vgisc/cryptech.hardware/schematics/rev02.pdf

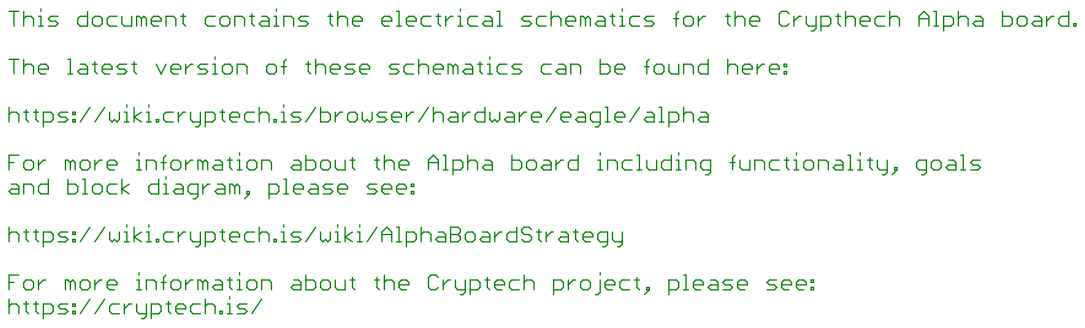
[picture p1: page 1]

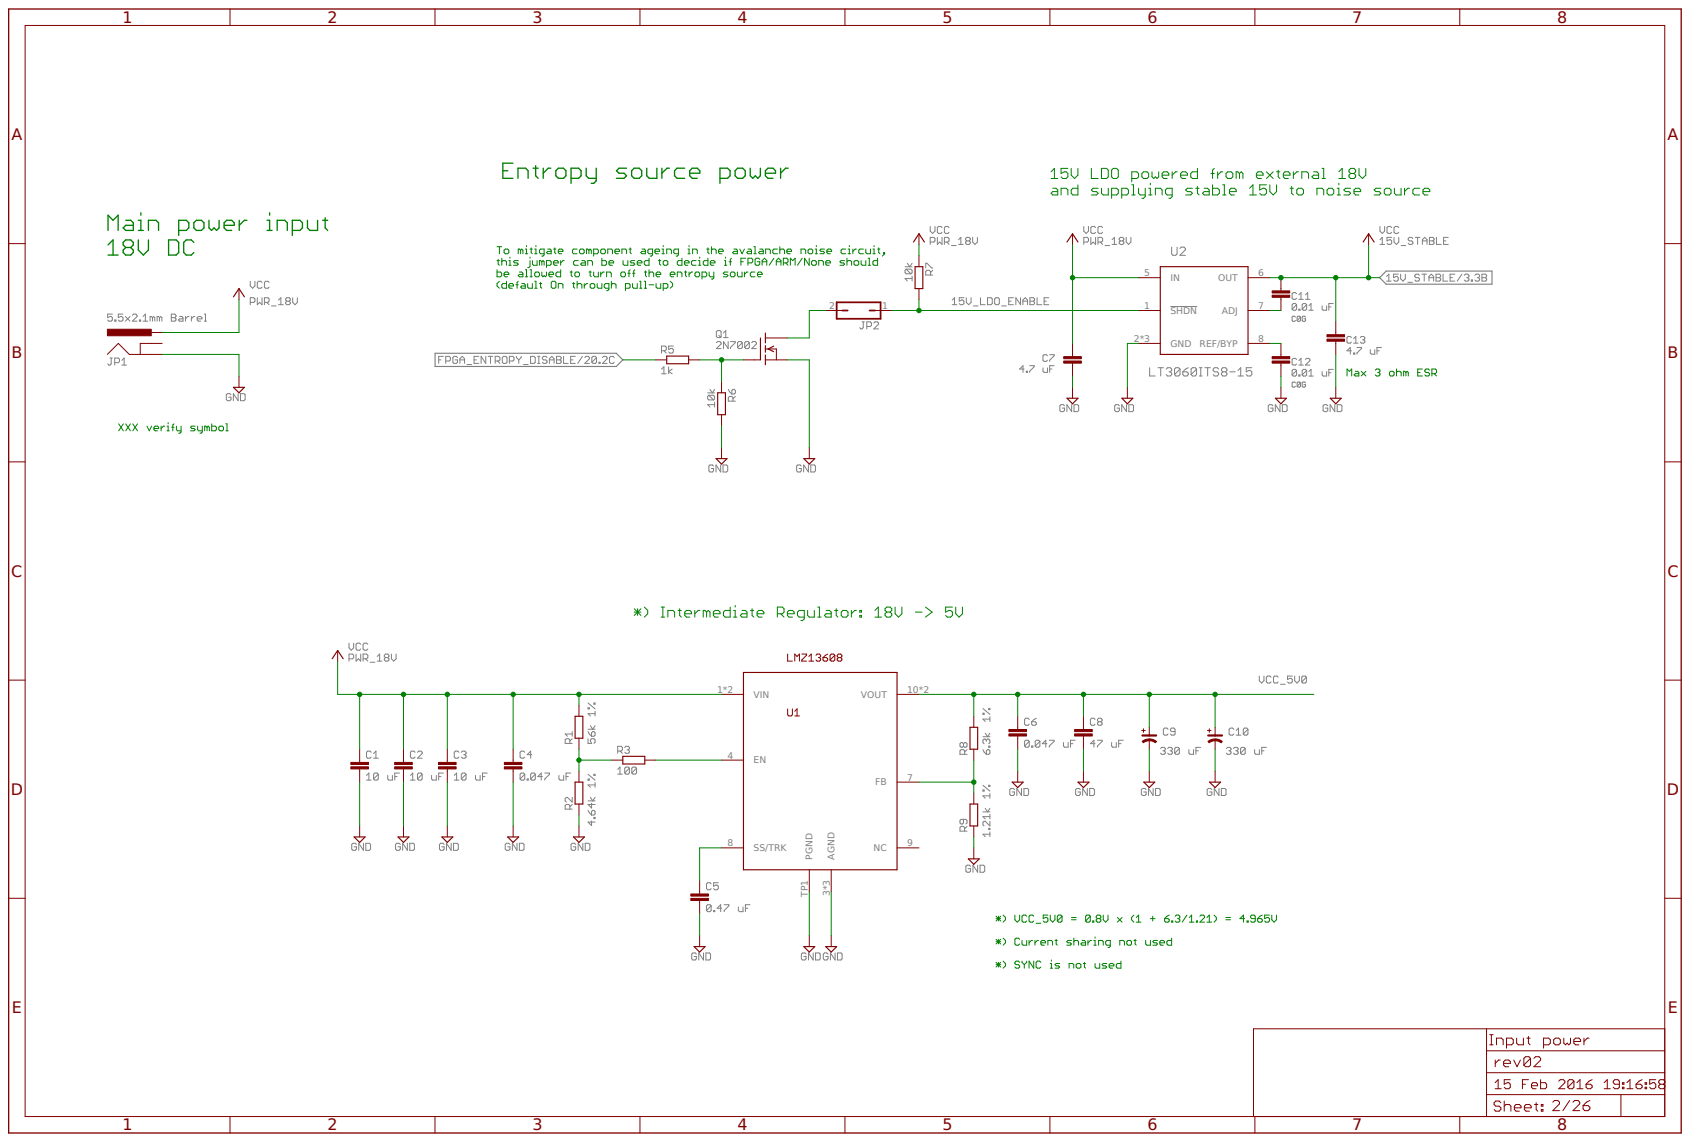
[picture p2: page 2]

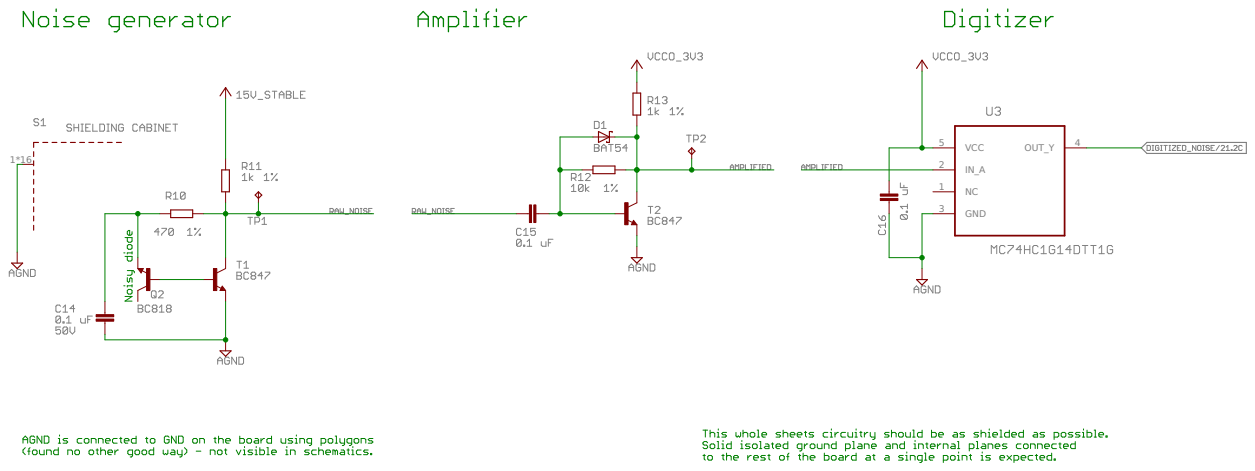
[picture p3: page 3]

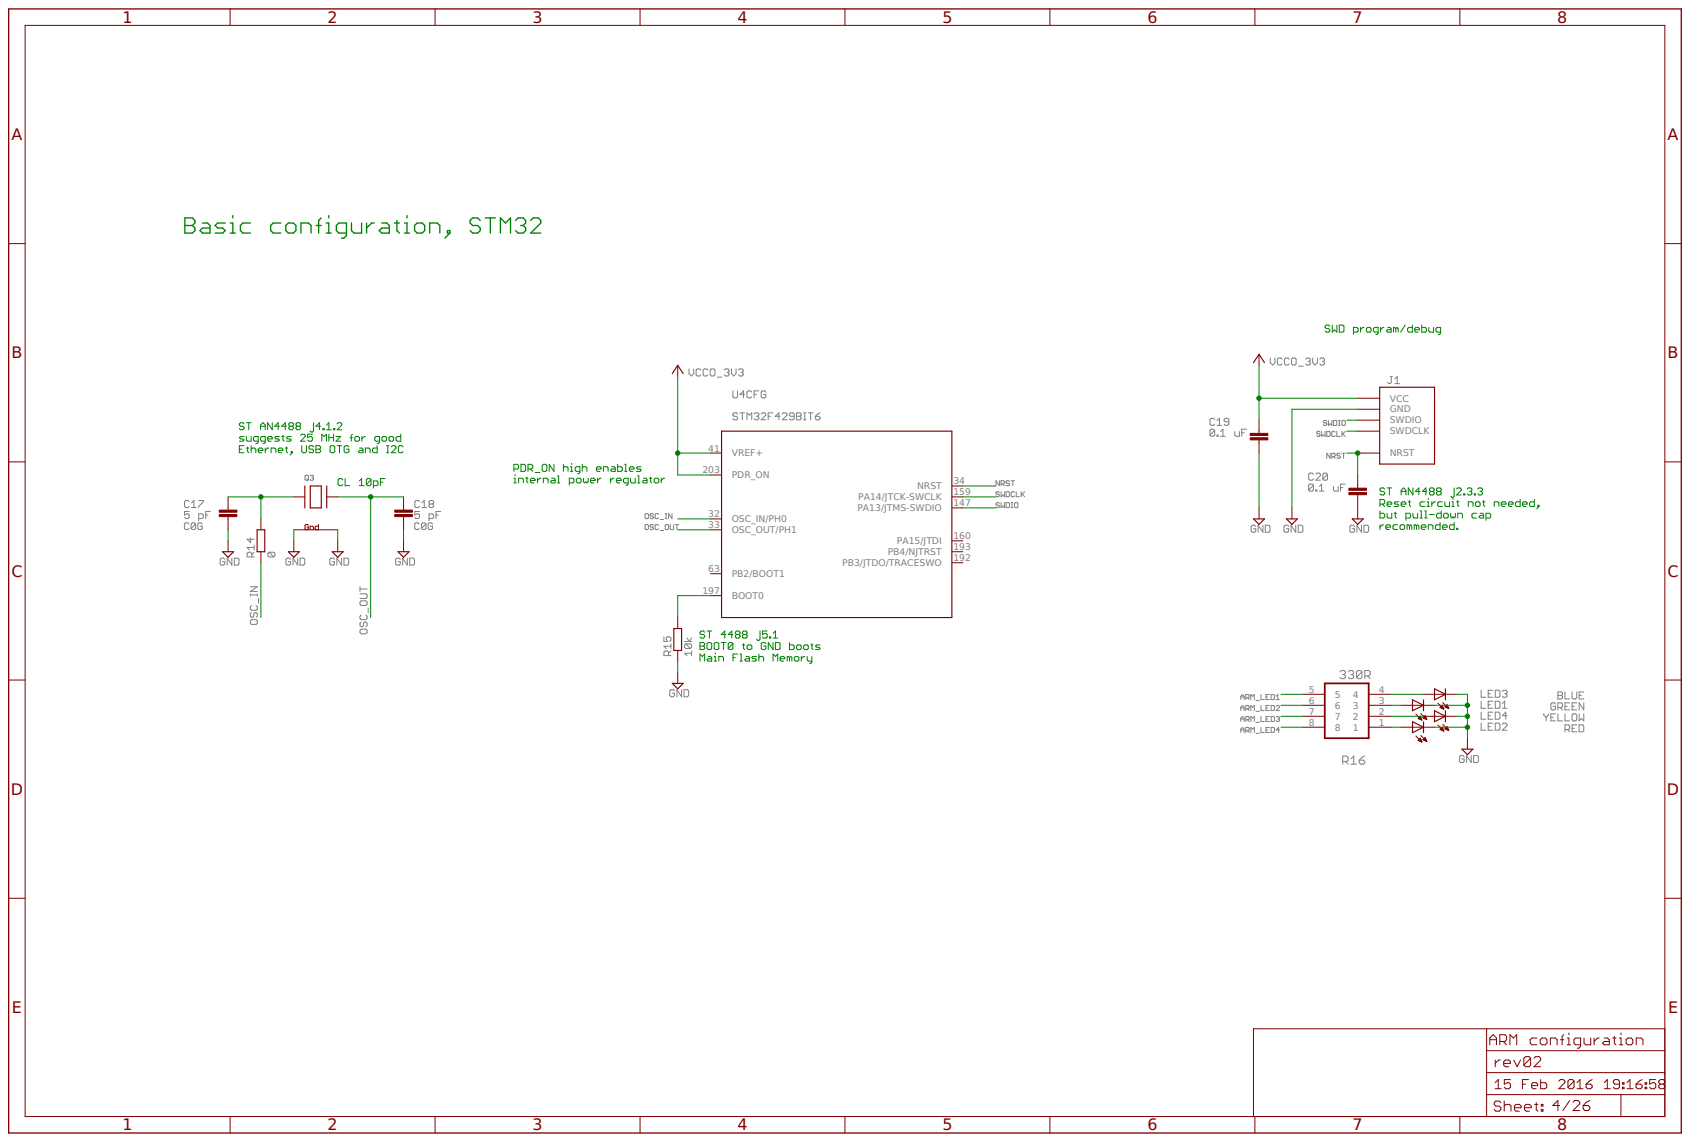
[picture p4: page 4]

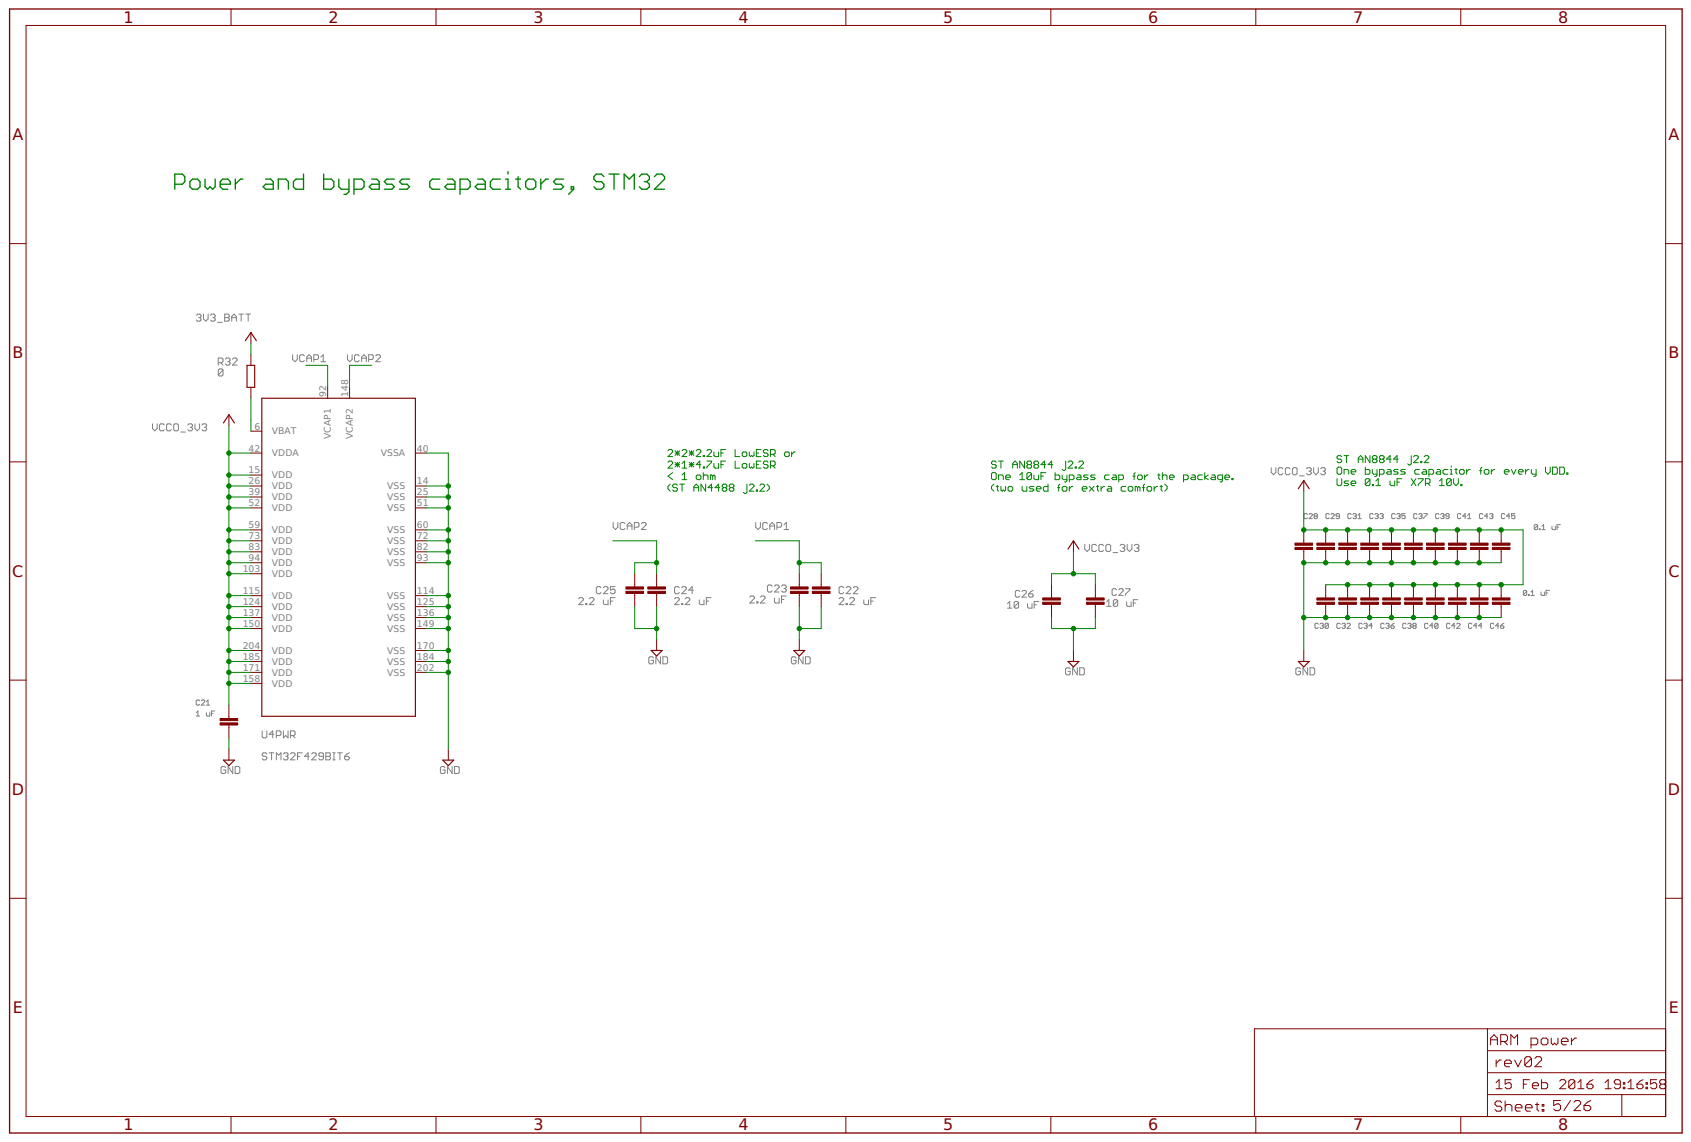
[picture p5: page 5]

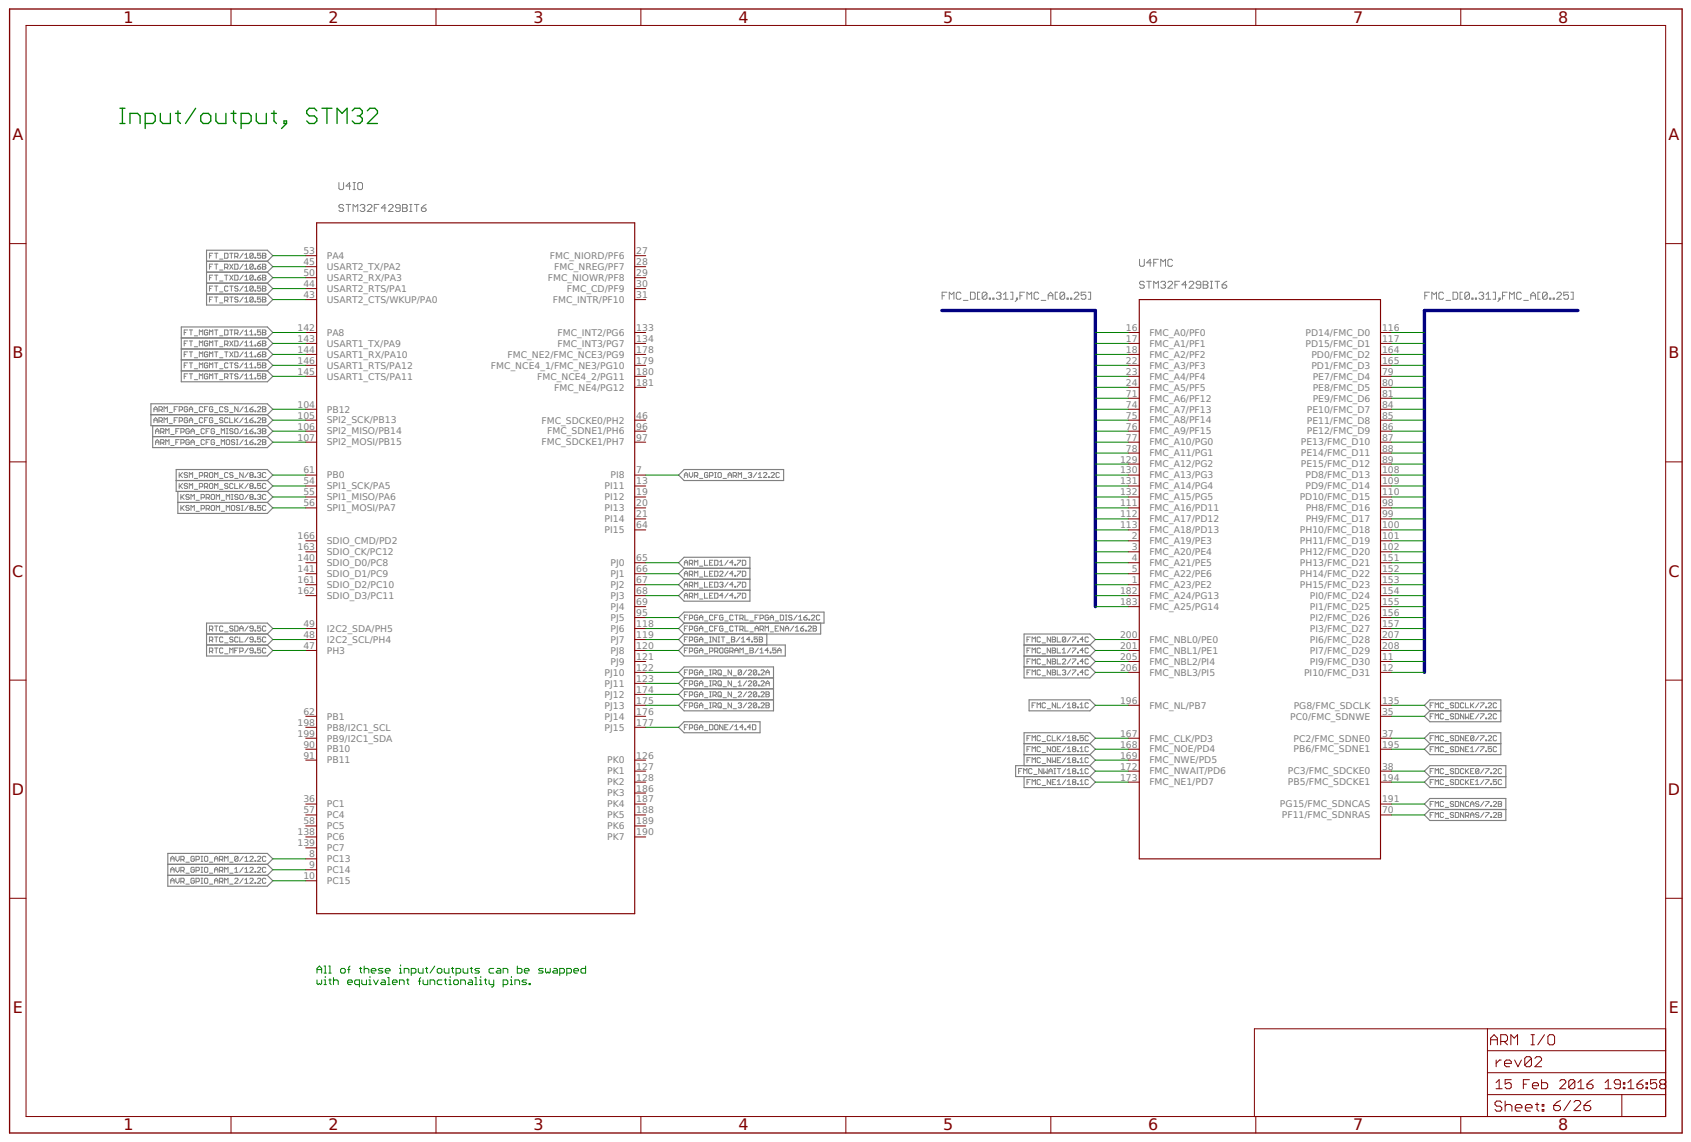
[picture p6: page 6]

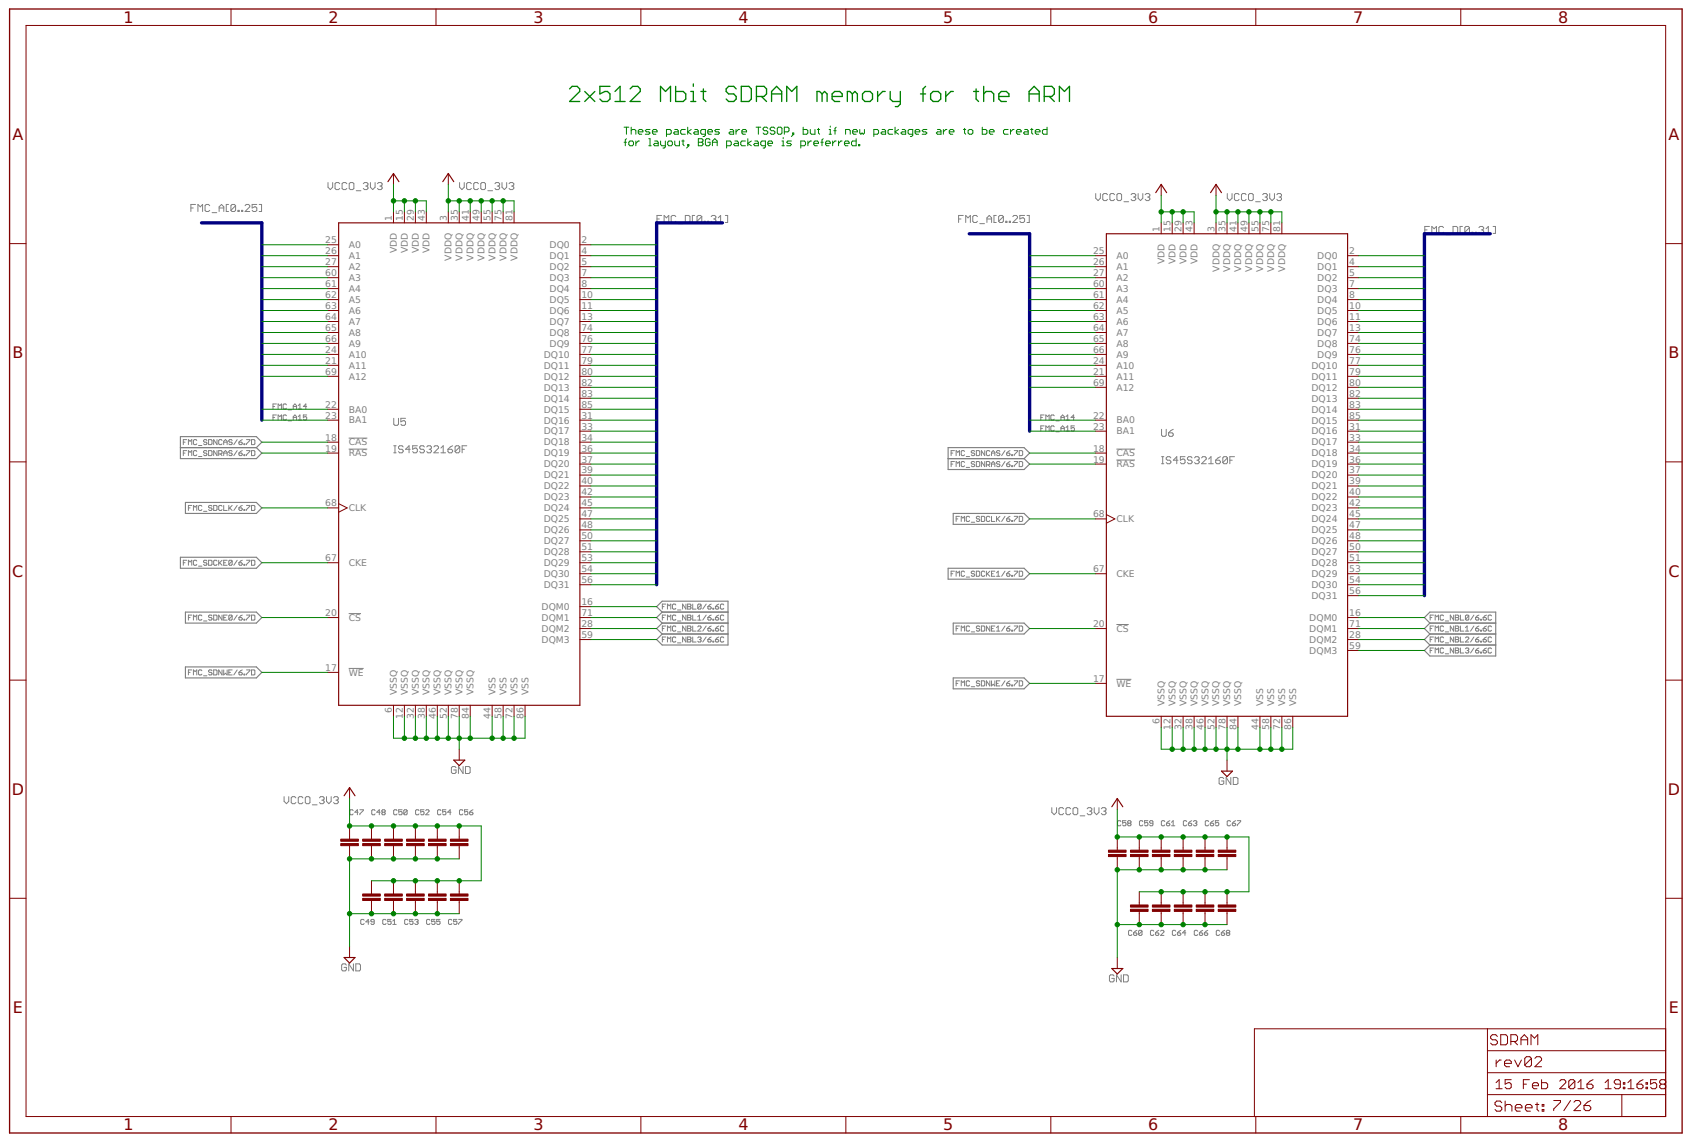
[picture p7: page 7]

VDD 1 DQ0 2 VDDQ 3 DQ1 4 DQ2 5 VSSQ 6 DQ3 7 DQ4 8 DQ5 10 DQ6 11 VSSQ 12 DQ7 13 VDD 15 DQM0 16 WE 17 CAS 18 RAS 19 CS 20 A11 21 BA0 22 BA1 23 A10 24 A0 25 A1 26 A2 27 DQM2 28 VDD 29 DQ16 31 VSSQ 32 DQ17 33 DQ18 34 VDDQ 35 DQ19 36 DQ20 37 VSSQ 38 DQ21 39 DQ22 40 VDDQ 41 DQ23 42 VDD 43 VSS 44 DQ24 45 VSSQ 46 DQ25 47 DQ26 48 VDDQ 49 DQ27 50 DQ28 51 VSSQ 52 DQ29 53 DQ30 54 VDDQ 55 DQ31 56 VSS 58 DQM3 59 A3 60 A4 61 A5 62 A6 63 A7 64 A8 65 A9 66 CKE 67 CLK 68 A12 69 DQM1 71 VSS 72 DQ8 74 VDDQ 75 DQ9 76 DQ10 77 VSSQ 78 DQ11 79 DQ12 80 VDDQ 81 DQ13 82 DQ14 83 VSSQ 84 DQ15 85 VSS 86 VDD 1 DQ0 2 VDDQ 3 DQ1 4 DQ2 5 VSSQ 6 DQ3 7 DQ4 8 DQ5 10 DQ6 11 VSSQ 12 DQ7 13 VDD 15 DQM0 16 WE 17 CAS 18 RAS 19 CS 20 A11 21 BA0 22 BA1 23 A10 24 A0 25 A1 26 A2 27 DQM2 28 VDD 29 DQ16 31 VSSQ 32 DQ17 33 DQ18 34 VDDQ 35 DQ19 36 DQ20 37 VSSQ 38 DQ21 39 DQ22 40 VDDQ 41 DQ23 42 VDD 43 VSS 44 DQ24 45 VSSQ 46 DQ25 47 DQ26 48 VDDQ 49 DQ27 50 DQ28 51 VSSQ 52 DQ29 53 DQ30 54 VDDQ 55 DQ31 56 VSS 58 DQM3 59 A3 60 A4 61 A5 62 A6 63 A7 64 A8 65 A9 66 CKE 67 CLK 68 A12 69 DQM1 71 VSS 72 DQ8 74 VDDQ 75 DQ9 76 DQ10 77 VSSQ 78 DQ11 79 DQ12 80 VDDQ 81 DQ13 82 DQ14 83 VSSQ 84 DQ15 85 VSS 86 ABCDE 1 2 3 4 5 6 7 8 ABCDE 1 2 3 4 5 6 7 8

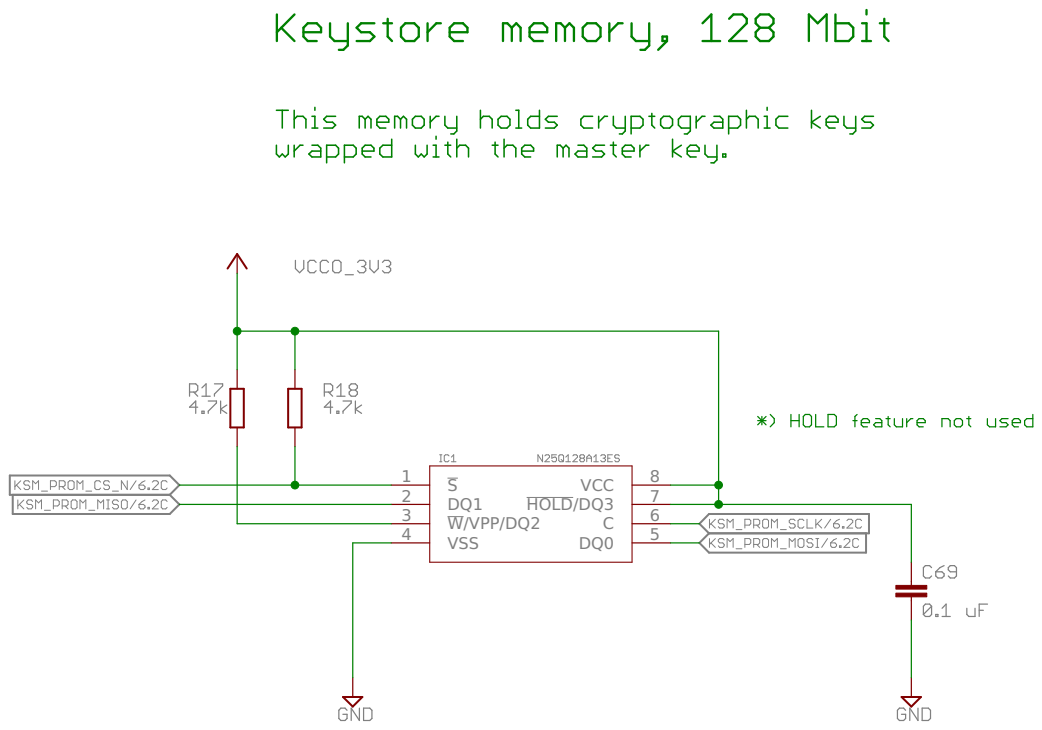
[picture p8: page 8]

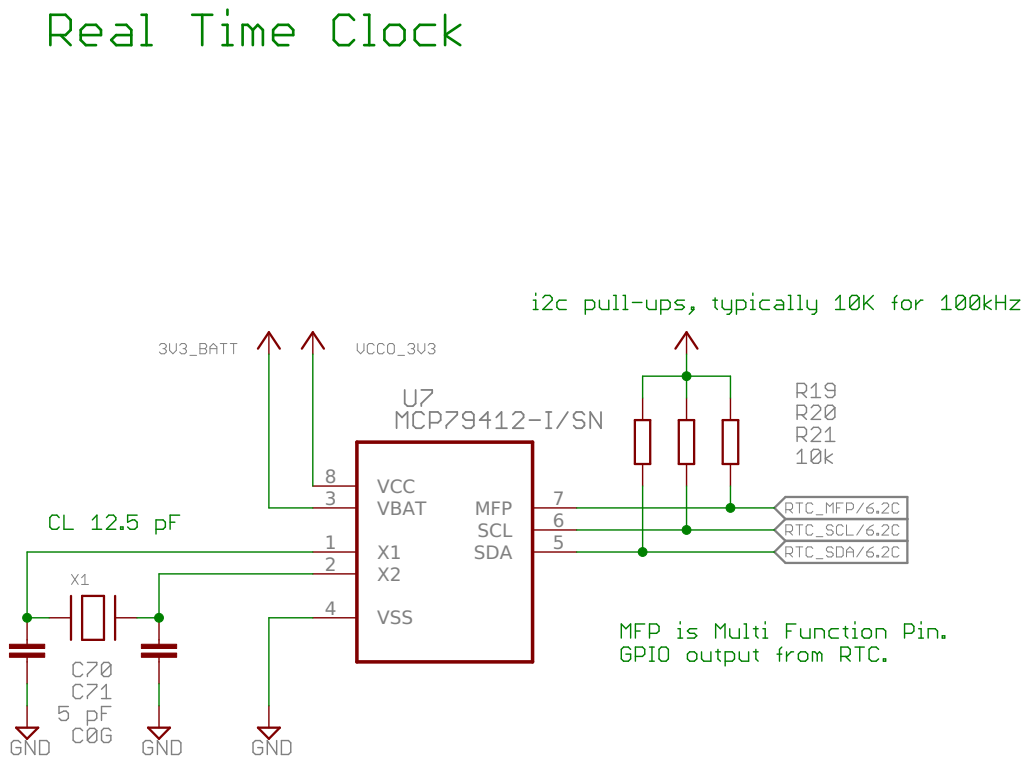
[picture p9: page 9]

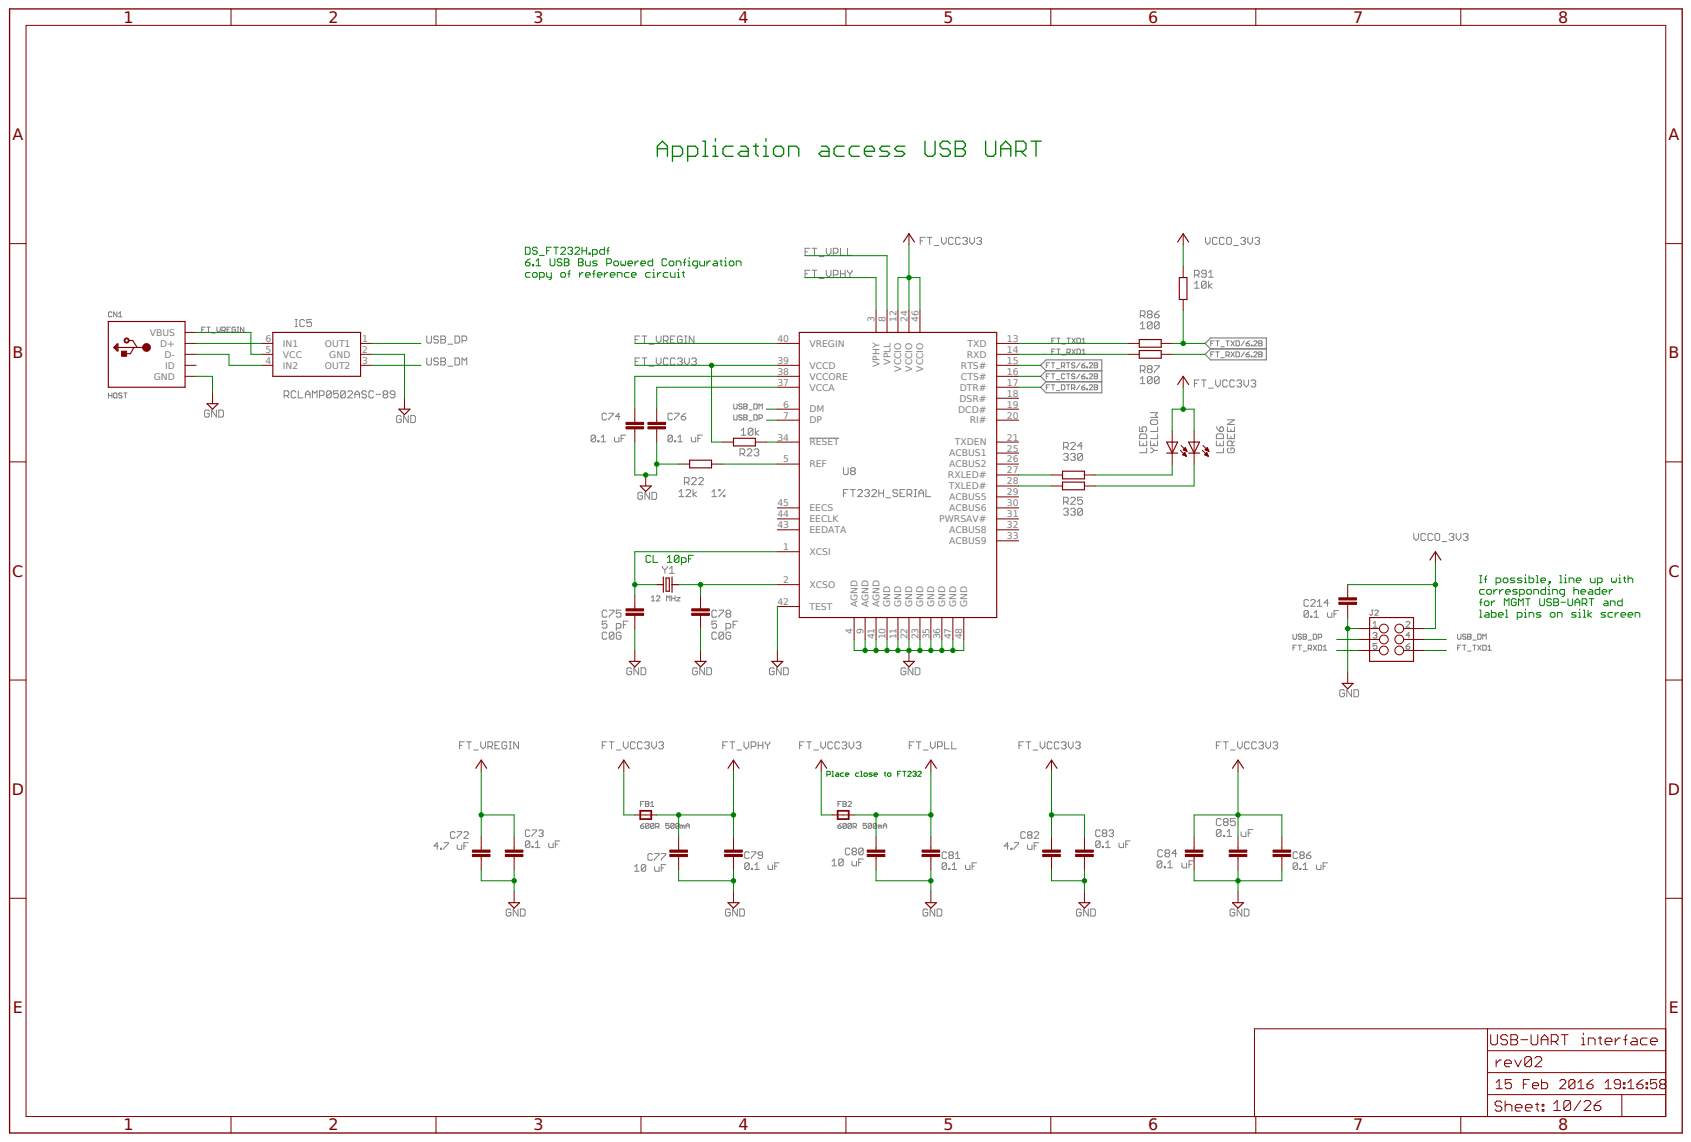
[picture p10: page 10]

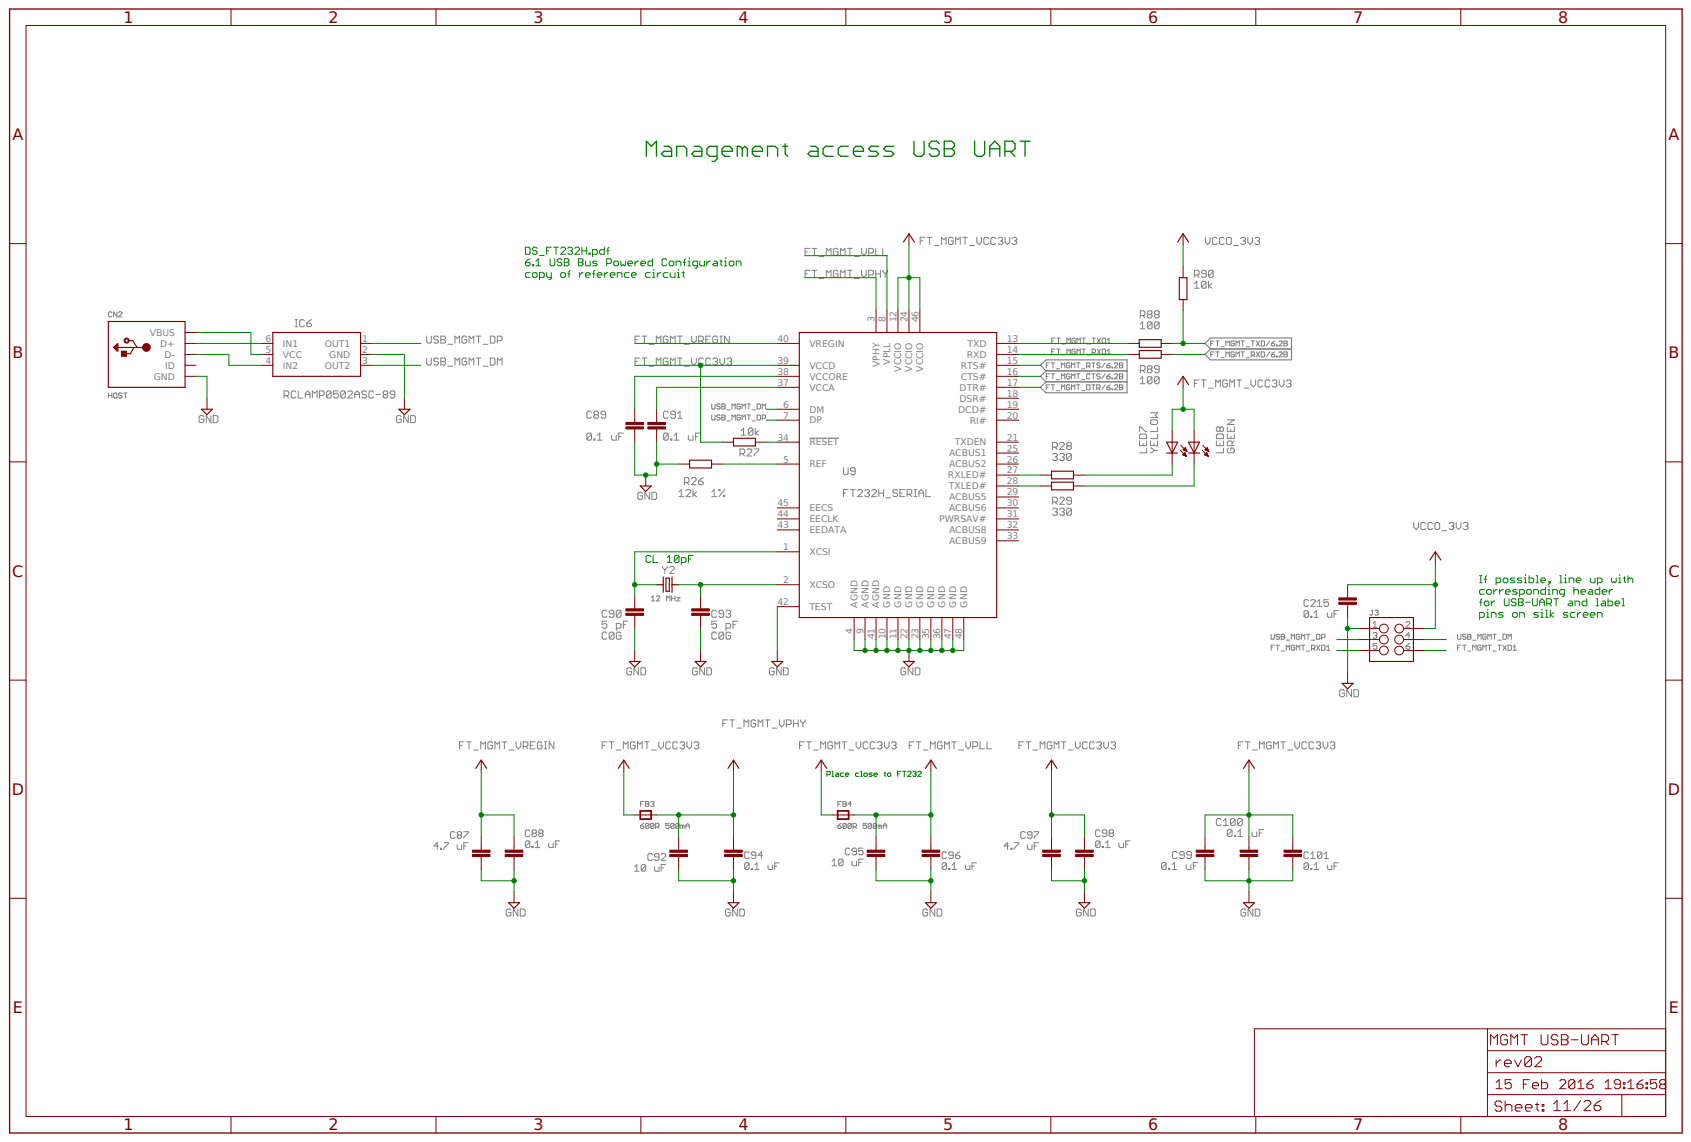
[picture p11: page 11]

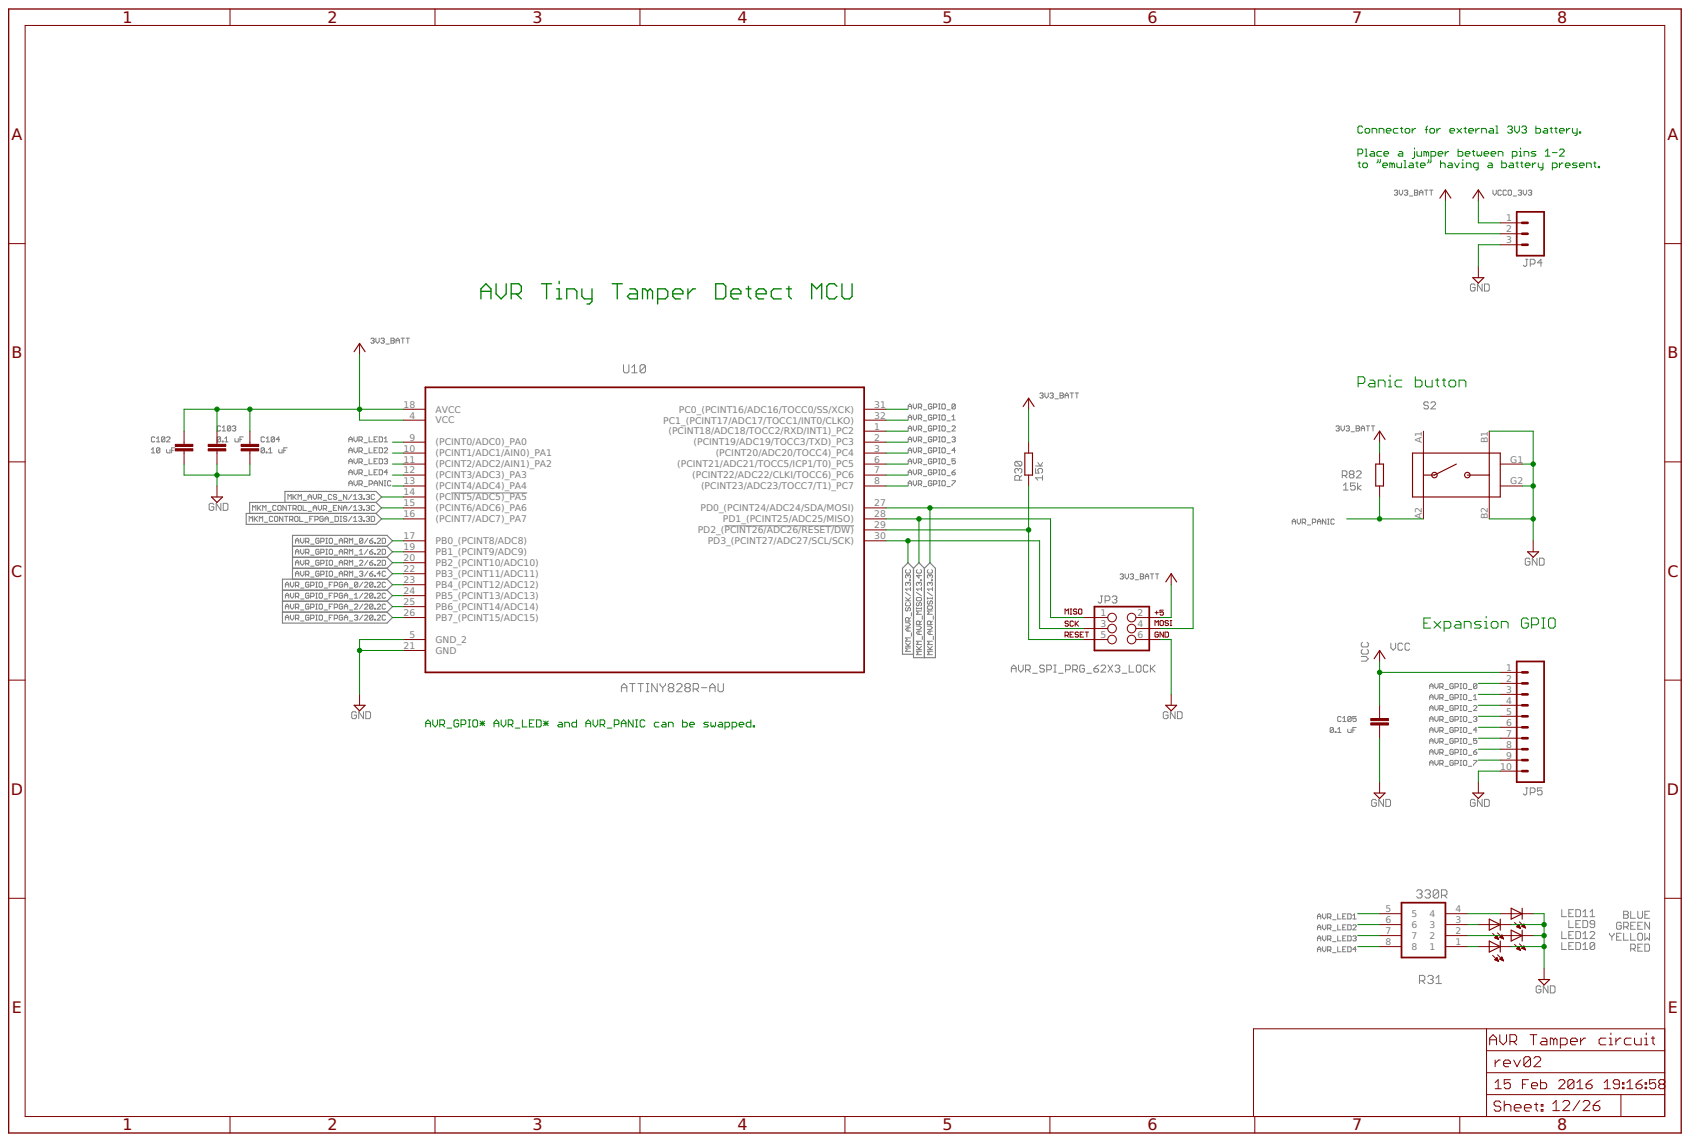
[picture p12: page 12]

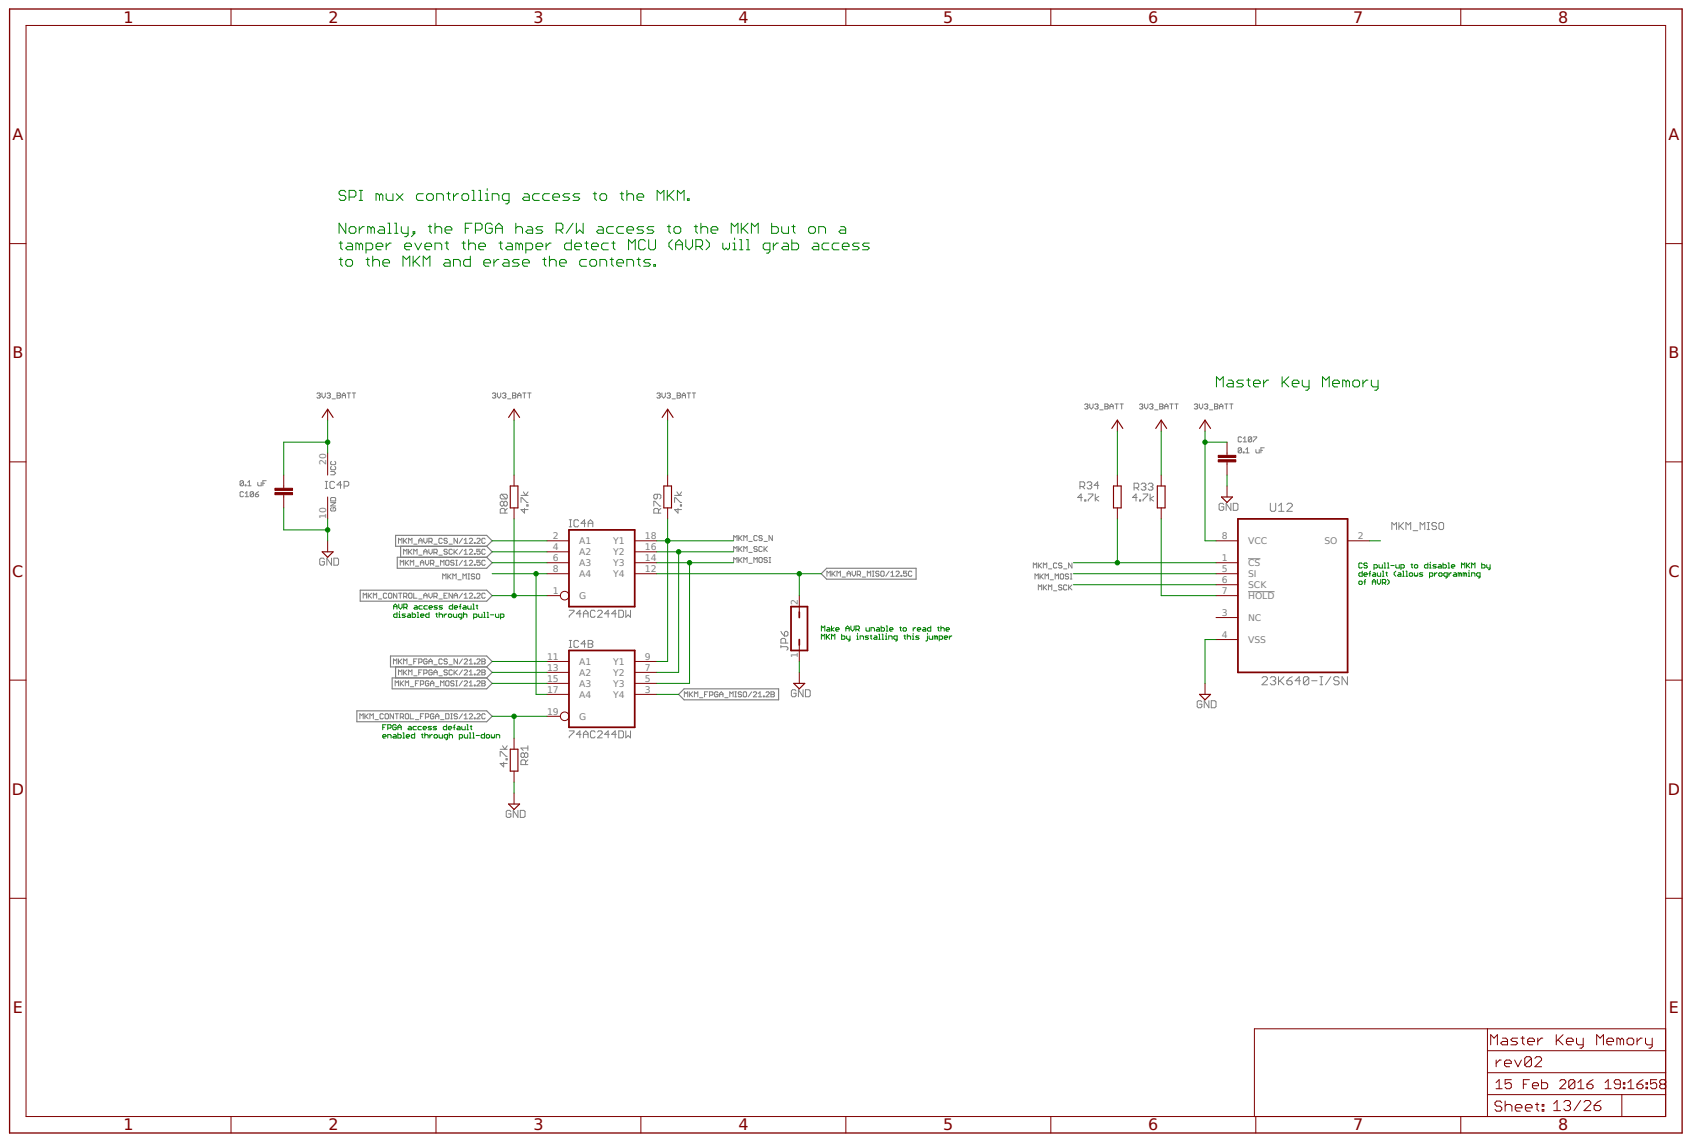
[picture p13: page 13]

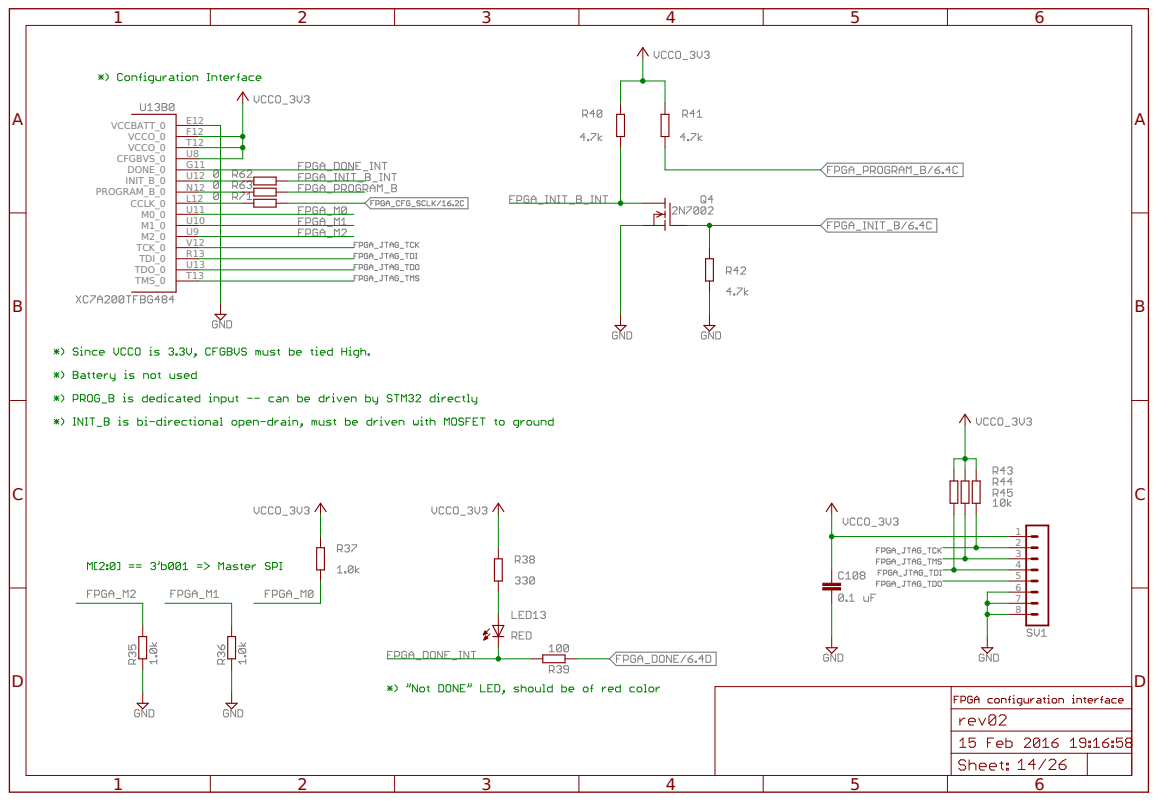
[picture p14: page 14]

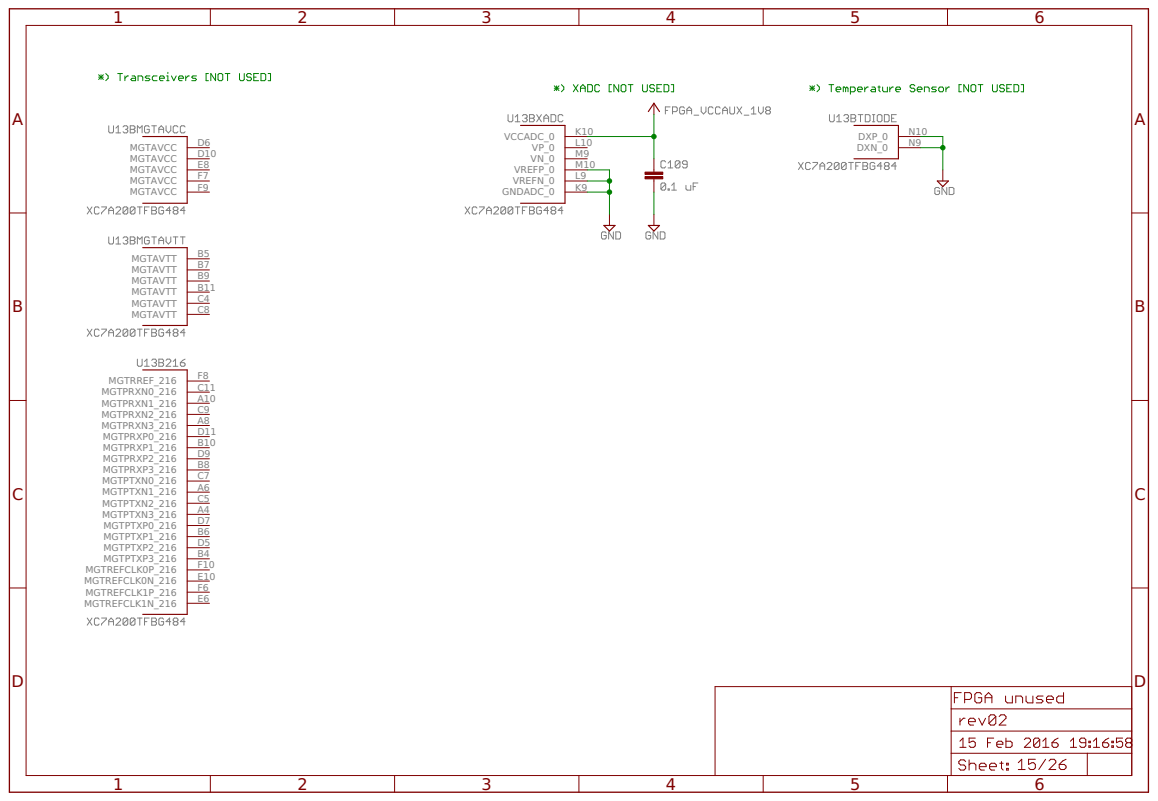
[picture p15: page 15]

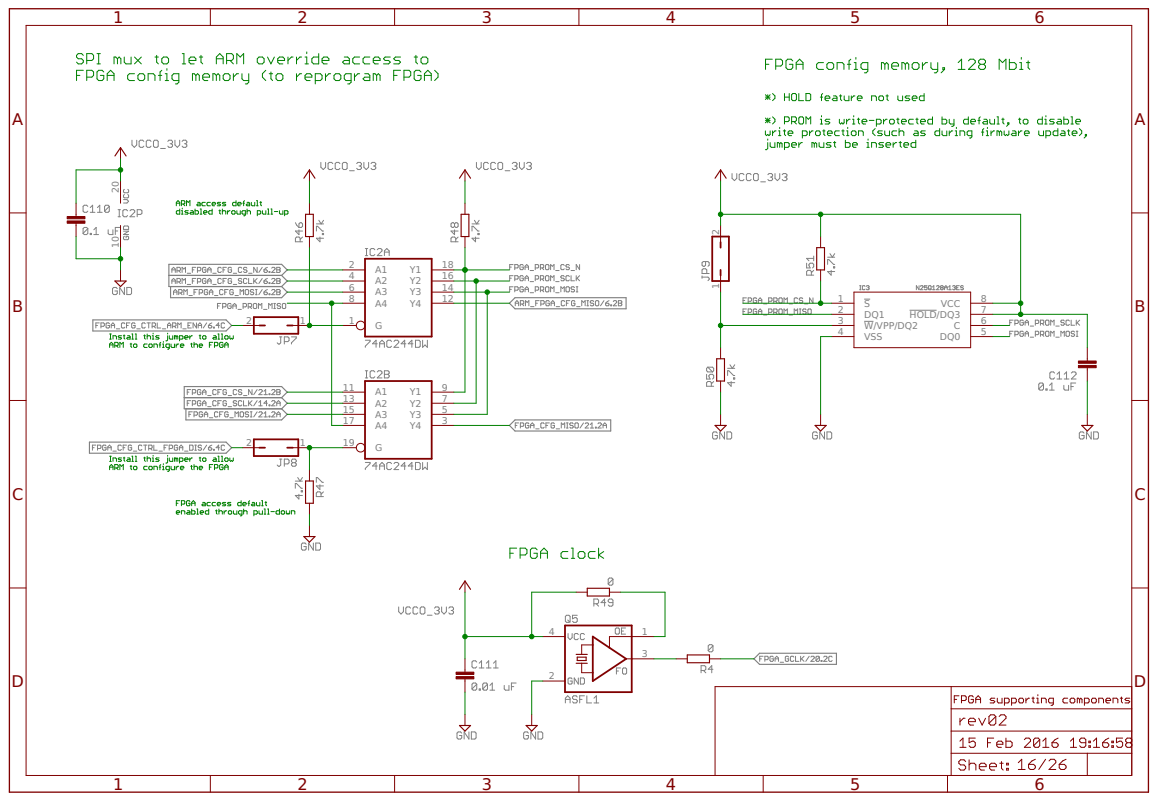
[picture p16: page 16]

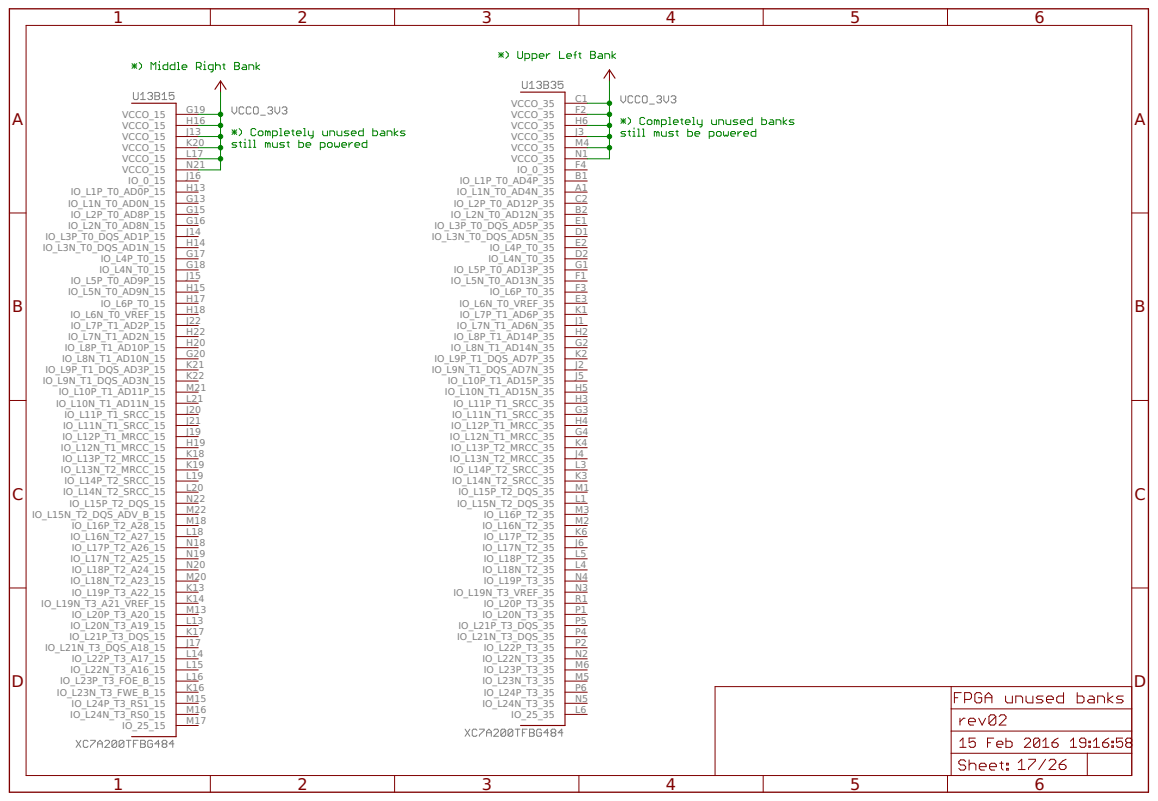
[picture p17: page 17]

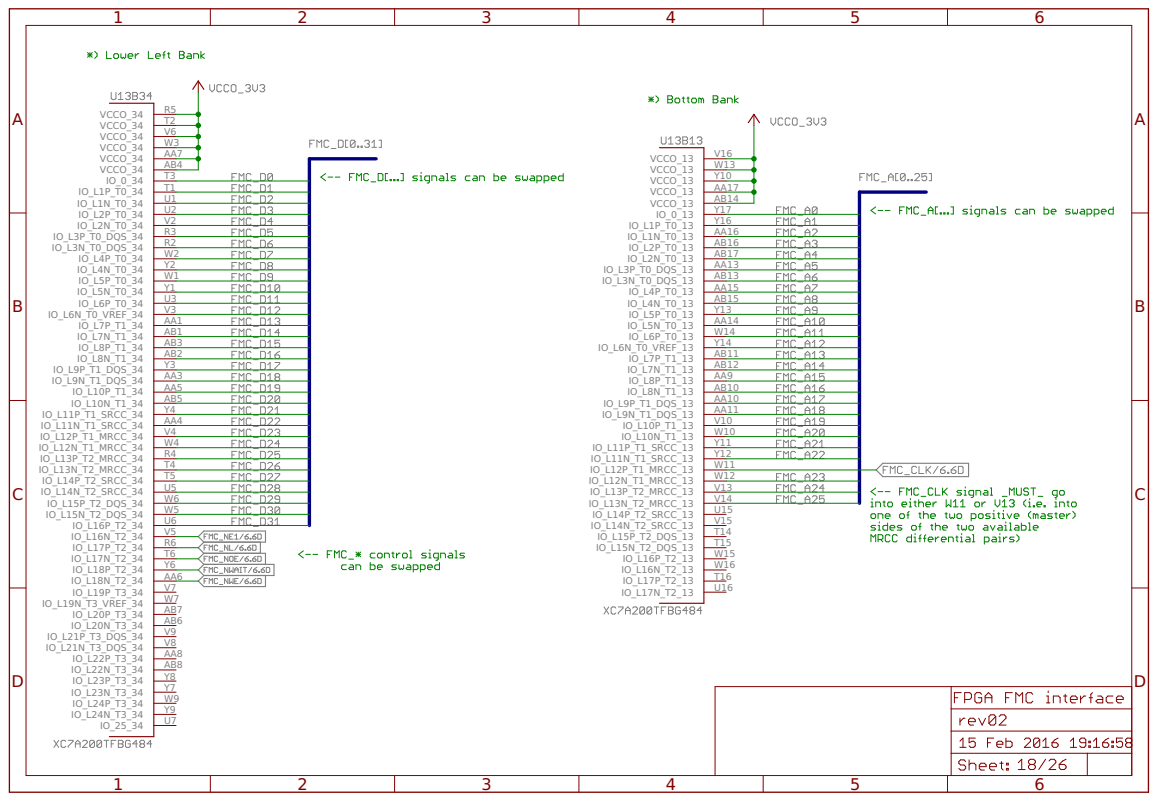
[picture p18: page 18]

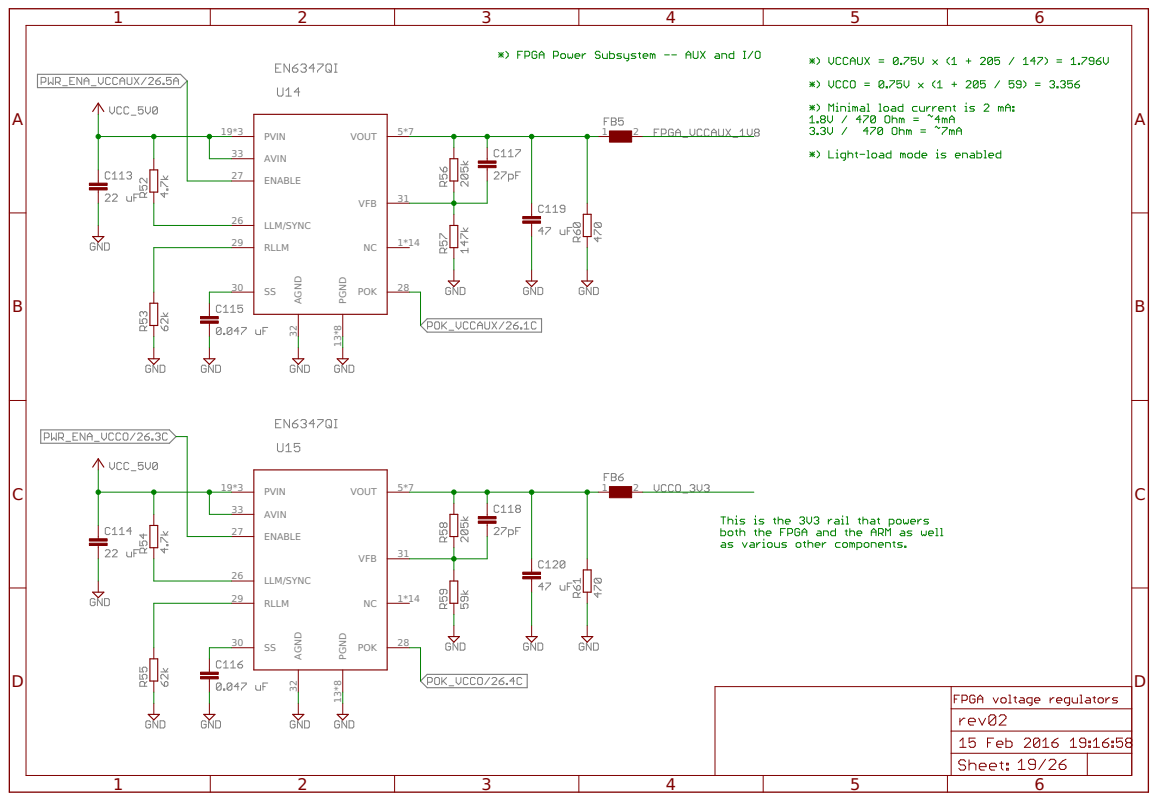
[picture p19: page 19]

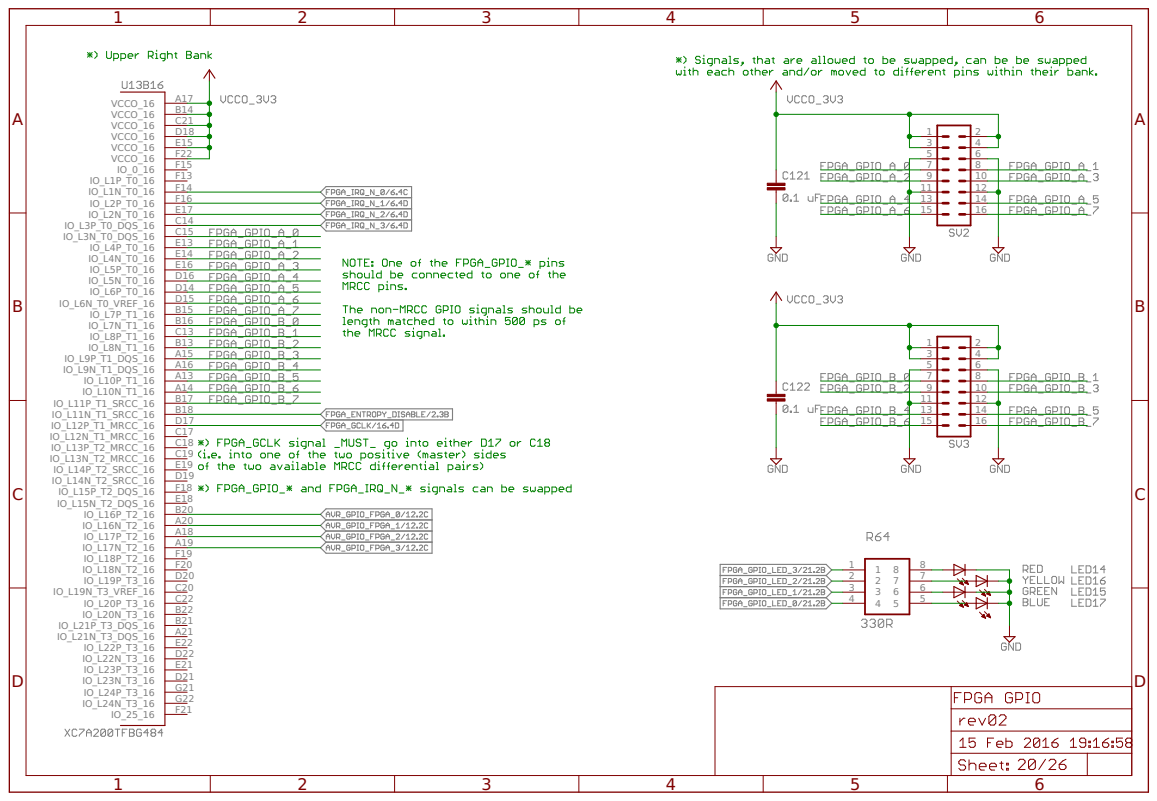
[picture p20: page 20]

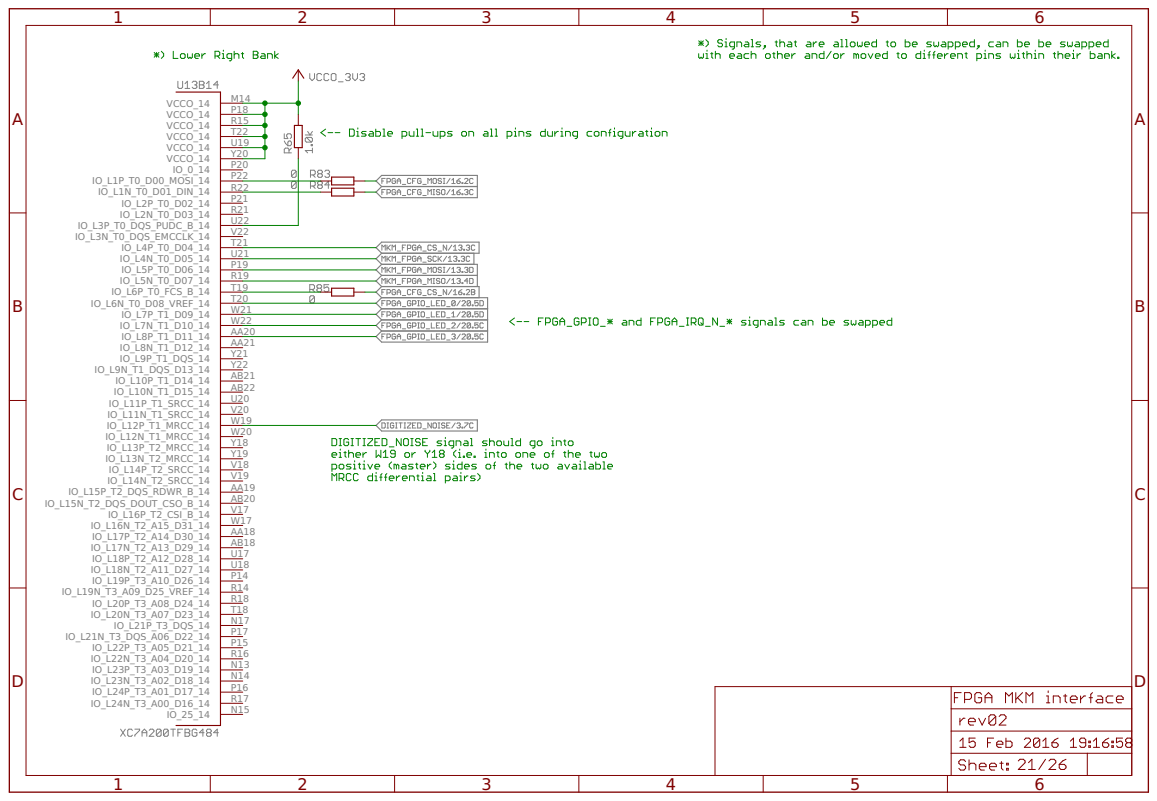
[picture p21: page 21]

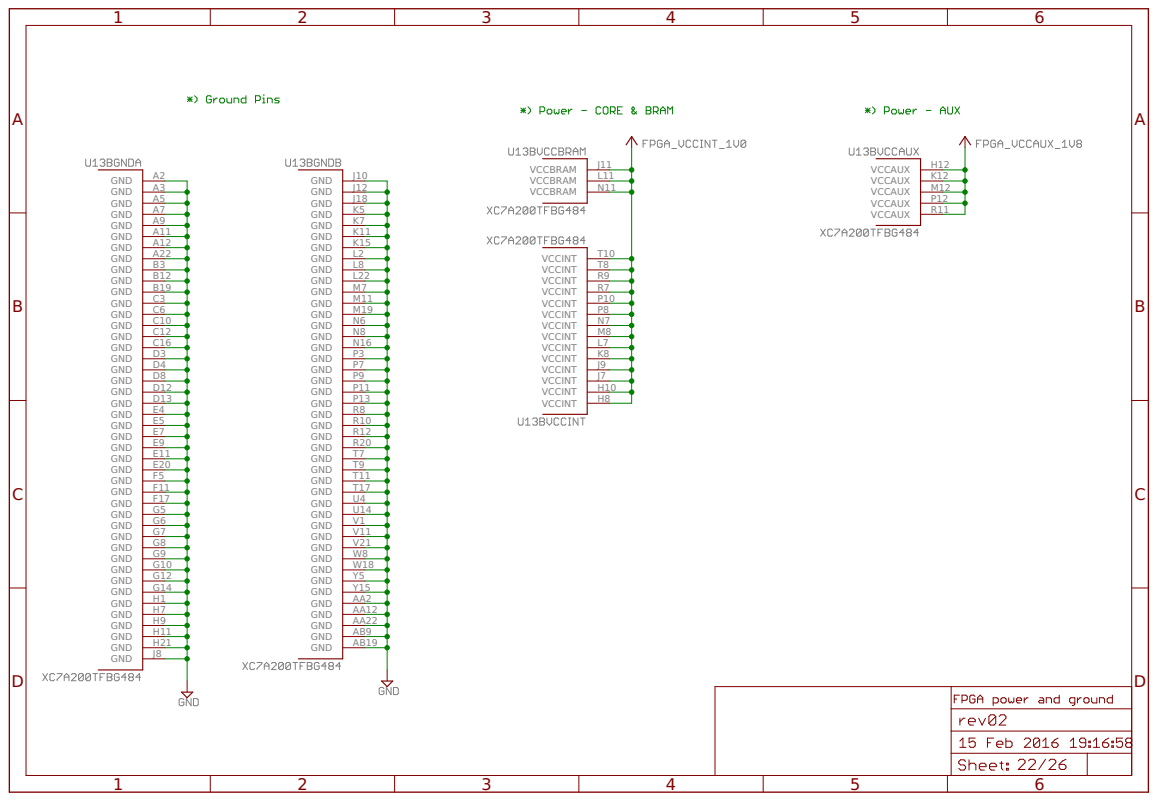
[picture p22: page 22]

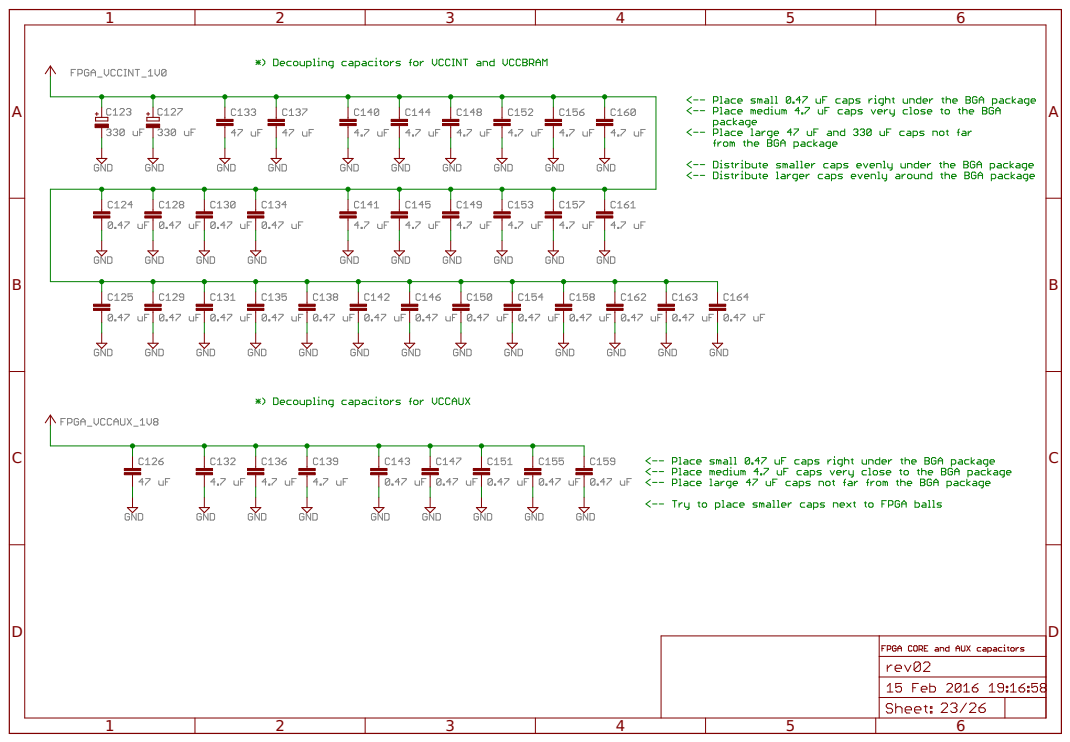
[picture p23: page 23]

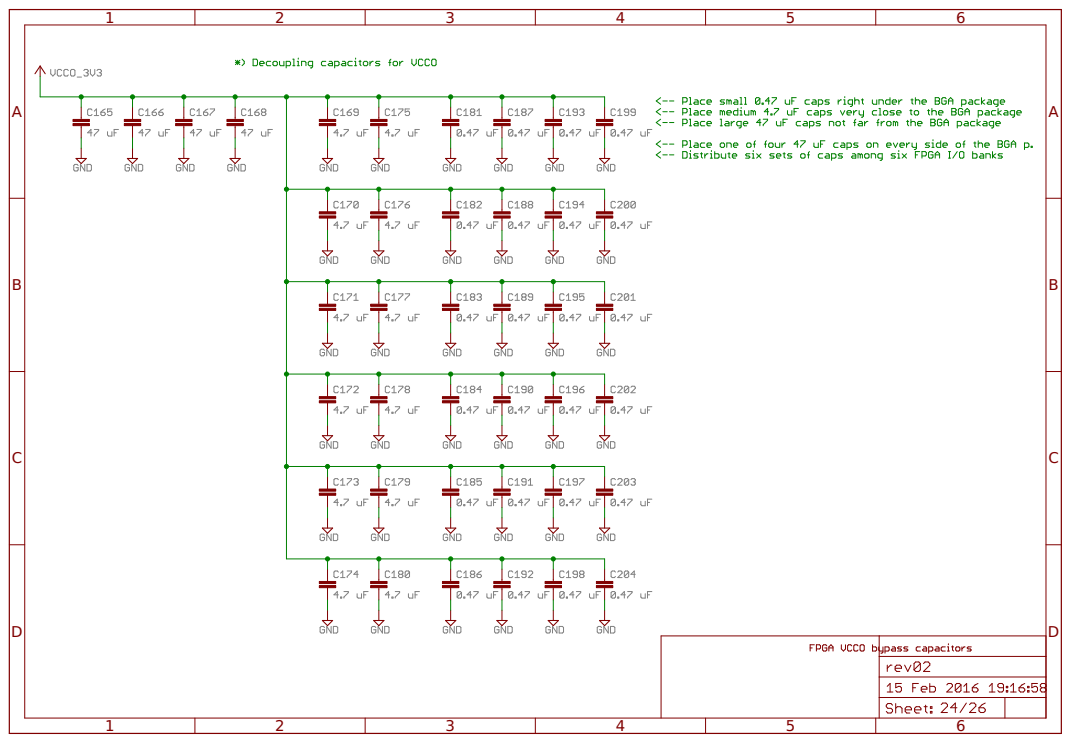
[picture p24: page 24]

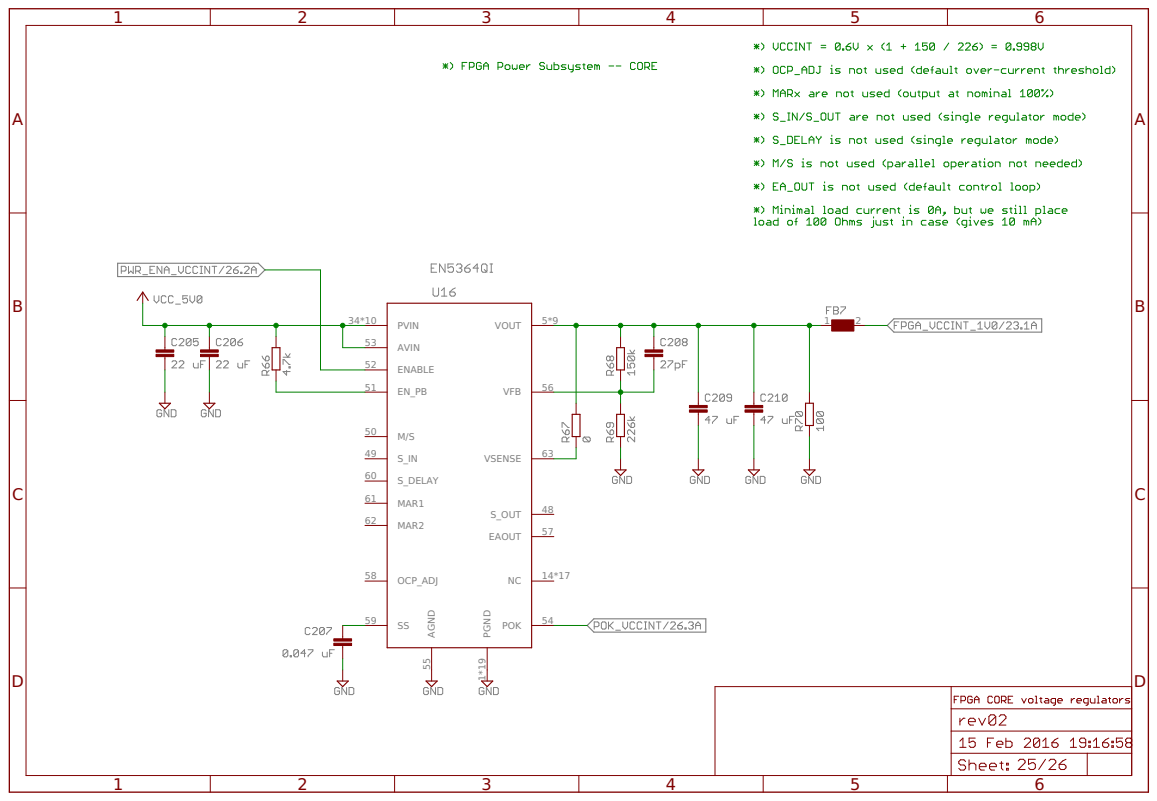
[picture p25: page 25]

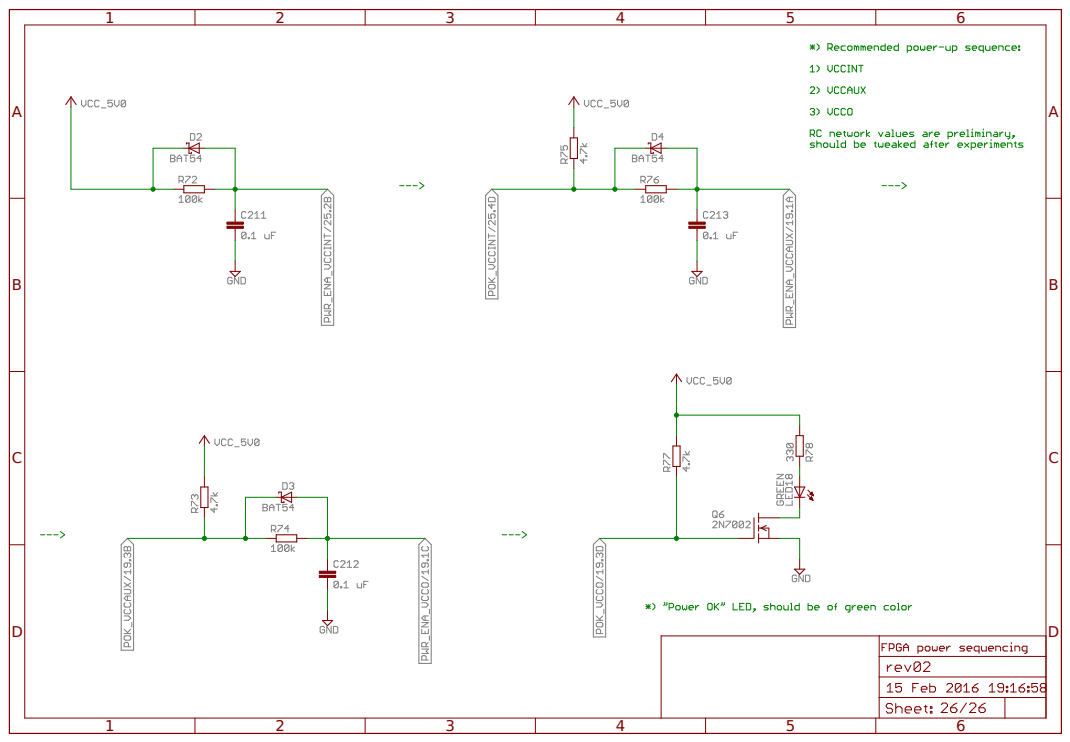
[picture p26: page 26]
