vgisc/cryptech.hardware/production_files/alpha/rev03/Cryptech Assembly Drawings.pdf

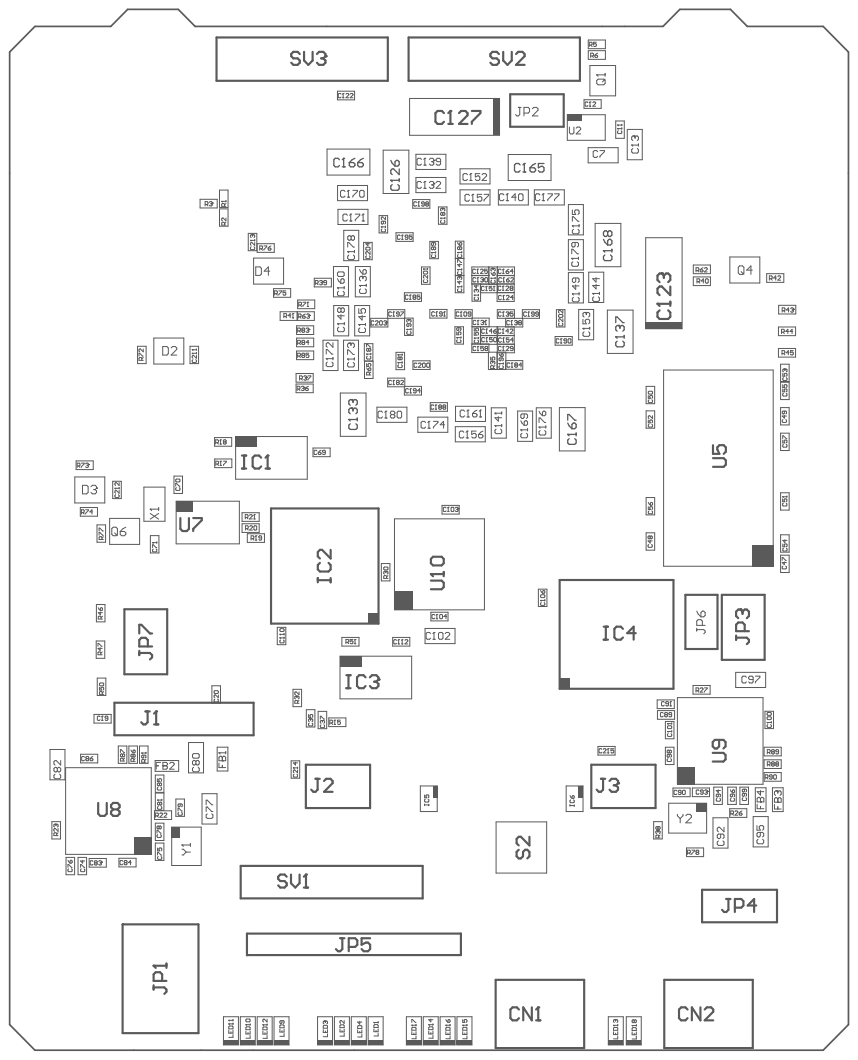
[picture p27: page 1]

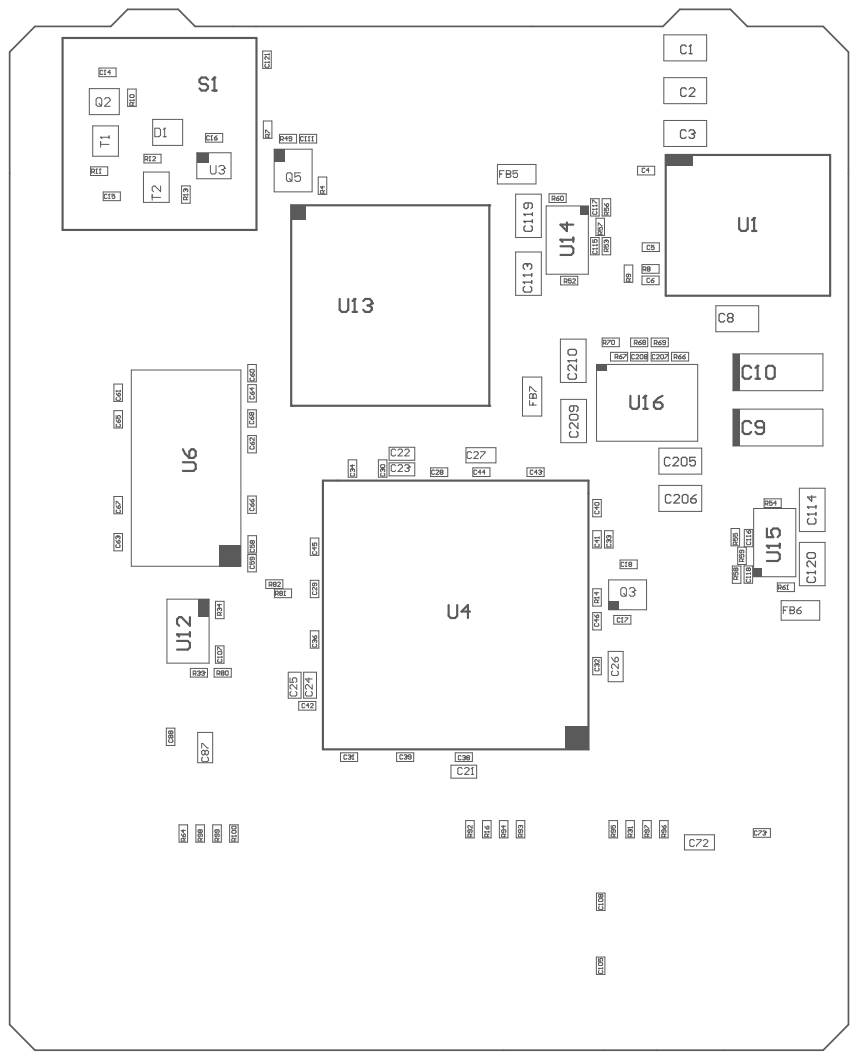
[picture p28: page 2]
