vgisc/cryptech.hardware/production_files/alpha/rev03/Cryptech Drill Drawing.pdf

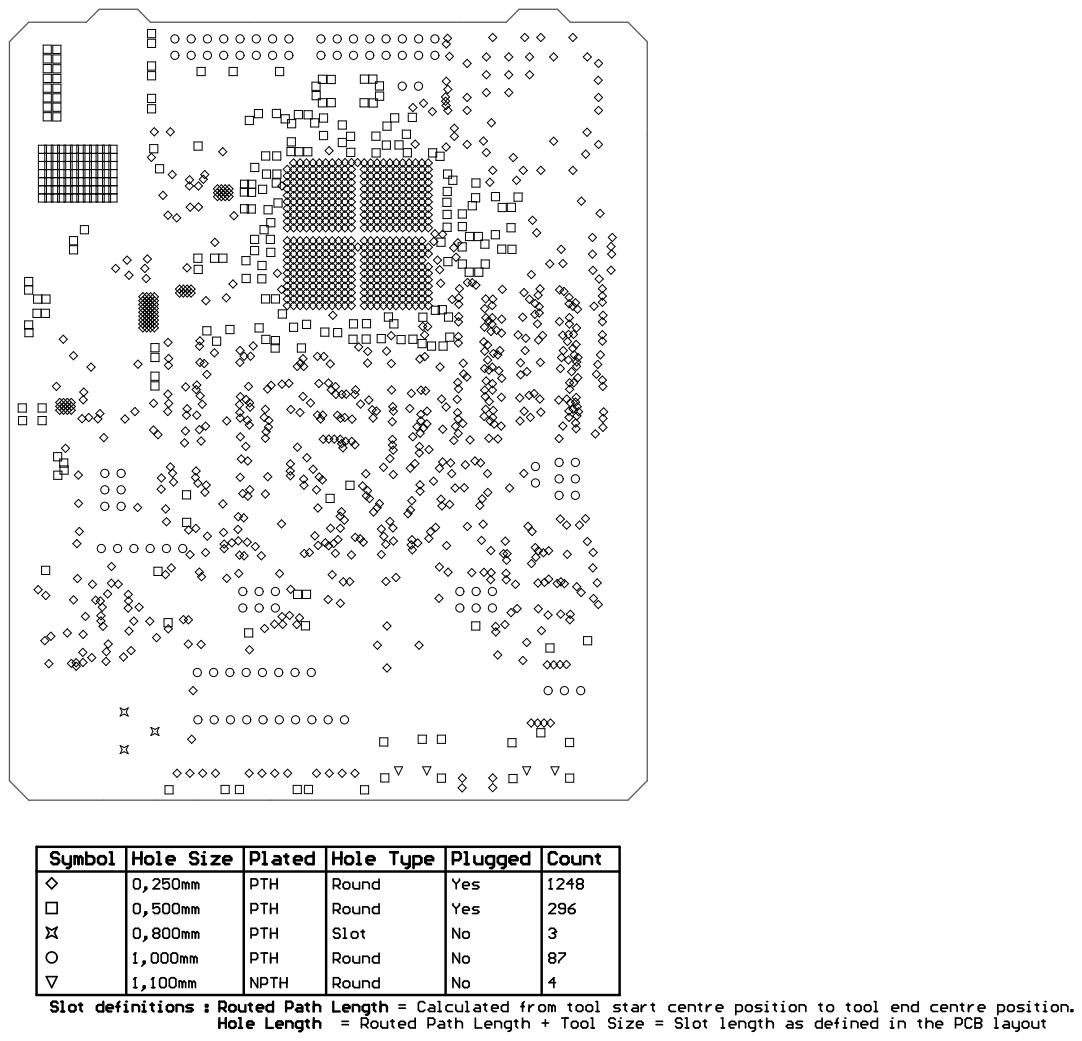
[picture p29: page 1]
