vgisc/cryptech.hardware/(list of files, drawings)

Other design files:
cad/rev03/CHIPS.PcbLib
cad/rev03/Connectors.PcbLib
cad/rev03/rev02.PcbLib
cad/rev03/rev02.PrjPcb
cad/rev03/rev02_0.SchDoc
cad/rev03/rev02_1.SchDoc
cad/rev03/rev02_1.SCHLIB
cad/rev03/rev02_2.SchDoc
cad/rev03/rev02_3.SchDoc
cad/rev03/rev02_4.SchDoc
cad/rev03/rev02_5.SchDoc
cad/rev03/rev02_6.SchDoc
cad/rev03/rev02_7.SchDoc
cad/rev03/rev02_8.SchDoc
cad/rev03/rev02_9.SchDoc
cad/rev03/rev02_10.SchDoc
cad/rev03/rev02_11.SchDoc
cad/rev03/rev02_12.SchDoc
cad/rev03/rev02_13.SchDoc
cad/rev03/rev02_14.SchDoc
cad/rev03/rev02_15.SchDoc
cad/rev03/rev02_16.SchDoc
cad/rev03/rev02_17.SchDoc
cad/rev03/rev02_18.SchDoc
cad/rev03/rev02_19.SchDoc
cad/rev03/rev02_20.SchDoc
cad/rev03/rev02_21.SchDoc
cad/rev03/rev02_22.SchDoc
cad/rev03/rev02_23.SchDoc
cad/rev03/rev02_24.SchDoc
cad/rev03/rev02_25.SchDoc
