vgisc/cryptech.hardware/cad/rev02/alpha/rev02/rev02.brd

## EAGLE design cad/rev02/alpha/rev02/rev02.brd (2016-02-15, an earlier design)

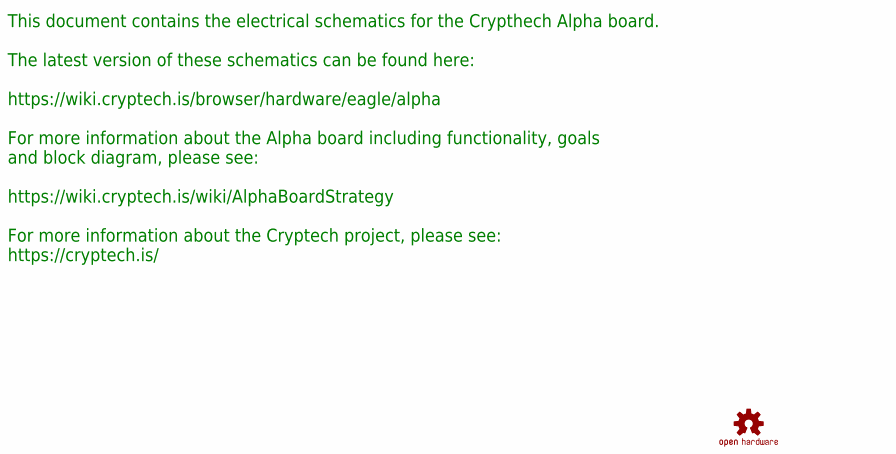
[picture p30: schematic rev02.sch, sheet 1]

Parts:
LOGO1: OSHW-LOGOL-COPPER; OSHW-LOGO-L_COPPER

Notes on the sheet:
This document contains the electrical schematics for the Crypthech Alpha board. The latest version of these schematics can be found here: https://wiki.cryptech.is/browser/hardware/eagle/alpha For more information about the Alpha board including functionality, goals and block diagram, please see: ht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

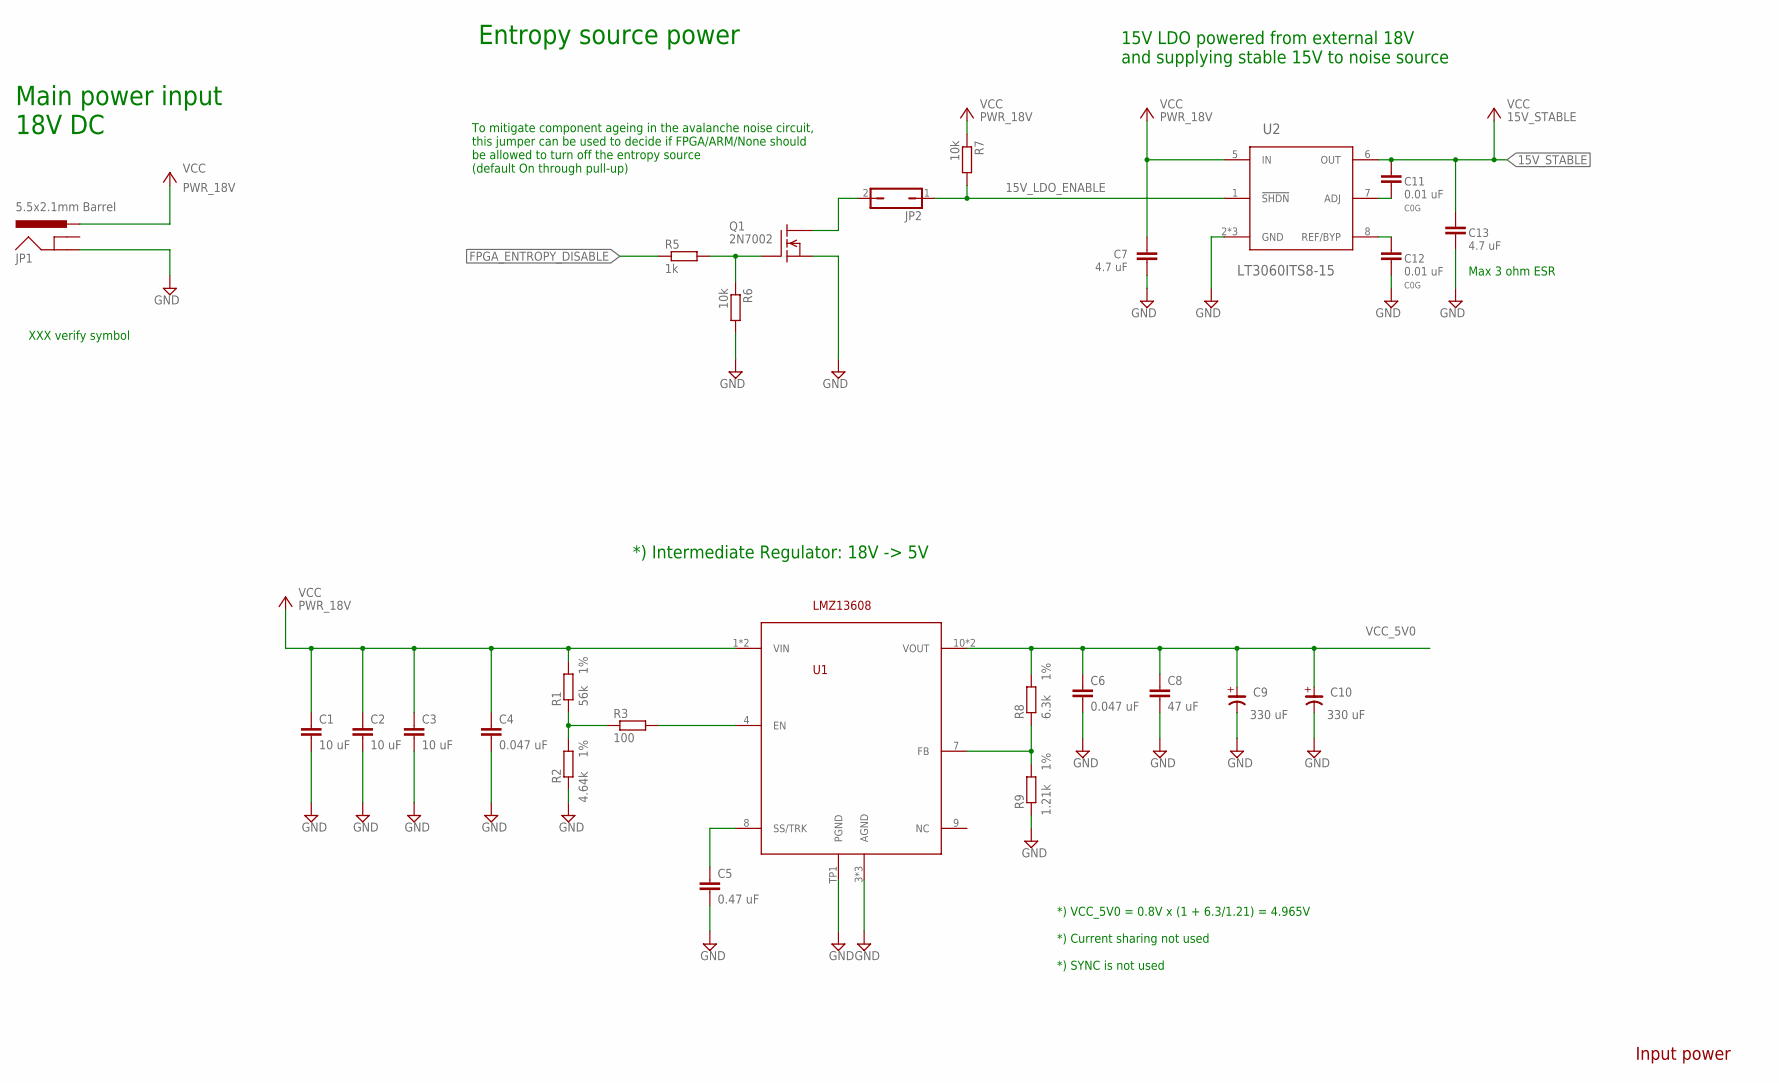
[picture p31: schematic rev02.sch, sheet 2, Input power]

Parts:
C1, C2, C3: 10 uF; C1210; TOLERANCE 10%
C4, C6: 0.047 uF; C0402; TOLERANCE 10%
C5: 0.47 uF; C0603; TOLERANCE 10%
C7, C13: 4.7 uF; C0603
C8: 47 uF; C1210; TOLERANCE 20%
C9, C10: 330 uF; CE-035X080; TOLERANCE 20%
C11, C12: 0.01 uF; C0402
JP1: 5.5x2.1mm Barrel; POWER_JACK_SMD
JP2: JP1Q; JP1
Q1: 2N7002; SOT23
R1: 56k; R0402; TOLERANCE 1%
R2: 4.64k; R0402; TOLERANCE 1%
R3: 100; R0402; TOLERANCE 5%
R5: 1k; R0402; TOLERANCE 5%
R6, R7: 10k; R0402; TOLERANCE 5%
R8: 6.3k; R0402; TOLERANCE 1%
R9: 1.21k; R0402; TOLERANCE 1%
U1: LMZ13608; NDY
U2: LT3060ITS8-15; TSOT-8-23

Connections:
15V_LDO_ENABLE: JP2.1, R7.2, U2.1 (!SHDN)
15V_STABLE: C11.2, C13.1, U2.6 (OUT); also elsewhere on the board
FPGA_ENTROPY_DISABLE: R5.1; also elsewhere on the board
GND: C1.2, C2.2, C3.2, C4.2, C5.2, C6.2, C7.2, C8.2, C9.-, C10.-, C12.1, C13.2, JP1.P$4 (GND), Q1.2 (S), R2.1, R6.2, R9.1, U1.3 (AGND), U1.5 (AGND), U1.6 (AGND), U1.TP1 (PGND), U2.2 (GND), U2.3 (GND), U2.4 (GND); also elsewhere on the board
unnamed: C11.1, U2.7 (ADJ)
unnamed: C12.2, U2.8 (REF/BYP)
unnamed: Q1.1 (G), R5.2, R6.1
unnamed: JP2.2, Q1.3 (D)
unnamed: C5.1, U1.8 (SS/TRK)
unnamed: R1.1, R2.2, R3.1
unnamed: R3.2, U1.4 (EN)
unnamed: R8.1, R9.2, U1.7 (FB)
PWR_18V: C1.1, C2.1, C3.1, C4.1, C7.1, JP1.VIN0 (PWR), R1.2, R7.1, U1.1 (VIN), U1.2 (VIN), U2.5 (IN)
VCC_5V0: C6.1, C8.1, C9.+, C10.+, R8.2, U1.10 (VOUT), U1.11 (VOUT); also elsewhere on the board

Notes on the sheet:
15V LDO powered from external 18V and supplying stable 15V to noise source
Main power input 18V DC
To mitigate component ageing in the avalanche noise circuit, this jumper can be used to decide if FPGA/ARM/None should be allowed to turn off the entropy source (default On through pull-up)
Max 3 ohm ESR
*) Intermediate Regulator: 18V -> 5V
*) VCC_5V0 = 0.8V x (1 + 6.3/1.21) = 4.965V *) Current sharing not used *) SYNC is not used
Entropy source power
XXX verify symbol
Input power

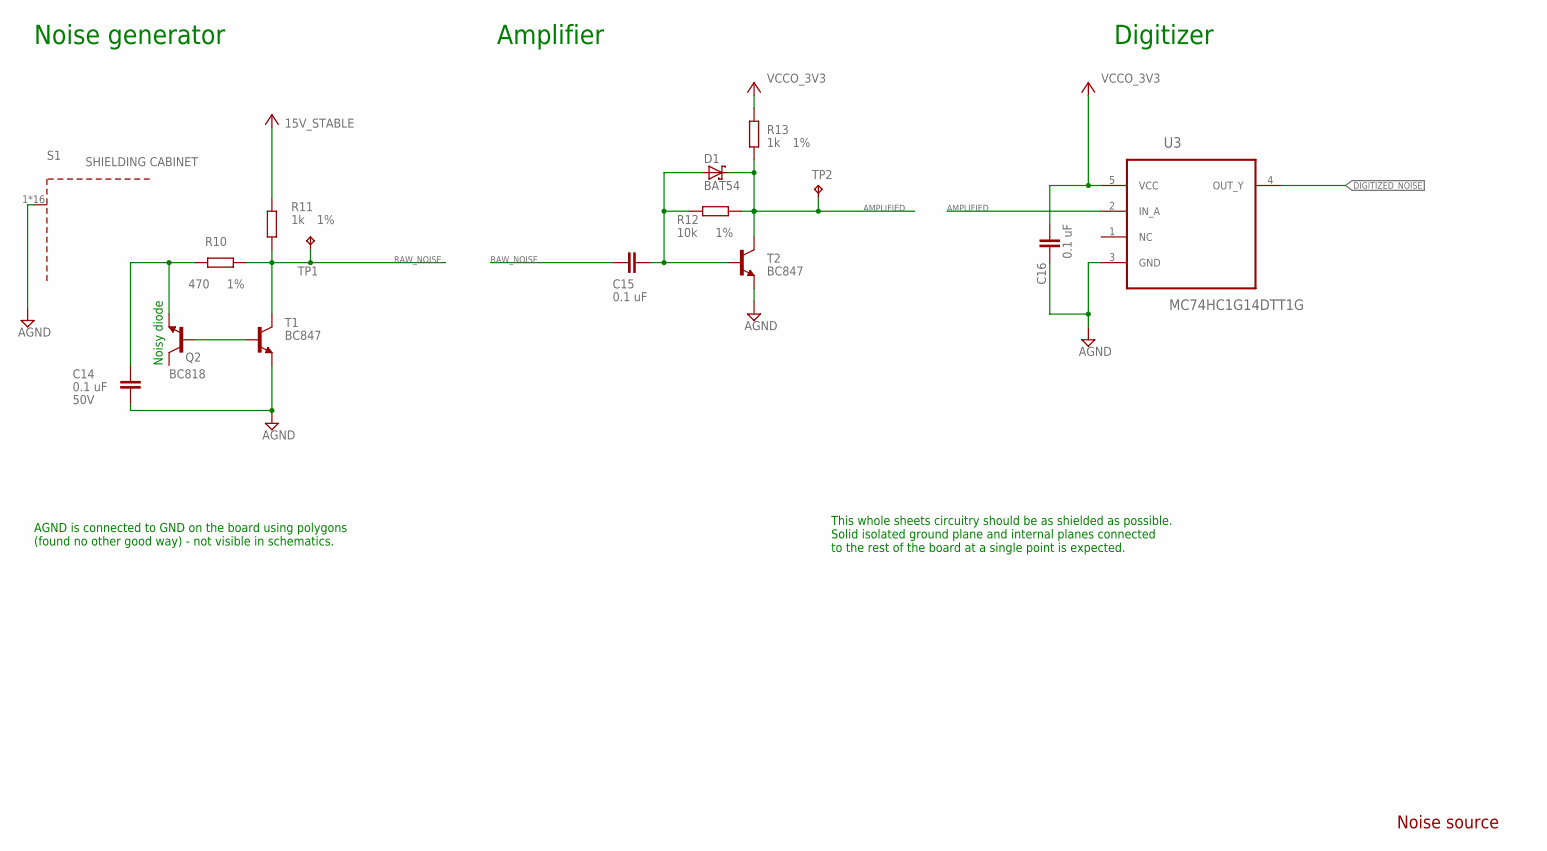
[picture p32: schematic rev02.sch, sheet 3, Noise source]

Parts:
C14, C15, C16: 0.1 uF; C0603; TOLERANCE 10%
D1: BAT54; SOT23
Q2: BC818; SOT23-BEC
R10: 470; R0402; TOLERANCE 1%
R11, R13: 1k; R0402; TOLERANCE 1%
R12: 10k; R0402; TOLERANCE 1%
S1: SHIELDING CABINET; WE-SHC_36103205_NO_CREAM
T1, T2: BC847; SOT23
TP1, TP2: TPB1,27; B1,27
U3: MC74HC1G14DTT1G; SOT95P275X110-5N

Connections:
15V_STABLE: R11.1; also elsewhere on the board
AGND: C16.1, S1.1, S1.2, S1.3, S1.4, S1.5, S1.6, S1.7, S1.8, S1.9, S1.10, S1.11, S1.12, S1.13, S1.14, S1.15, S1.16, T2.2 (E), U3.3 (GND)
AMPLIFIED: D1.3 (C), R12.2, R13.1, T2.3 (C), TP2.TP, U3.2 (IN_A)
AMP_P1: C15.2, D1.1 (A), R12.1, T2.1 (B)
DIGITIZED_NOISE: U3.4 (OUT_Y); also elsewhere on the board
GND: C14.1, T1.2 (E); also elsewhere on the board
NOISE_IN: C14.2, Q2.E, R10.2
NOISE_OUT: Q2.B, T1.1 (B)
RAW_NOISE: C15.1, R10.1, R11.2, T1.3 (C), TP1.TP
VCCO_3V3: C16.2, R13.2, U3.5 (VCC); also elsewhere on the board

Notes on the sheet:
Digitizer
Noise generator
Noisy diode
Amplifier
AGND is connected to GND on the board using polygons (found no other good way) - not visible in schematics.
This whole sheets circuitry should be as shielded as possible. Solid isolated ground plane and internal planes connected to the rest of the board at a single point is expected.
Noise source

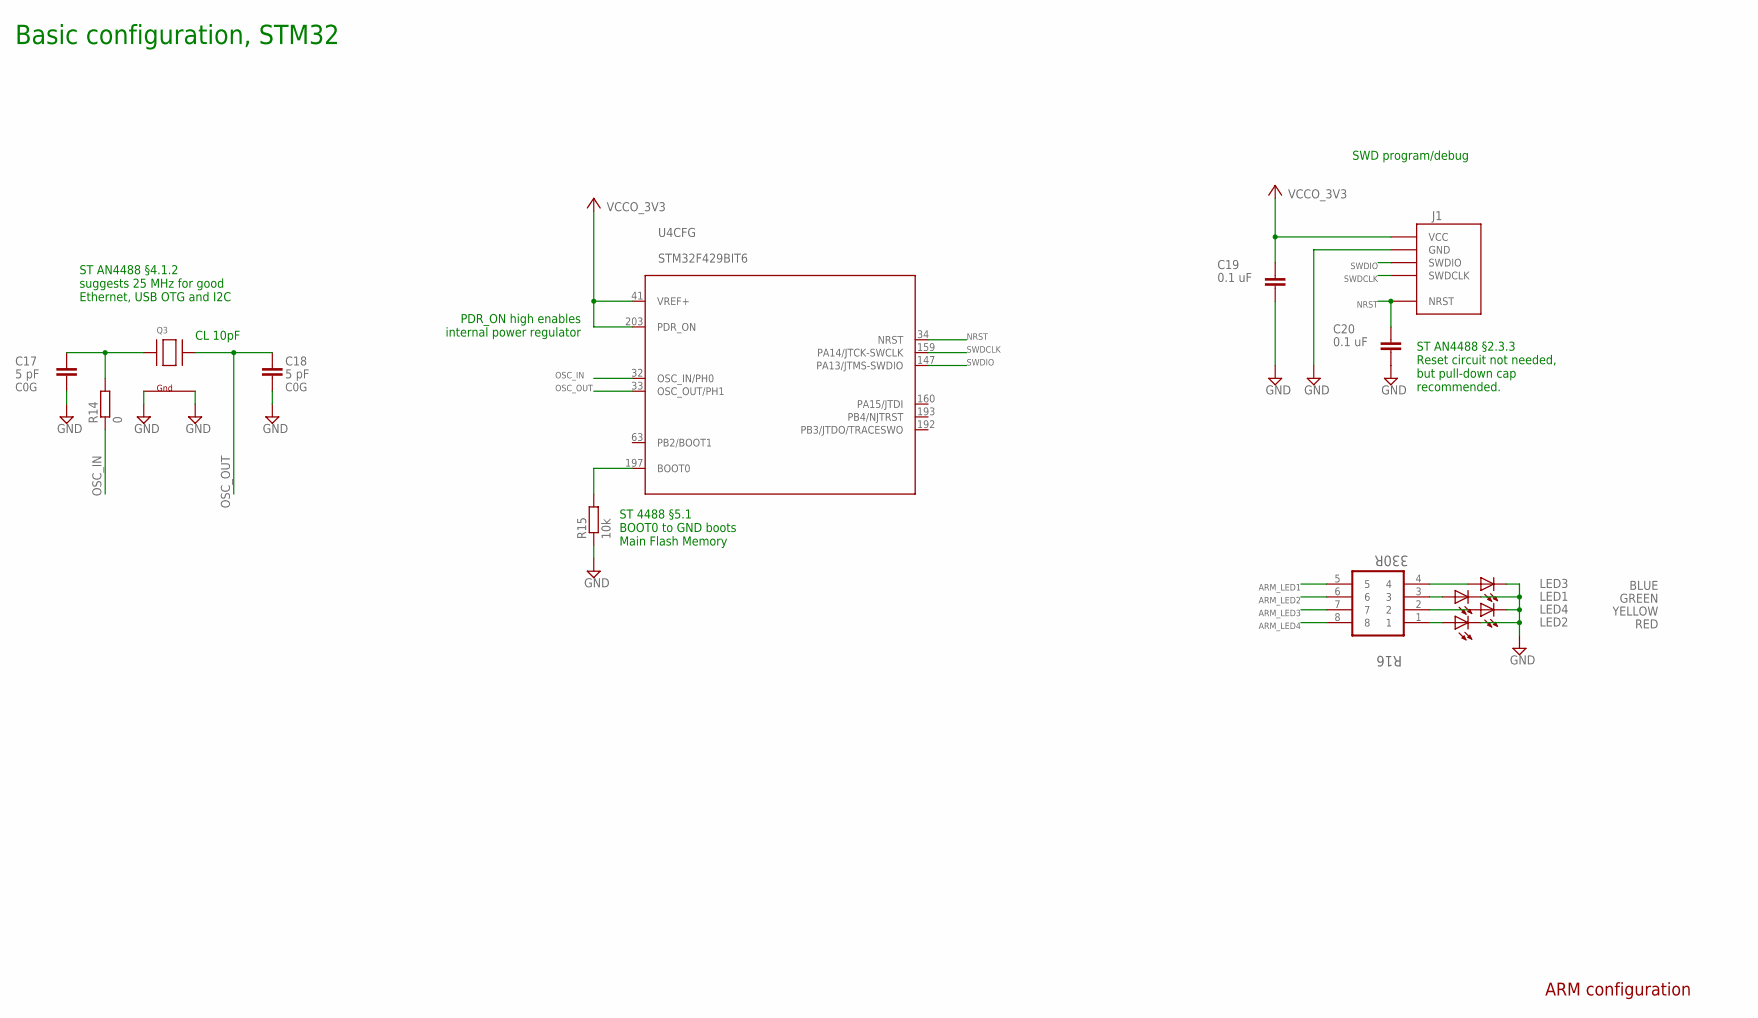
[picture p33: schematic rev02.sch, sheet 4, ARM Configuration]

Parts:
C17, C18: 5 pF; C0402
C19, C20: 0.1 uF; C0402
J1: STM32-SWD; 100MIL_THT
LED1: GREEN; CHIP-LED0603
LED2: RED; CHIP-LED0603
LED3: BLUE; CHIP-LED0603
LED4: YELLOW; CHIP-LED0603
Q3: XTAL-4-3225; NX3225; MPN ABM8G-25.000MHZ-4Y-T3
R14: 0; R0402
R15: 10k; R0402; TOLERANCE 5%
R16: 330R; RESCAXE80P320X160X60-8N
U4: STM32F429BIT6; LQFP-208

Connections:
ARM_LED1: R16.5; also elsewhere on the board
ARM_LED2: R16.6; also elsewhere on the board
ARM_LED3: R16.7; also elsewhere on the board
ARM_LED4: R16.8; also elsewhere on the board
BOOT0: R15.2, U4.197 (BOOT0)
GND: C17.1, C18.1, C19.2, C20.2, J1.P$GND (GND), LED1.C, LED2.C, LED3.C, LED4.C, Q3.2 (G2), Q3.4 (G1), R15.1; also elsewhere on the board
unnamed: LED3.A, R16.4
unnamed: LED1.A, R16.3
unnamed: LED4.A, R16.2
unnamed: LED2.A, R16.1
unnamed: C17.2, Q3.1 (X1), R14.2
NRST: C20.1, J1.P$NRST (NRST), U4.34 (NRST)
OSC_IN: R14.1, U4.32 (OSC_IN/PH0)
OSC_OUT: C18.2, Q3.3 (X2), U4.33 (OSC_OUT/PH1)
SWDCLK: J1.P$SWDCLK (SWDCLK), U4.159 (PA14/JTCK-SWCLK)
SWDIO: J1.P$SWDIO (SWDIO), U4.147 (PA13/JTMS-SWDIO)
VCCO_3V3: C19.1, J1.P$VCC (VCC), U4.41 (VREF+), U4.203 (PDR_ON); also elsewhere on the board

Notes on the sheet:
ST 4488 §5.1 BOOT0 to GND boots Main Flash Memory
ST AN4488 §4.1.2 suggests 25 MHz for good Ethernet, USB OTG and I2C
SWD program/debug
ST AN4488 §2.3.3 Reset circuit not needed, but pull-down cap recommended.
PDR_ON high enables internal power regulator
CL 10pF
Basic configuration, STM32
ARM configuration

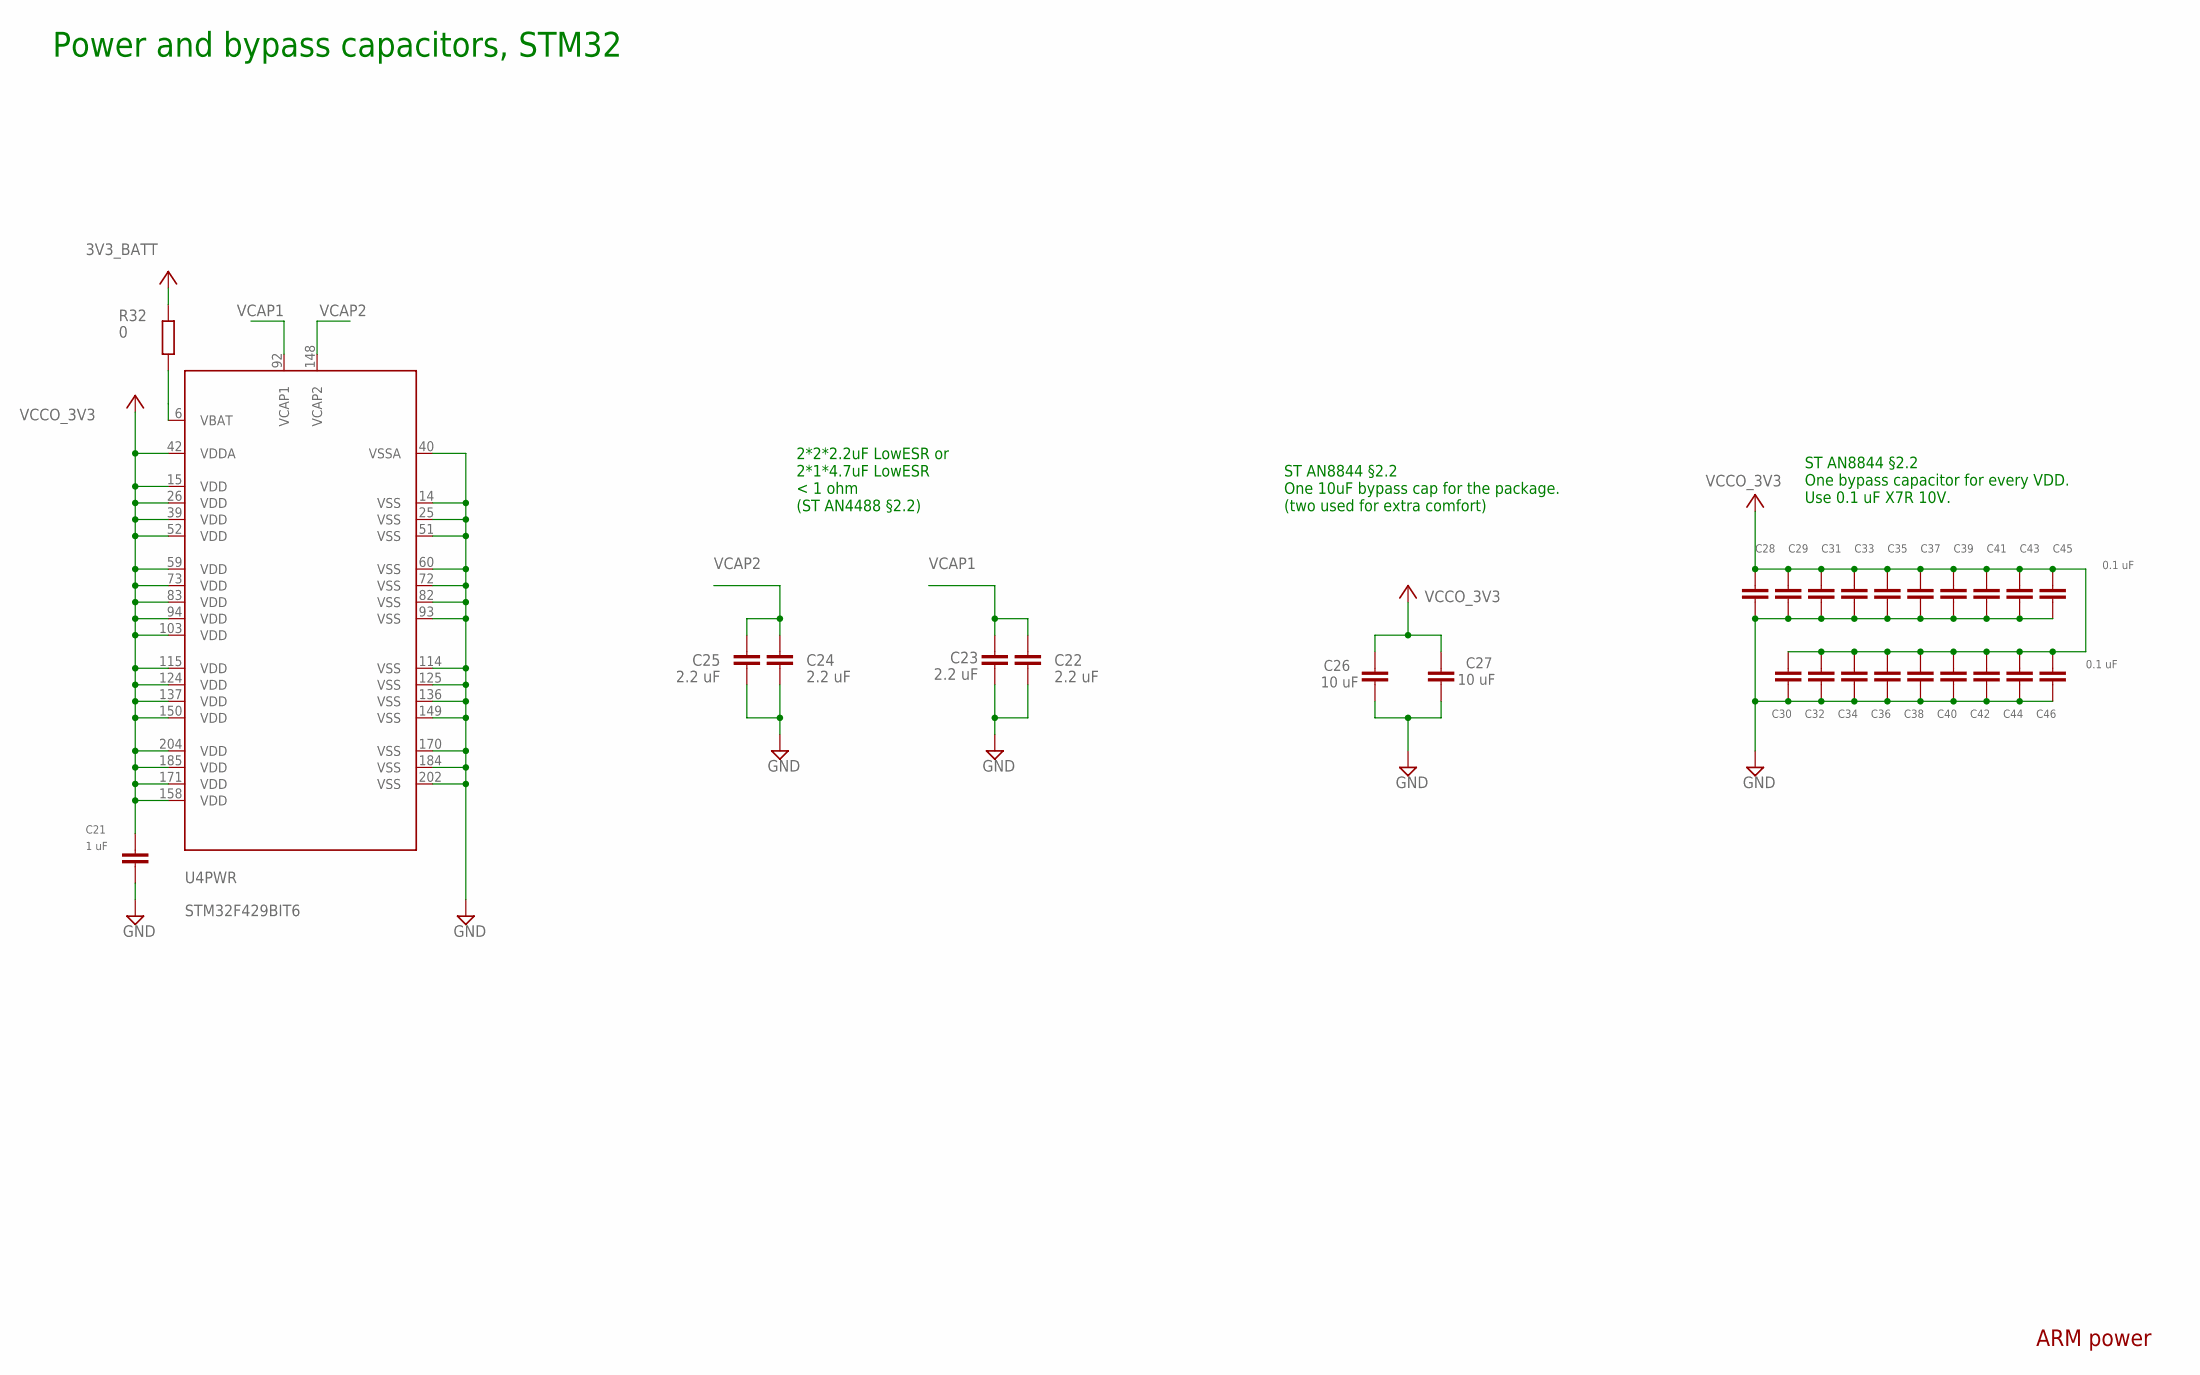
[picture p34: schematic rev02.sch, sheet 5, ARM Power]

Parts:
C21: 1 uF; C0603
C22, C23, C24, C25: 2.2 uF; C0603
C26, C27: 10 uF; C0805
C28, C29, C30, C31, C32, C33, C34, C35, C36, C37, C38, C39, C40, C41, C42, C43, C44, C45, C46: 0.1 uF; C0402
R32: 0; R0402; TOLERANCE 5%
U4: STM32F429BIT6; LQFP-208

Connections:
3V3_BATT: R32.1; also elsewhere on the board
GND: C21.2, C22.1, C23.1, C24.1, C25.1, C26.2, C27.2, C28.2, C29.2, C30.2, C31.2, C32.2, C33.2, C34.2, C35.2, C36.2, C37.2, C38.2, C39.2, C40.2, C41.2, C42.2, C43.2, C44.2, C45.2, C46.2, U4.14 (VSS), U4.25 (VSS), U4.40 (VSSA), U4.51 (VSS), U4.60 (VSS), U4.72 (VSS), U4.82 (VSS), U4.93 (VSS), U4.114 (VSS), U4.125 (VSS), U4.136 (VSS), U4.149 (VSS), U4.170 (VSS), U4.184 (VSS), U4.202 (VSS); also elsewhere on the board
VCAP1: C22.2, C23.2, U4.92 (VCAP1)
VCAP2: C24.2, C25.2, U4.148 (VCAP2)
VCCO_3V3: C21.1, C26.1, C27.1, C28.1, C29.1, C30.1, C31.1, C32.1, C33.1, C34.1, C35.1, C36.1, C37.1, C38.1, C39.1, C40.1, C41.1, C42.1, C43.1, C44.1, C45.1, C46.1, U4.15 (VDD), U4.26 (VDD), U4.39 (VDD), U4.42 (VDDA), U4.52 (VDD), U4.59 (VDD), U4.73 (VDD), U4.83 (VDD), U4.94 (VDD), U4.103 (VDD), U4.115 (VDD), U4.124 (VDD), U4.137 (VDD), U4.150 (VDD), U4.158 (VDD), U4.171 (VDD), U4.185 (VDD), U4.204 (VDD); also elsewhere on the board

Notes on the sheet:
ST AN8844 §2.2 One bypass capacitor for every VDD. Use 0.1 uF X7R 10V.
ST AN8844 §2.2 One 10uF bypass cap for the package. (two used for extra comfort)
2*2*2.2uF LowESR or 2*1*4.7uF LowESR < 1 ohm (ST AN4488 §2.2)
Power and bypass capacitors, STM32
ARM power

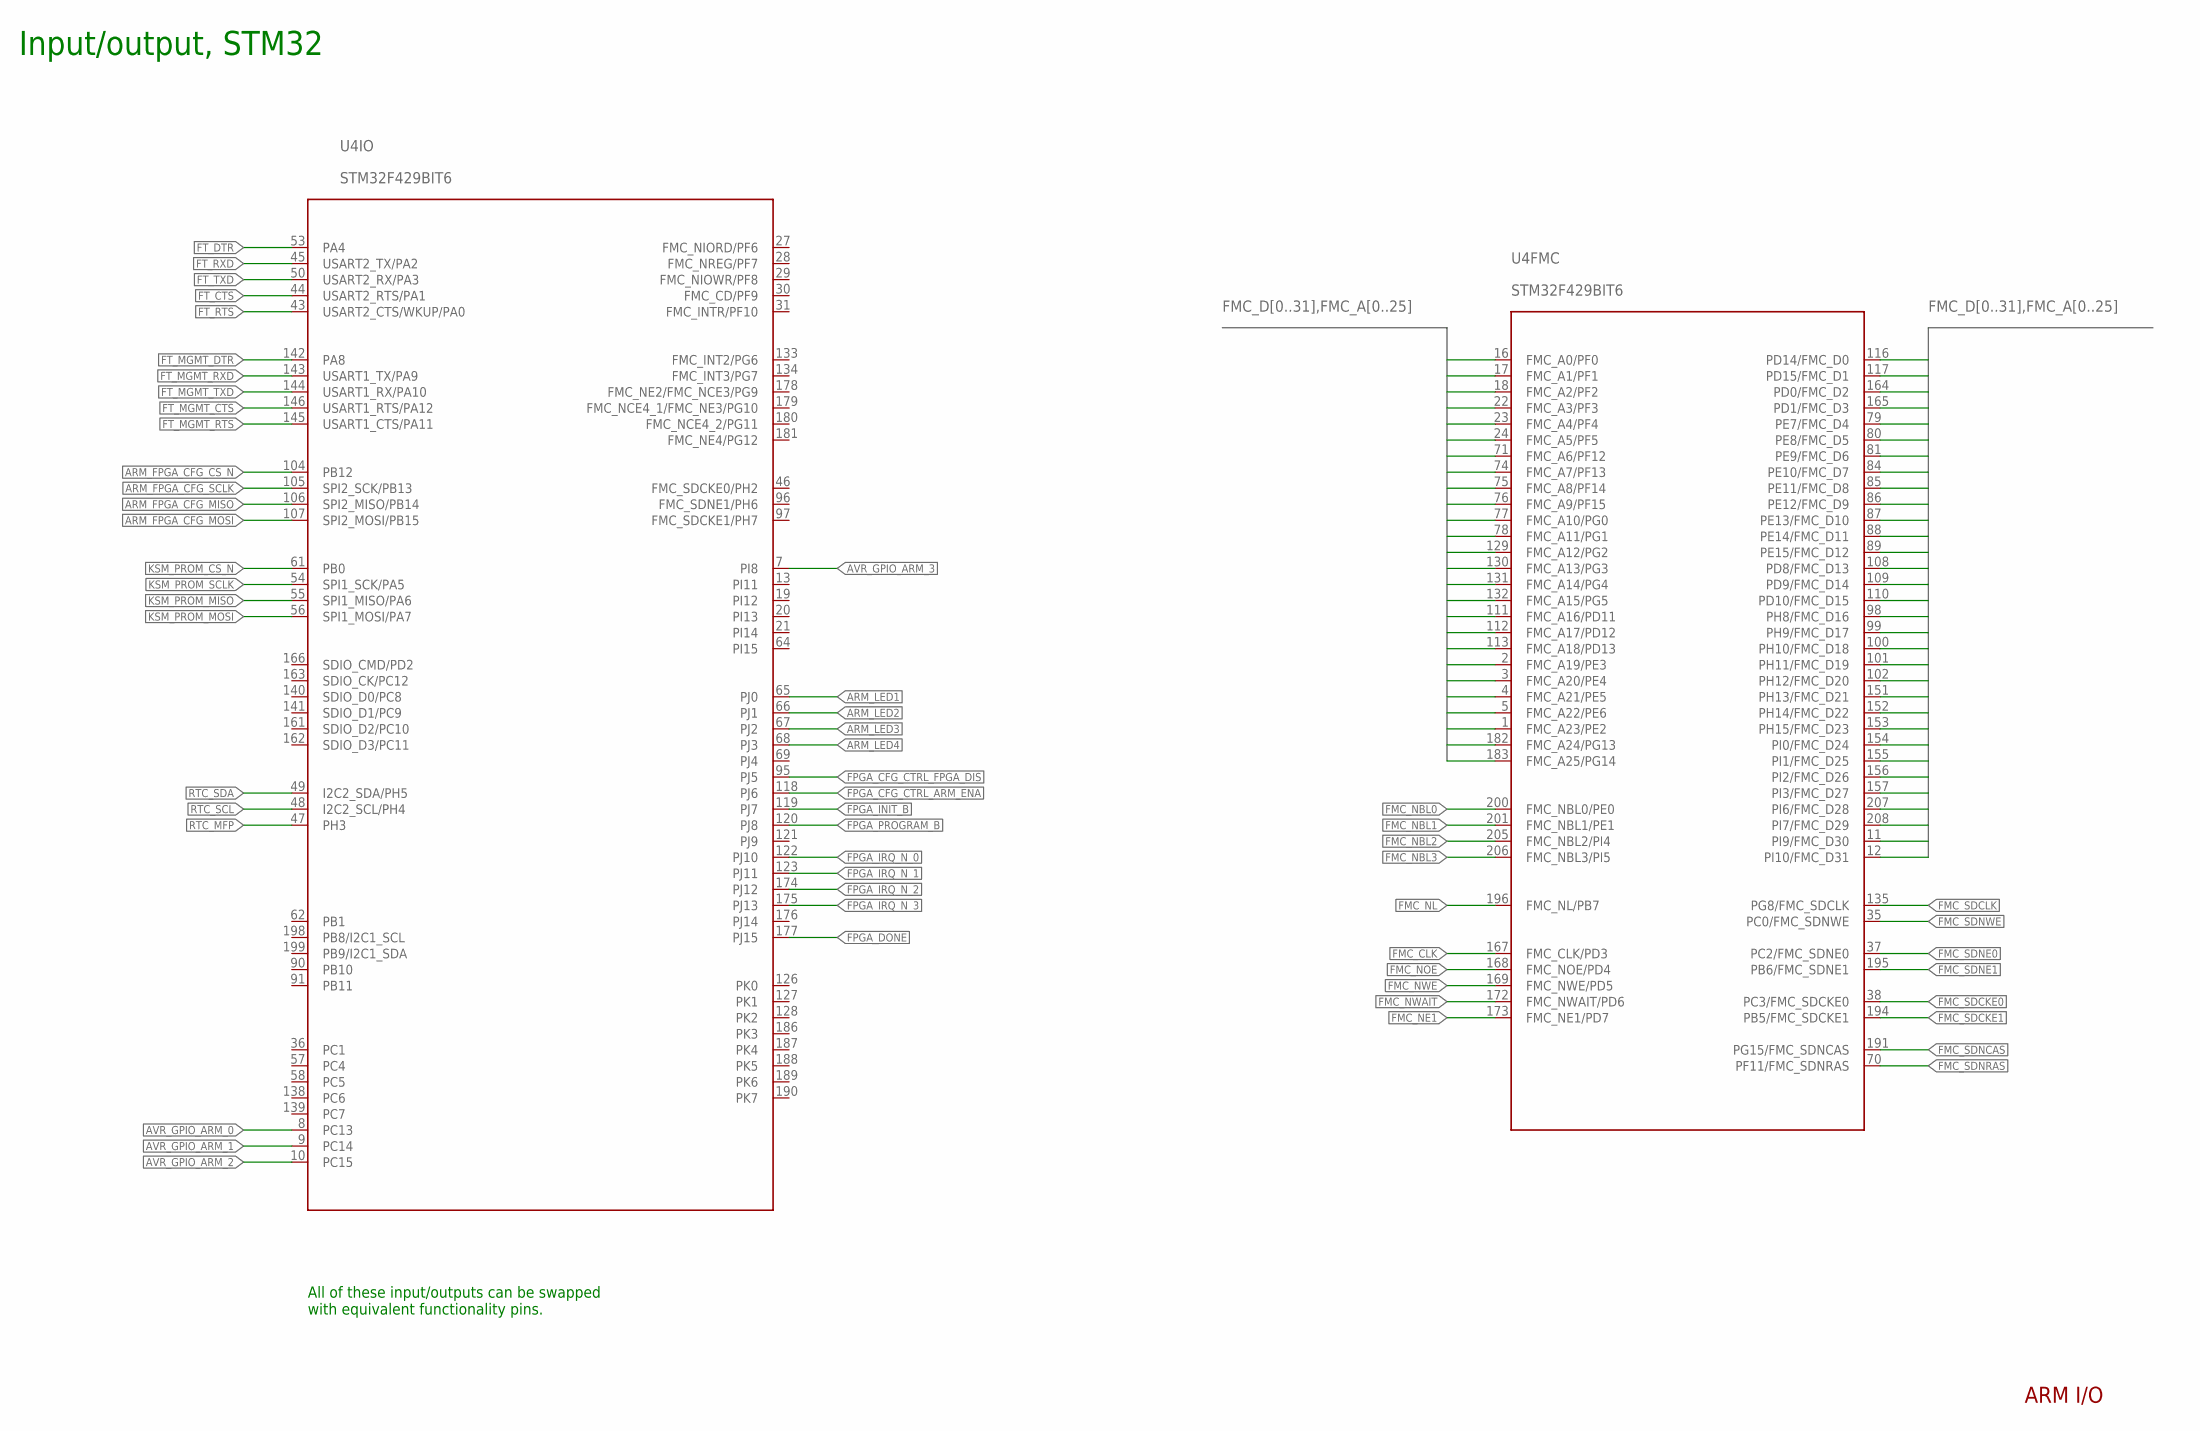
[picture p35: schematic rev02.sch, sheet 6, ARM I/O]

Parts:
U4: STM32F429BIT6; LQFP-208

Connections:
ARM_FPGA_CFG_CS_N: U4.104 (PB12); also elsewhere on the board
ARM_FPGA_CFG_MISO: U4.106 (SPI2_MISO/PB14); also elsewhere on the board
ARM_FPGA_CFG_MOSI: U4.107 (SPI2_MOSI/PB15); also elsewhere on the board
ARM_FPGA_CFG_SCLK: U4.105 (SPI2_SCK/PB13); also elsewhere on the board
ARM_LED1: U4.65 (PJ0); also elsewhere on the board
ARM_LED2: U4.66 (PJ1); also elsewhere on the board
ARM_LED3: U4.67 (PJ2); also elsewhere on the board
ARM_LED4: U4.68 (PJ3); also elsewhere on the board
AVR_GPIO_ARM_0: U4.8 (PC13); also elsewhere on the board
AVR_GPIO_ARM_1: U4.9 (PC14); also elsewhere on the board
FMC_A0: U4.16 (FMC_A0/PF0); also elsewhere on the board
FMC_A1: U4.17 (FMC_A1/PF1); also elsewhere on the board
FMC_A2: U4.18 (FMC_A2/PF2); also elsewhere on the board
FMC_A3: U4.22 (FMC_A3/PF3); also elsewhere on the board
FMC_A4: U4.23 (FMC_A4/PF4); also elsewhere on the board
FMC_A5: U4.24 (FMC_A5/PF5); also elsewhere on the board
FMC_A6: U4.71 (FMC_A6/PF12); also elsewhere on the board
FMC_A7: U4.74 (FMC_A7/PF13); also elsewhere on the board
FMC_A8: U4.75 (FMC_A8/PF14); also elsewhere on the board
FMC_A9: U4.76 (FMC_A9/PF15); also elsewhere on the board
FMC_A10: U4.77 (FMC_A10/PG0); also elsewhere on the board
FMC_A11: U4.78 (FMC_A11/PG1); also elsewhere on the board
FMC_A12: U4.129 (FMC_A12/PG2); also elsewhere on the board
FMC_A13: U4.130 (FMC_A13/PG3); also elsewhere on the board
FMC_A14: U4.131 (FMC_A14/PG4); also elsewhere on the board
FMC_A15: U4.132 (FMC_A15/PG5); also elsewhere on the board
FMC_A16: U4.111 (FMC_A16/PD11); also elsewhere on the board
FMC_A17: U4.112 (FMC_A17/PD12); also elsewhere on the board
FMC_A18: U4.113 (FMC_A18/PD13); also elsewhere on the board
FMC_A19: U4.2 (FMC_A19/PE3); also elsewhere on the board
FMC_A20: U4.3 (FMC_A20/PE4); also elsewhere on the board
FMC_A21: U4.4 (FMC_A21/PE5); also elsewhere on the board
FMC_A22: U4.5 (FMC_A22/PE6); also elsewhere on the board
FMC_A23: U4.1 (FMC_A23/PE2); also elsewhere on the board
FMC_A24: U4.182 (FMC_A24/PG13); also elsewhere on the board
FMC_A25: U4.183 (FMC_A25/PG14); also elsewhere on the board
FMC_CLK: U4.167 (FMC_CLK/PD3); also elsewhere on the board
FMC_D0: U4.116 (PD14/FMC_D0); also elsewhere on the board
FMC_D1: U4.117 (PD15/FMC_D1); also elsewhere on the board
FMC_D2: U4.164 (PD0/FMC_D2); also elsewhere on the board
FMC_D3: U4.165 (PD1/FMC_D3); also elsewhere on the board
FMC_D4: U4.79 (PE7/FMC_D4); also elsewhere on the board
FMC_D5: U4.80 (PE8/FMC_D5); also elsewhere on the board
FMC_D6: U4.81 (PE9/FMC_D6); also elsewhere on the board
FMC_D7: U4.84 (PE10/FMC_D7); also elsewhere on the board
FMC_D8: U4.85 (PE11/FMC_D8); also elsewhere on the board
FMC_D9: U4.86 (PE12/FMC_D9); also elsewhere on the board
FMC_D10: U4.87 (PE13/FMC_D10); also elsewhere on the board
FMC_D11: U4.88 (PE14/FMC_D11); also elsewhere on the board
FMC_D12: U4.89 (PE15/FMC_D12); also elsewhere on the board
FMC_D13: U4.108 (PD8/FMC_D13); also elsewhere on the board
FMC_D14: U4.109 (PD9/FMC_D14); also elsewhere on the board
FMC_D15: U4.110 (PD10/FMC_D15); also elsewhere on the board
FMC_D16: U4.98 (PH8/FMC_D16); also elsewhere on the board
FMC_D17: U4.99 (PH9/FMC_D17); also elsewhere on the board
FMC_D18: U4.100 (PH10/FMC_D18); also elsewhere on the board
FMC_D19: U4.101 (PH11/FMC_D19); also elsewhere on the board
FMC_D20: U4.102 (PH12/FMC_D20); also elsewhere on the board
FMC_D21: U4.151 (PH13/FMC_D21); also elsewhere on the board
FMC_D22: U4.152 (PH14/FMC_D22); also elsewhere on the board
FMC_D23: U4.153 (PH15/FMC_D23); also elsewhere on the board
FMC_D24: U4.154 (PI0/FMC_D24); also elsewhere on the board
FMC_D25: U4.155 (PI1/FMC_D25); also elsewhere on the board
FMC_D26: U4.156 (PI2/FMC_D26); also elsewhere on the board
FMC_D27: U4.157 (PI3/FMC_D27); also elsewhere on the board
FMC_D28: U4.207 (PI6/FMC_D28); also elsewhere on the board
FMC_D29: U4.208 (PI7/FMC_D29); also elsewhere on the board
FMC_D30: U4.11 (PI9/FMC_D30); also elsewhere on the board
FMC_D31: U4.12 (PI10/FMC_D31); also elsewhere on the board
FMC_NBL0: U4.200 (FMC_NBL0/PE0); also elsewhere on the board
FMC_NBL1: U4.201 (FMC_NBL1/PE1); also elsewhere on the board
FMC_NBL2: U4.205 (FMC_NBL2/PI4); also elsewhere on the board
FMC_NBL3: U4.206 (FMC_NBL3/PI5); also elsewhere on the board
FMC_NE1: U4.173 (FMC_NE1/PD7); also elsewhere on the board
FMC_NL: U4.196 (FMC_NL/PB7); also elsewhere on the board
FMC_NOE: U4.168 (FMC_NOE/PD4); also elsewhere on the board
FMC_NWAIT: U4.172 (FMC_NWAIT/PD6); also elsewhere on the board
FMC_NWE: U4.169 (FMC_NWE/PD5); also elsewhere on the board
FMC_SDCKE0: U4.38 (PC3/FMC_SDCKE0); also elsewhere on the board
FMC_SDCKE1: U4.194 (PB5/FMC_SDCKE1); also elsewhere on the board
FMC_SDCLK: U4.135 (PG8/FMC_SDCLK); also elsewhere on the board
FMC_SDNCAS: U4.191 (PG15/FMC_SDNCAS); also elsewhere on the board
FMC_SDNE0: U4.37 (PC2/FMC_SDNE0); also elsewhere on the board
FMC_SDNE1: U4.195 (PB6/FMC_SDNE1); also elsewhere on the board
FMC_SDNRAS: U4.70 (PF11/FMC_SDNRAS); also elsewhere on the board
FMC_SDNWE: U4.35 (PC0/FMC_SDNWE); also elsewhere on the board
FPGA_CFG_CTRL_ARM_ENA: U4.118 (PJ6); also elsewhere on the board
FPGA_CFG_CTRL_FPGA_DIS: U4.95 (PJ5); also elsewhere on the board
FPGA_DONE: U4.177 (PJ15); also elsewhere on the board
FPGA_INIT_B: U4.119 (PJ7); also elsewhere on the board
FPGA_IRQ_N_0: U4.122 (PJ10); also elsewhere on the board
FPGA_IRQ_N_1: U4.123 (PJ11); also elsewhere on the board
FPGA_IRQ_N_2: U4.174 (PJ12); also elsewhere on the board
FPGA_IRQ_N_3: U4.175 (PJ13); also elsewhere on the board
FPGA_PROGRAM_B: U4.120 (PJ8); also elsewhere on the board
FT_CTS: U4.44 (USART2_RTS/PA1); also elsewhere on the board
FT_DTR: U4.53 (PA4); also elsewhere on the board
FT_MGMT_CTS: U4.146 (USART1_RTS/PA12); also elsewhere on the board
FT_MGMT_DTR: U4.142 (PA8); also elsewhere on the board
FT_MGMT_RTS: U4.145 (USART1_CTS/PA11); also elsewhere on the board
FT_MGMT_RXD: U4.143 (USART1_TX/PA9); also elsewhere on the board
FT_MGMT_TXD: U4.144 (USART1_RX/PA10); also elsewhere on the board
FT_RTS: U4.43 (USART2_CTS/WKUP/PA0); also elsewhere on the board
FT_RXD: U4.45 (USART2_TX/PA2); also elsewhere on the board
FT_TXD: U4.50 (USART2_RX/PA3); also elsewhere on the board
KSM_PROM_CS_N: U4.61 (PB0); also elsewhere on the board
KSM_PROM_MISO: U4.55 (SPI1_MISO/PA6); also elsewhere on the board
KSM_PROM_MOSI: U4.56 (SPI1_MOSI/PA7); also elsewhere on the board
KSM_PROM_SCLK: U4.54 (SPI1_SCK/PA5); also elsewhere on the board
RTC_MFP: U4.47 (PH3); also elsewhere on the board
RTC_SCL: U4.48 (I2C2_SCL/PH4); also elsewhere on the board
RTC_SDA: U4.49 (I2C2_SDA/PH5); also elsewhere on the board

Notes on the sheet:
All of these input/outputs can be swapped with equivalent functionality pins.
Input/output, STM32
ARM I/O
