vgisc/cryptech.hardware/cad/rev02/alpha/rev02/rev02.brd

## EAGLE design cad/rev02/alpha/rev02/rev02.brd (continued)

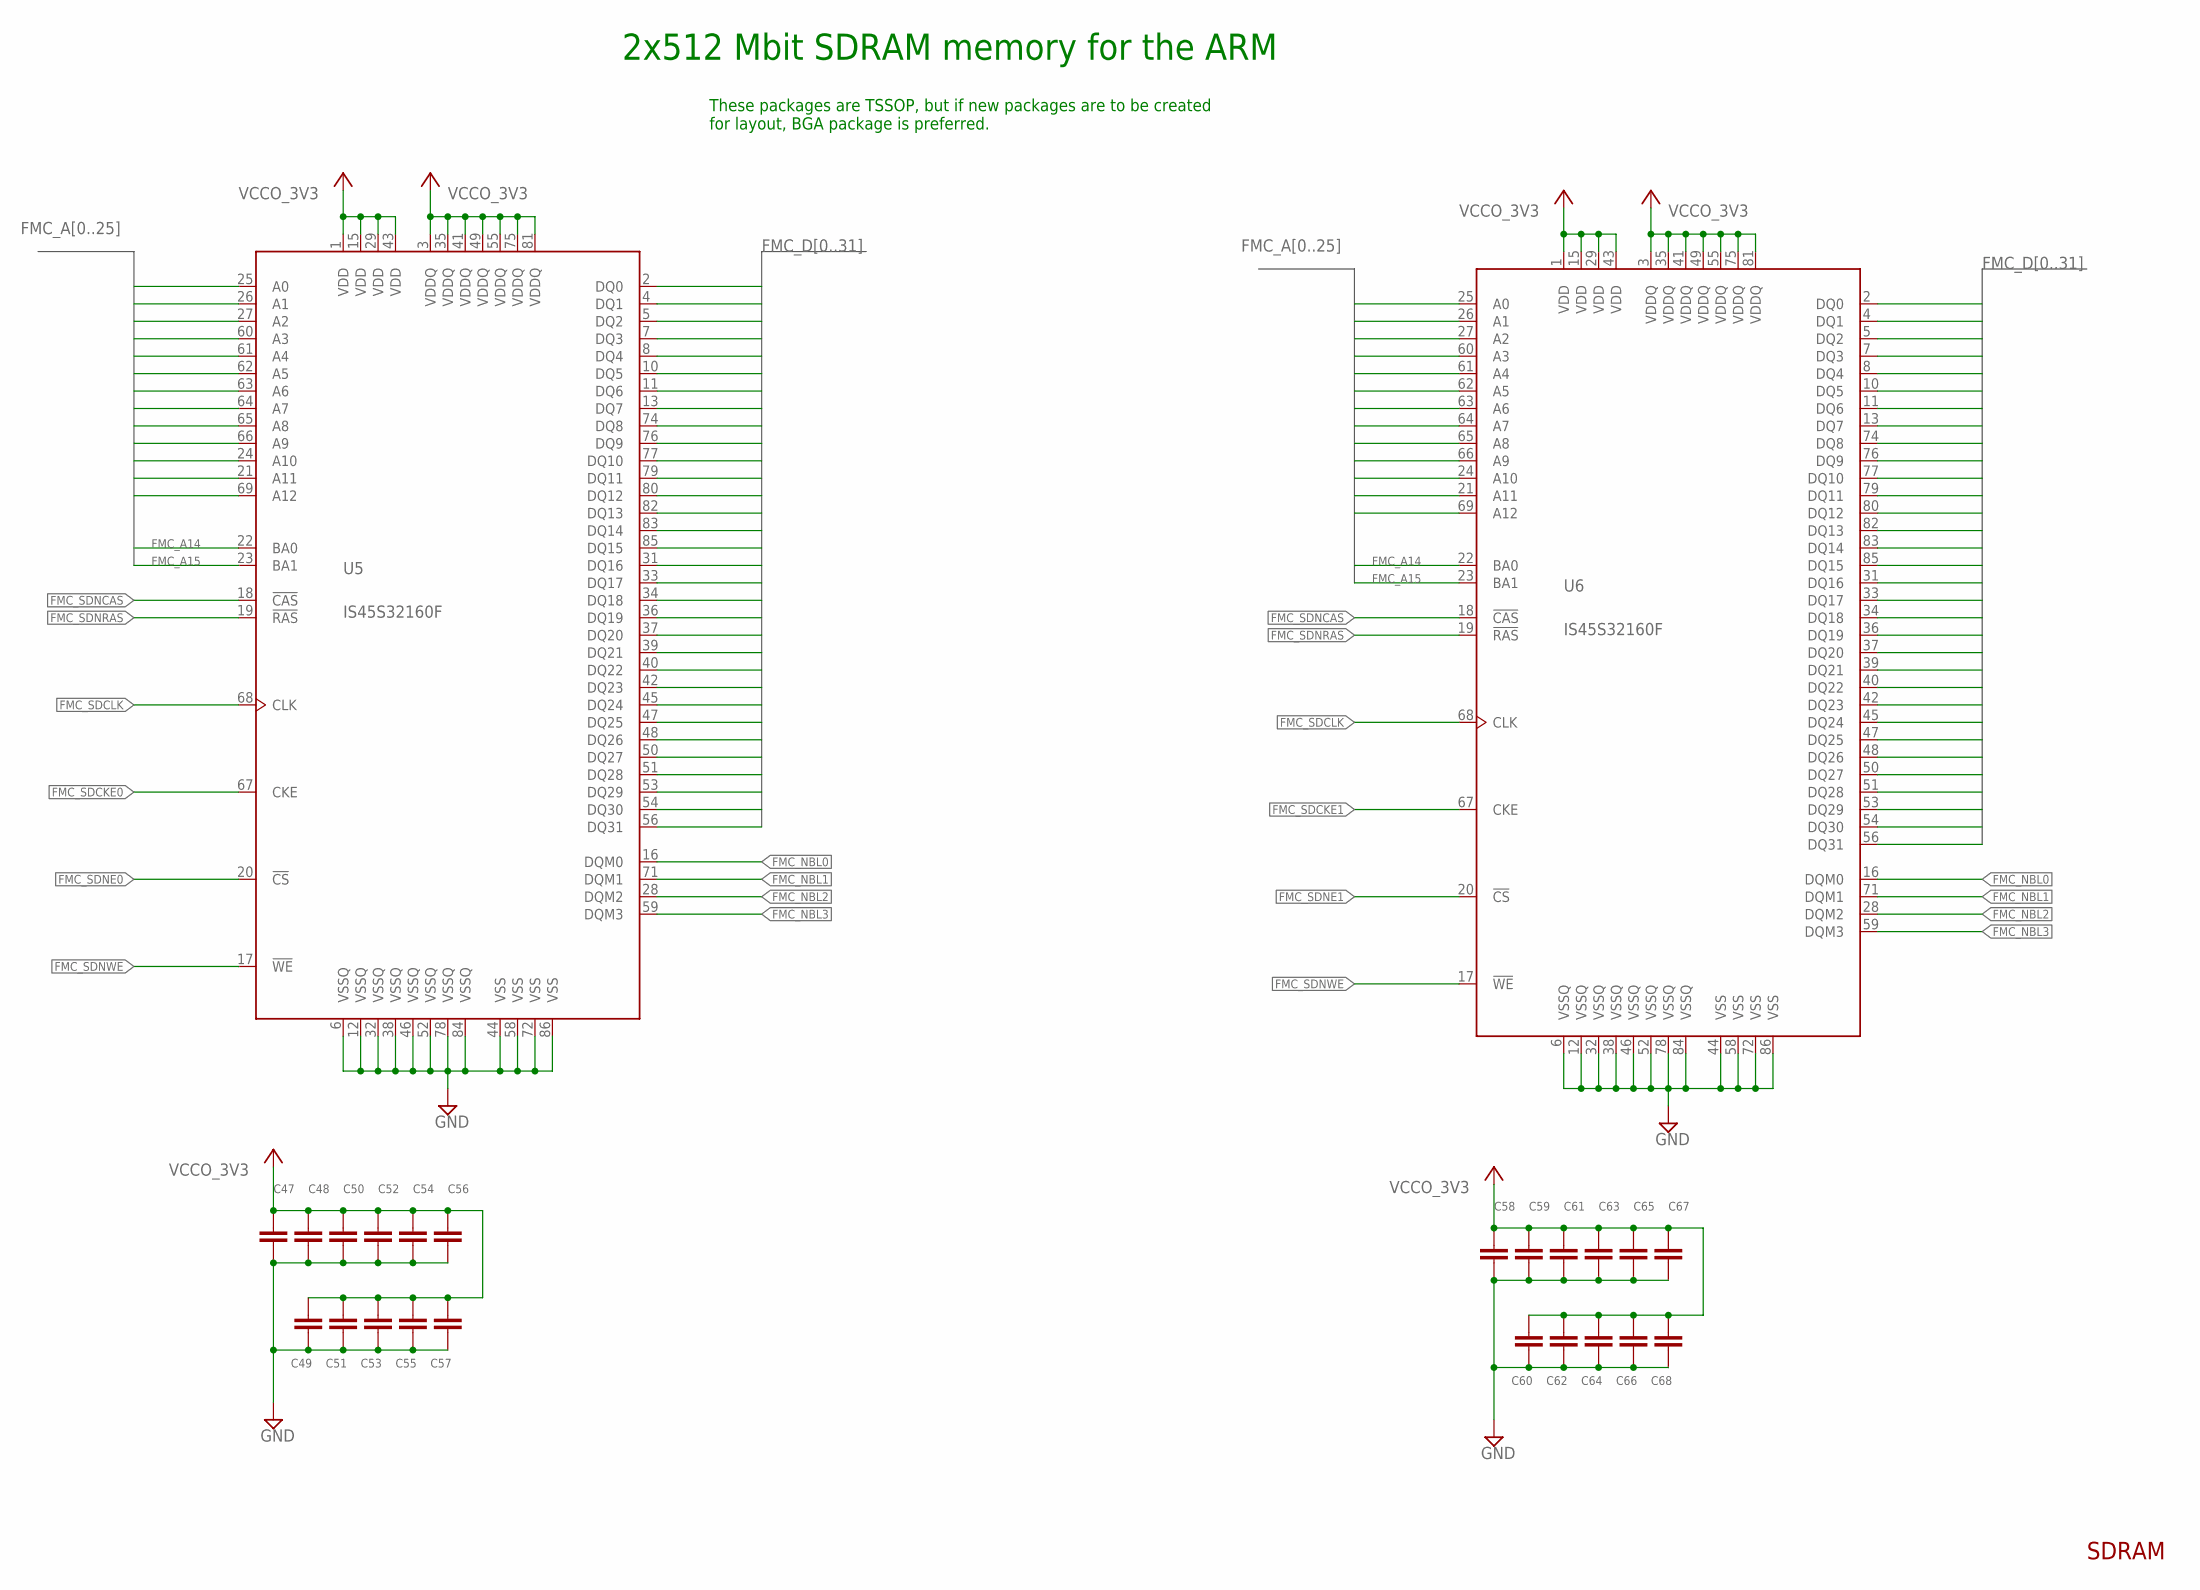
[picture p36: schematic rev02.sch, sheet 7, SDRAM]

Parts:
C47, C48, C49, C50, C51, C52, C53, C54, C55, C56, C57, C58, C59, C60, C61, C62, C63, C64, C65, C66, C67, C68: 0.1 uF; C0402
U5, U6: IS45S32160F; TSOP2-86L

Connections:
FMC_A0: U5.25 (A0), U6.25 (A0); also elsewhere on the board
FMC_A1: U5.26 (A1), U6.26 (A1); also elsewhere on the board
FMC_A2: U5.27 (A2), U6.27 (A2); also elsewhere on the board
FMC_A3: U5.60 (A3), U6.60 (A3); also elsewhere on the board
FMC_A4: U5.61 (A4), U6.61 (A4); also elsewhere on the board
FMC_A5: U5.62 (A5), U6.62 (A5); also elsewhere on the board
FMC_A6: U5.63 (A6), U6.63 (A6); also elsewhere on the board
FMC_A7: U5.64 (A7), U6.64 (A7); also elsewhere on the board
FMC_A8: U5.65 (A8), U6.65 (A8); also elsewhere on the board
FMC_A9: U5.66 (A9), U6.66 (A9); also elsewhere on the board
FMC_A10: U5.24 (A10), U6.24 (A10); also elsewhere on the board
FMC_A11: U5.21 (A11), U6.21 (A11); also elsewhere on the board
FMC_A12: U5.69 (A12), U6.69 (A12); also elsewhere on the board
FMC_A14: U5.22 (BA0), U6.22 (BA0); also elsewhere on the board
FMC_A15: U5.23 (BA1), U6.23 (BA1); also elsewhere on the board
FMC_D0: U5.2 (DQ0), U6.2 (DQ0); also elsewhere on the board
FMC_D1: U5.4 (DQ1), U6.4 (DQ1); also elsewhere on the board
FMC_D2: U5.5 (DQ2), U6.5 (DQ2); also elsewhere on the board
FMC_D3: U5.7 (DQ3), U6.7 (DQ3); also elsewhere on the board
FMC_D4: U5.8 (DQ4), U6.8 (DQ4); also elsewhere on the board
FMC_D5: U5.10 (DQ5), U6.10 (DQ5); also elsewhere on the board
FMC_D6: U5.11 (DQ6), U6.11 (DQ6); also elsewhere on the board
FMC_D7: U5.13 (DQ7), U6.13 (DQ7); also elsewhere on the board
FMC_D8: U5.74 (DQ8), U6.74 (DQ8); also elsewhere on the board
FMC_D10: U5.76 (DQ9), U5.77 (DQ10), U6.76 (DQ9), U6.77 (DQ10); also elsewhere on the board
FMC_D11: U5.79 (DQ11), U6.79 (DQ11); also elsewhere on the board
FMC_D12: U5.80 (DQ12), U6.80 (DQ12); also elsewhere on the board
FMC_D13: U5.82 (DQ13), U6.82 (DQ13); also elsewhere on the board
FMC_D14: U5.83 (DQ14), U6.83 (DQ14); also elsewhere on the board
FMC_D15: U5.85 (DQ15), U6.85 (DQ15); also elsewhere on the board
FMC_D16: U5.31 (DQ16), U6.31 (DQ16); also elsewhere on the board
FMC_D17: U5.33 (DQ17), U6.33 (DQ17); also elsewhere on the board
FMC_D18: U5.34 (DQ18), U6.34 (DQ18); also elsewhere on the board
FMC_D19: U5.36 (DQ19), U6.36 (DQ19); also elsewhere on the board
FMC_D20: U5.37 (DQ20), U6.37 (DQ20); also elsewhere on the board
FMC_D21: U5.39 (DQ21), U6.39 (DQ21); also elsewhere on the board
FMC_D22: U5.40 (DQ22), U6.40 (DQ22); also elsewhere on the board
FMC_D23: U5.42 (DQ23), U6.42 (DQ23); also elsewhere on the board
FMC_D24: U5.45 (DQ24), U6.45 (DQ24); also elsewhere on the board
FMC_D25: U5.47 (DQ25), U6.47 (DQ25); also elsewhere on the board
FMC_D26: U5.48 (DQ26), U6.48 (DQ26); also elsewhere on the board
FMC_D27: U5.50 (DQ27), U6.50 (DQ27); also elsewhere on the board
FMC_D28: U5.51 (DQ28), U6.51 (DQ28); also elsewhere on the board
FMC_D29: U5.53 (DQ29), U6.53 (DQ29); also elsewhere on the board
FMC_D30: U5.54 (DQ30), U6.54 (DQ30); also elsewhere on the board
FMC_D31: U5.56 (DQ31), U6.56 (DQ31); also elsewhere on the board
FMC_NBL0: U5.16 (DQM0), U6.16 (DQM0); also elsewhere on the board
FMC_NBL1: U5.71 (DQM1), U6.71 (DQM1); also elsewhere on the board
FMC_NBL2: U5.28 (DQM2), U6.28 (DQM2); also elsewhere on the board
FMC_NBL3: U5.59 (DQM3), U6.59 (DQM3); also elsewhere on the board
FMC_SDCKE0: U5.67 (CKE); also elsewhere on the board
FMC_SDCKE1: U6.67 (CKE); also elsewhere on the board
FMC_SDCLK: U5.68 (CLK), U6.68 (CLK); also elsewhere on the board
FMC_SDNCAS: U5.18 (!CAS), U6.18 (!CAS); also elsewhere on the board
FMC_SDNE0: U5.20 (!CS); also elsewhere on the board
FMC_SDNE1: U6.20 (!CS); also elsewhere on the board
FMC_SDNRAS: U5.19 (!RAS), U6.19 (!RAS); also elsewhere on the board
FMC_SDNWE: U5.17 (!WE), U6.17 (!WE); also elsewhere on the board
GND: C47.2, C48.2, C49.2, C50.2, C51.2, C52.2, C53.2, C54.2, C55.2, C56.2, C57.2, C58.2, C59.2, C60.2, C61.2, C62.2, C63.2, C64.2, C65.2, C66.2, C67.2, C68.2, U5.6 (VSSQ), U5.12 (VSSQ), U5.32 (VSSQ), U5.38 (VSSQ), U5.44 (VSS), U5.46 (VSSQ), U5.52 (VSSQ), U5.58 (VSS), U5.72 (VSS), U5.78 (VSSQ), U5.84 (VSSQ), U5.86 (VSS), U6.6 (VSSQ), U6.12 (VSSQ), U6.32 (VSSQ), U6.38 (VSSQ), U6.44 (VSS), U6.46 (VSSQ), U6.52 (VSSQ), U6.58 (VSS), U6.72 (VSS), U6.78 (VSSQ), U6.84 (VSSQ), U6.86 (VSS); also elsewhere on the board
VCCO_3V3: C47.1, C48.1, C49.1, C50.1, C51.1, C52.1, C53.1, C54.1, C55.1, C56.1, C57.1, C58.1, C59.1, C60.1, C61.1, C62.1, C63.1, C64.1, C65.1, C66.1, C67.1, C68.1, U5.1 (VDD), U5.3 (VDDQ), U5.15 (VDD), U5.29 (VDD), U5.35 (VDDQ), U5.41 (VDDQ), U5.43 (VDD), U5.49 (VDDQ), U5.55 (VDDQ), U5.75 (VDDQ), U5.81 (VDDQ), U6.1 (VDD), U6.3 (VDDQ), U6.15 (VDD), U6.29 (VDD), U6.35 (VDDQ), U6.41 (VDDQ), U6.43 (VDD), U6.49 (VDDQ), U6.55 (VDDQ), U6.75 (VDDQ), U6.81 (VDDQ); also elsewhere on the board

Notes on the sheet:
2x512 Mbit SDRAM memory for the ARM
SDRAM
These packages are TSSOP, but if new packages are to be created for layout, BGA package is preferred.

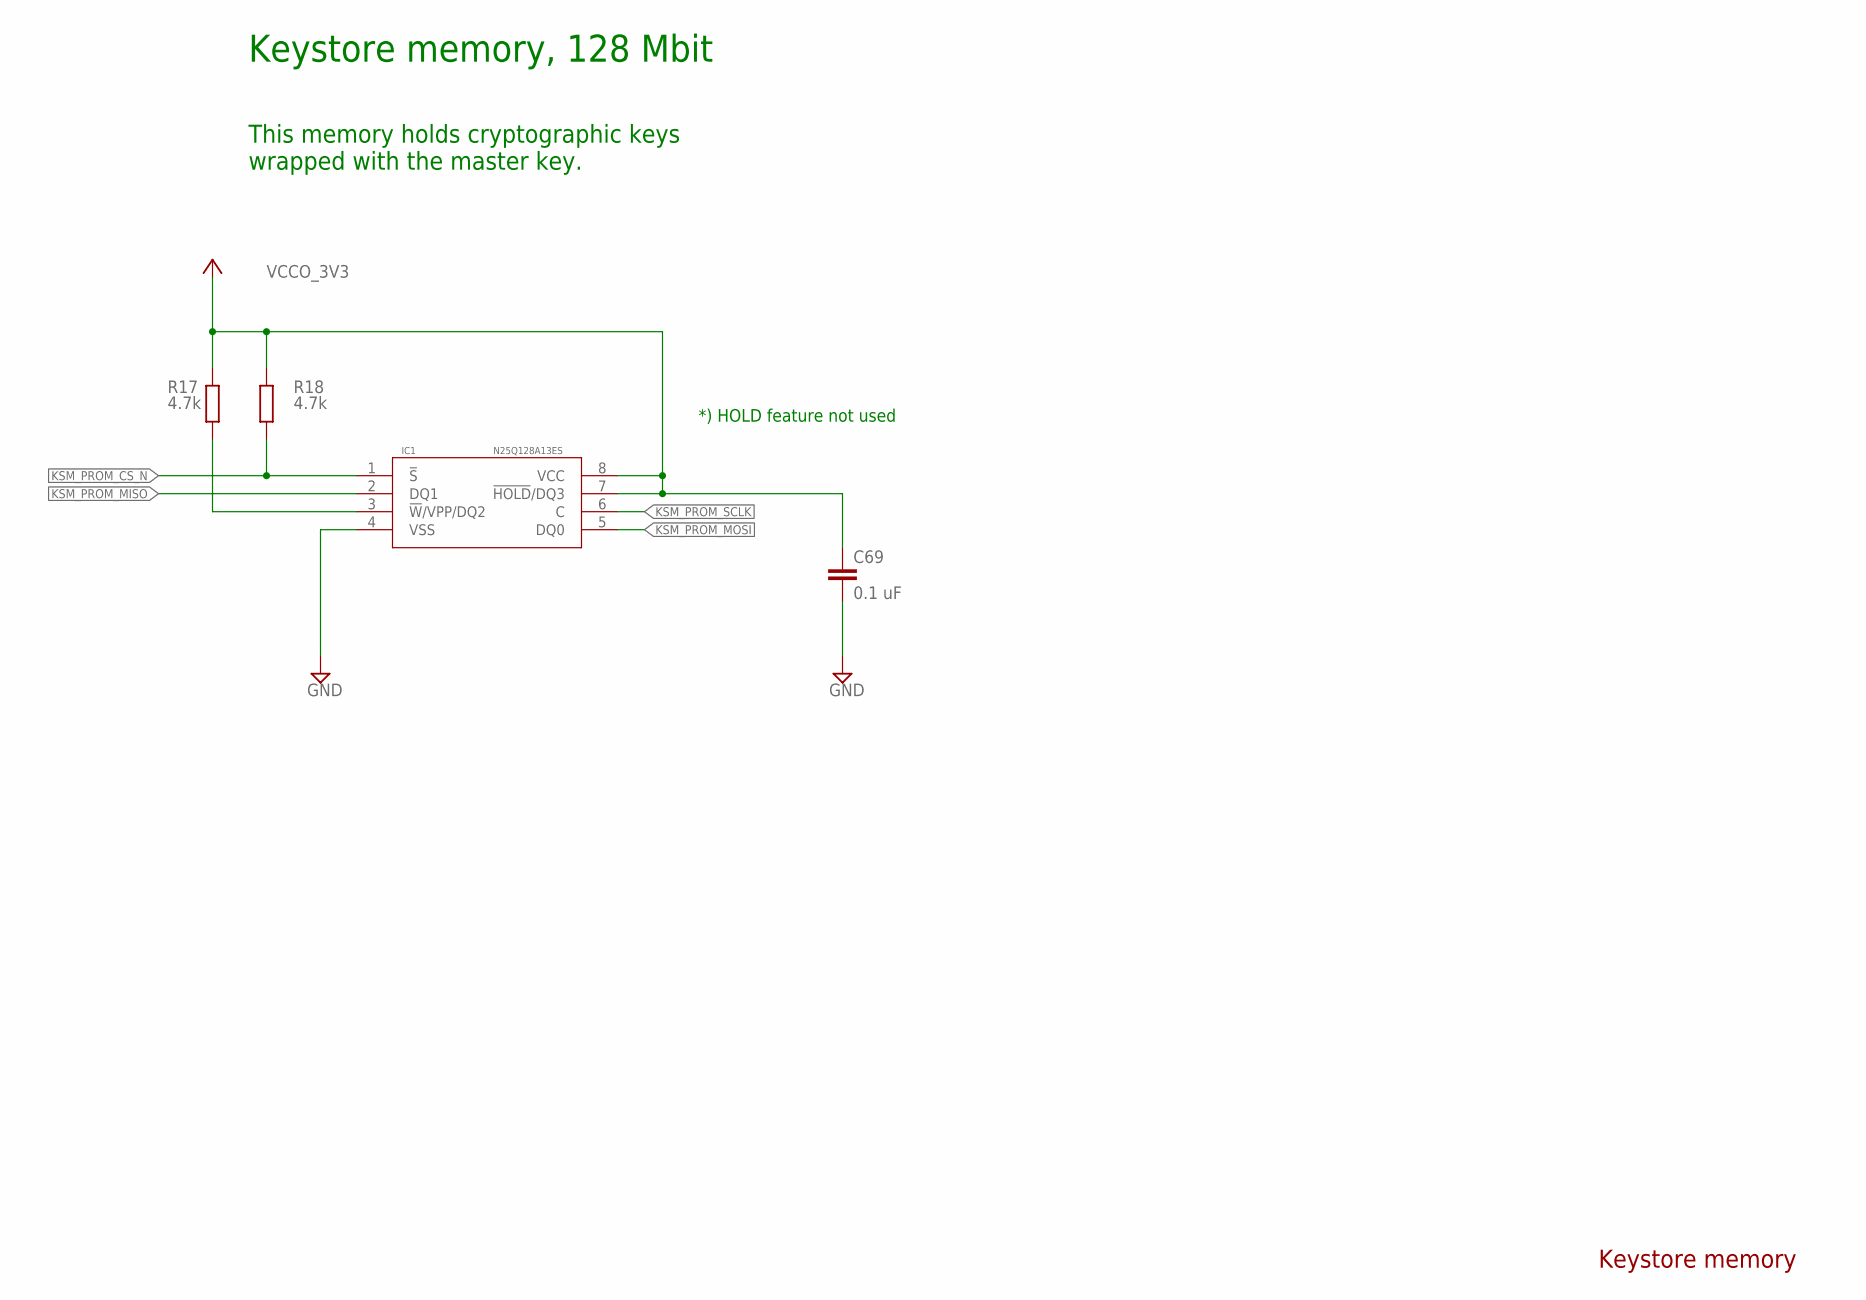
[picture p37: schematic rev02.sch, sheet 8, Keystore memory]

Parts:
C69: 0.1 uF; C0402; TOLERANCE 10%
IC1: N25Q128A13ES; SO08
R17, R18: 4.7k; R0402; TOLERANCE 5%

Connections:
GND: C69.2, IC1.4 (VSS); also elsewhere on the board
KSM_PROM_CS_N: IC1.1 (!S), R18.2; also elsewhere on the board
KSM_PROM_MISO: IC1.2 (DQ1); also elsewhere on the board
KSM_PROM_MOSI: IC1.5 (DQ0); also elsewhere on the board
KSM_PROM_SCLK: IC1.6 (C); also elsewhere on the board
unnamed: IC1.3 (!W!/VPP/DQ2), R17.2
VCCO_3V3: C69.1, IC1.7 (!HOLD!/DQ3), IC1.8 (VCC), R17.1, R18.1; also elsewhere on the board

Notes on the sheet:
*) HOLD feature not used
This memory holds cryptographic keys wrapped with the master key.
Keystore memory, 128 Mbit
Keystore memory

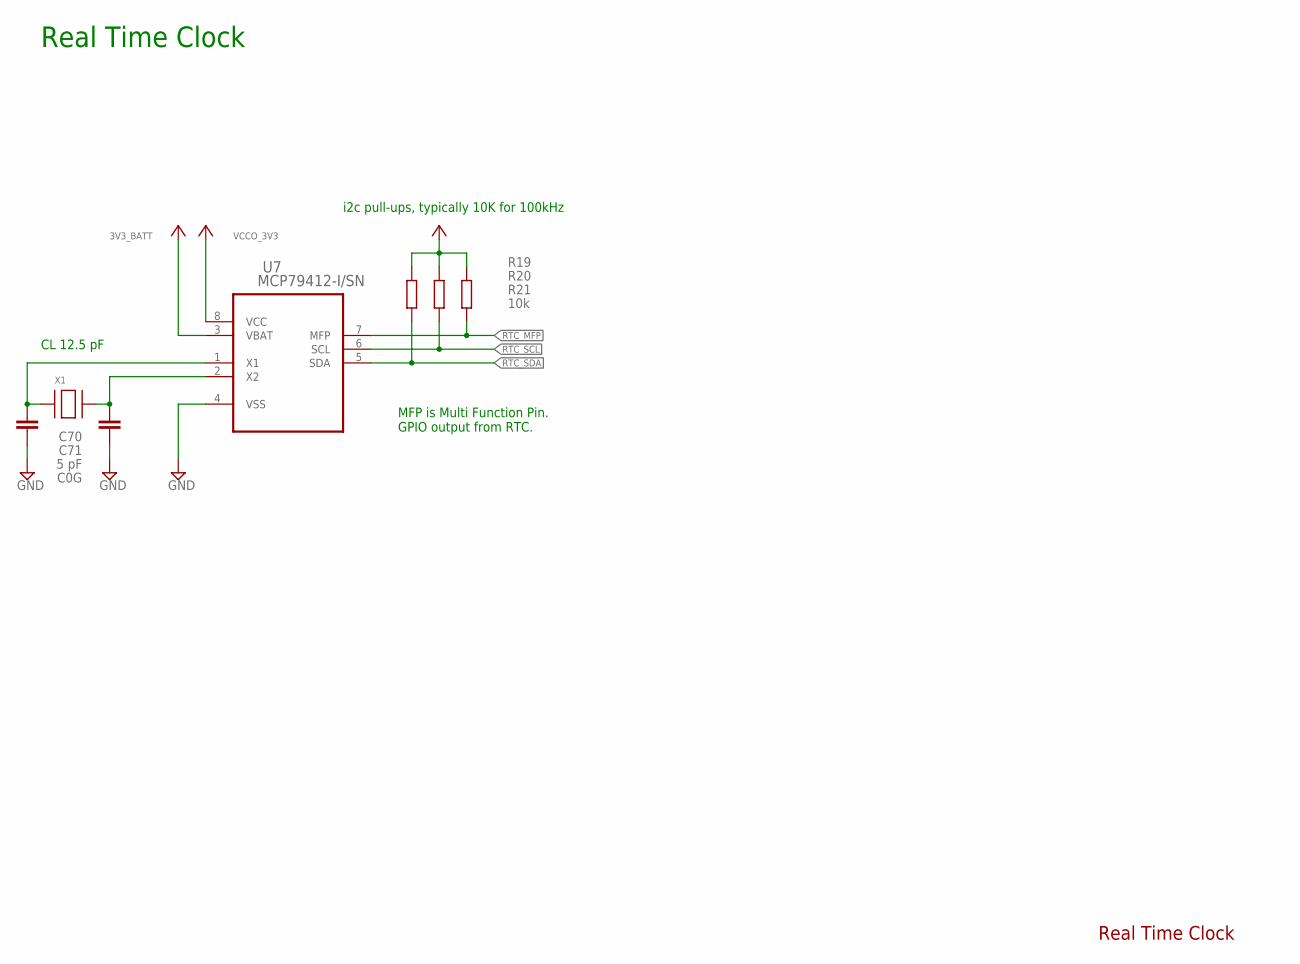
[picture p38: schematic rev02.sch, sheet 9, Real Time Clock]

Parts:
C70, C71: 5 pF; C0402
R19, R20, R21: 10k; R0402; TOLERANCE 5%
U7: MCP79412-I/SN; SOIC127P600X175-8N
X1: XTAL-3.2X1.5; XTAL3215; MPN ABS07-32.768KHZ-T

Connections:
3V3_BATT: U7.3 (VBAT); also elsewhere on the board
GND: C70.1, C71.1, U7.4 (VSS); also elsewhere on the board
RTC_MFP: R21.2, U7.7 (MFP); also elsewhere on the board
RTC_SCL: R20.2, U7.6 (SCL); also elsewhere on the board
RTC_SDA: R19.2, U7.5 (SDA); also elsewhere on the board
RTC_X1: C70.2, U7.1 (X1), X1.P$1
RTC_X2: C71.2, U7.2 (X2), X1.P$2
VCC: R19.1, R20.1, R21.1; also elsewhere on the board
VCCO_3V3: U7.8 (VCC); also elsewhere on the board

Notes on the sheet:
CL 12.5 pF
MFP is Multi Function Pin. GPIO output from RTC.
i2c pull-ups, typically 10K for 100kHz
Real Time Clock

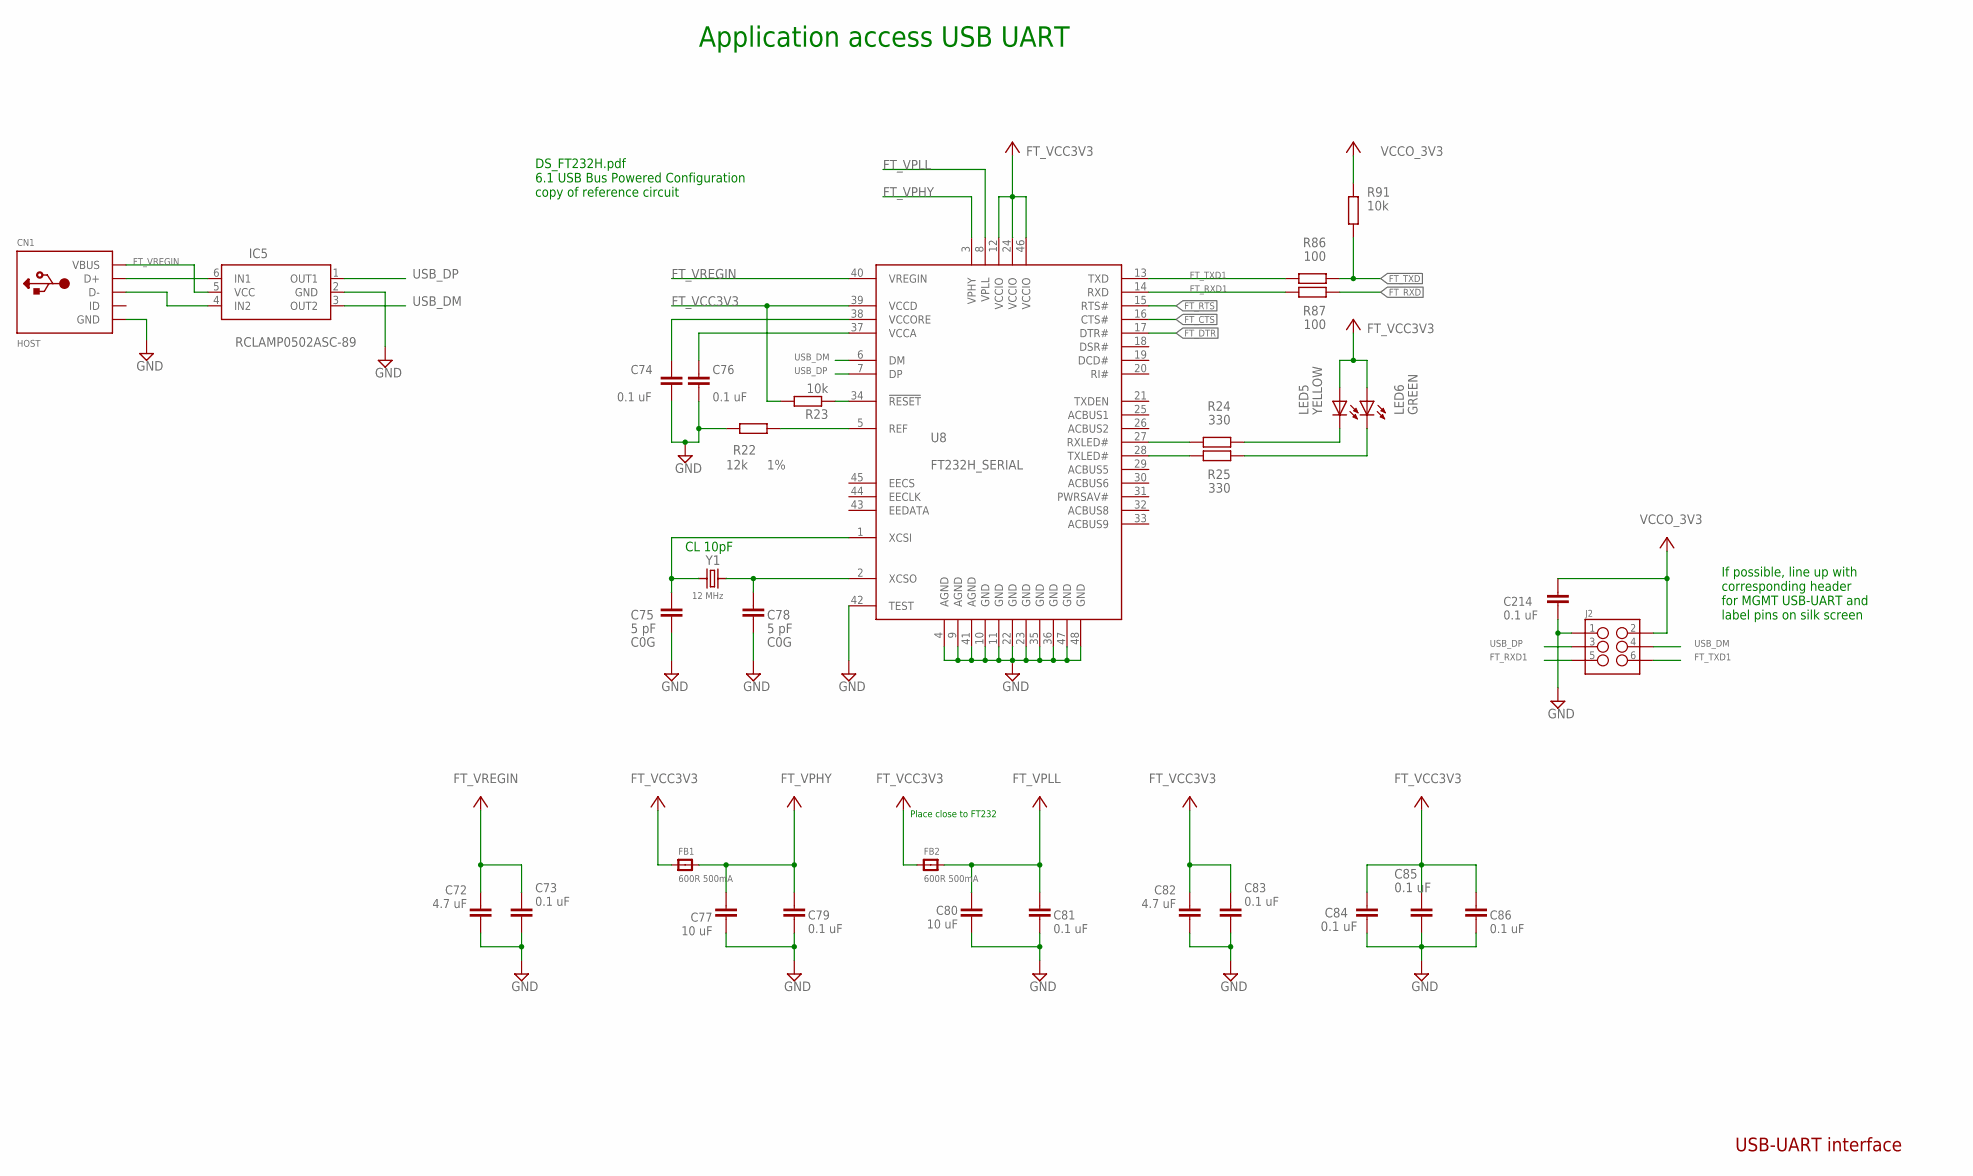
[picture p39: schematic rev02.sch, sheet 10, USB-UART interface]

Parts:
C72, C82: 4.7 uF; C0603
C73, C74, C76, C79, C81, C83, C84, C85, C86, C214: 0.1 uF; C0402
C75, C78: 5 pF; C0402
C77, C80: 10 uF; C0805
CN1: HOST; USB-MINIB
FB1, FB2: 600R 500mA; _0603MP
IC5: RCLAMP0502ASC-89; RCLAMP0502A
J2: M03X2NO_SILK; 2X3-NS
LED5: YELLOW; CHIP-LED0603
LED6: GREEN; CHIP-LED0603
R22: 12k; R0402; TOLERANCE 1%
R23, R91: 10k; R0402; TOLERANCE 5%
R24, R25: 330; R0402; TOLERANCE 5%
R86, R87: 100; R0402; TOLERANCE 5%
U8: FT232H_SERIAL; FT2323HL_LQFP48
Y1: 12 MHz; CRYSTAL_3.2X2.5; TOLERANCE ±30 ppm; MPN ABM8G-12.000MHZ-4Y-T3

Connections:
FT_CTS: U8.16 (CTS#); also elsewhere on the board
FT_DTR: U8.17 (DTR#); also elsewhere on the board
FT_REF: R22.1, U8.5 (REF)
FT_RESET: R23.1, U8.34 (!RESET)
FT_RTS: U8.15 (RTS#); also elsewhere on the board
FT_RXD: R87.1; also elsewhere on the board
FT_RXD1: J2.5, R87.2, U8.14 (RXD)
FT_RXLED: R24.2, U8.27 (RXLED#)
FT_TXD: R86.1, R91.2; also elsewhere on the board
FT_TXD1: J2.6, R86.2, U8.13 (TXD)
FT_TXLED: R25.2, U8.28 (TXLED#)
FT_VCC3V3: C82.1, C83.1, C84.1, C85.1, C86.1, FB1.1, FB2.1, LED5.A, LED6.A, R23.2, U8.12 (VCCIO), U8.24 (VCCIO), U8.39 (VCCD), U8.46 (VCCIO)
FT_VCCA: C76.1, U8.37 (VCCA)
FT_VCCORE: C74.1, U8.38 (VCCORE)
FT_VPHY: C77.1, C79.1, FB1.2, U8.3 (VPHY)
FT_VPLL: C80.1, C81.1, FB2.2, U8.8 (VPLL)
FT_VREGIN: C72.1, C73.1, CN1.VBUS, IC5.5 (VCC), U8.40 (VREGIN)
GND: C72.2, C73.2, C74.2, C75.1, C76.2, C77.2, C78.1, C79.2, C80.2, C81.2, C82.2, C83.2, C84.2, C85.2, C86.2, C214.2, CN1.GND, IC5.2 (GND), J2.1, R22.2, U8.4 (AGND), U8.9 (AGND), U8.10 (GND), U8.11 (GND), U8.22 (GND), U8.23 (GND), U8.35 (GND), U8.36 (GND), U8.41 (AGND), U8.42 (TEST), U8.47 (GND), U8.48 (GND); also elsewhere on the board
unnamed: C75.2, U8.1 (XCSI), Y1.1
unnamed: C78.2, U8.2 (XCSO), Y1.2
unnamed: LED5.C, R24.1
unnamed: LED6.C, R25.1
unnamed: CN1.D+, IC5.6 (IN1)
unnamed: CN1.D-, IC5.4 (IN2)
USB_DM: IC5.3 (OUT2), U8.6 (DM)
USB_DP: IC5.1 (OUT1), U8.7 (DP)
VCCO_3V3: C214.1, J2.2, R91.1; also elsewhere on the board

Notes on the sheet:
DS_FT232H.pdf 6.1 USB Bus Powered Configuration copy of reference circuit
Place close to FT232
CL 10pF
Application access USB UART
USB-UART interface
If possible, line up with corresponding header for MGMT USB-UART and label pins on silk screen

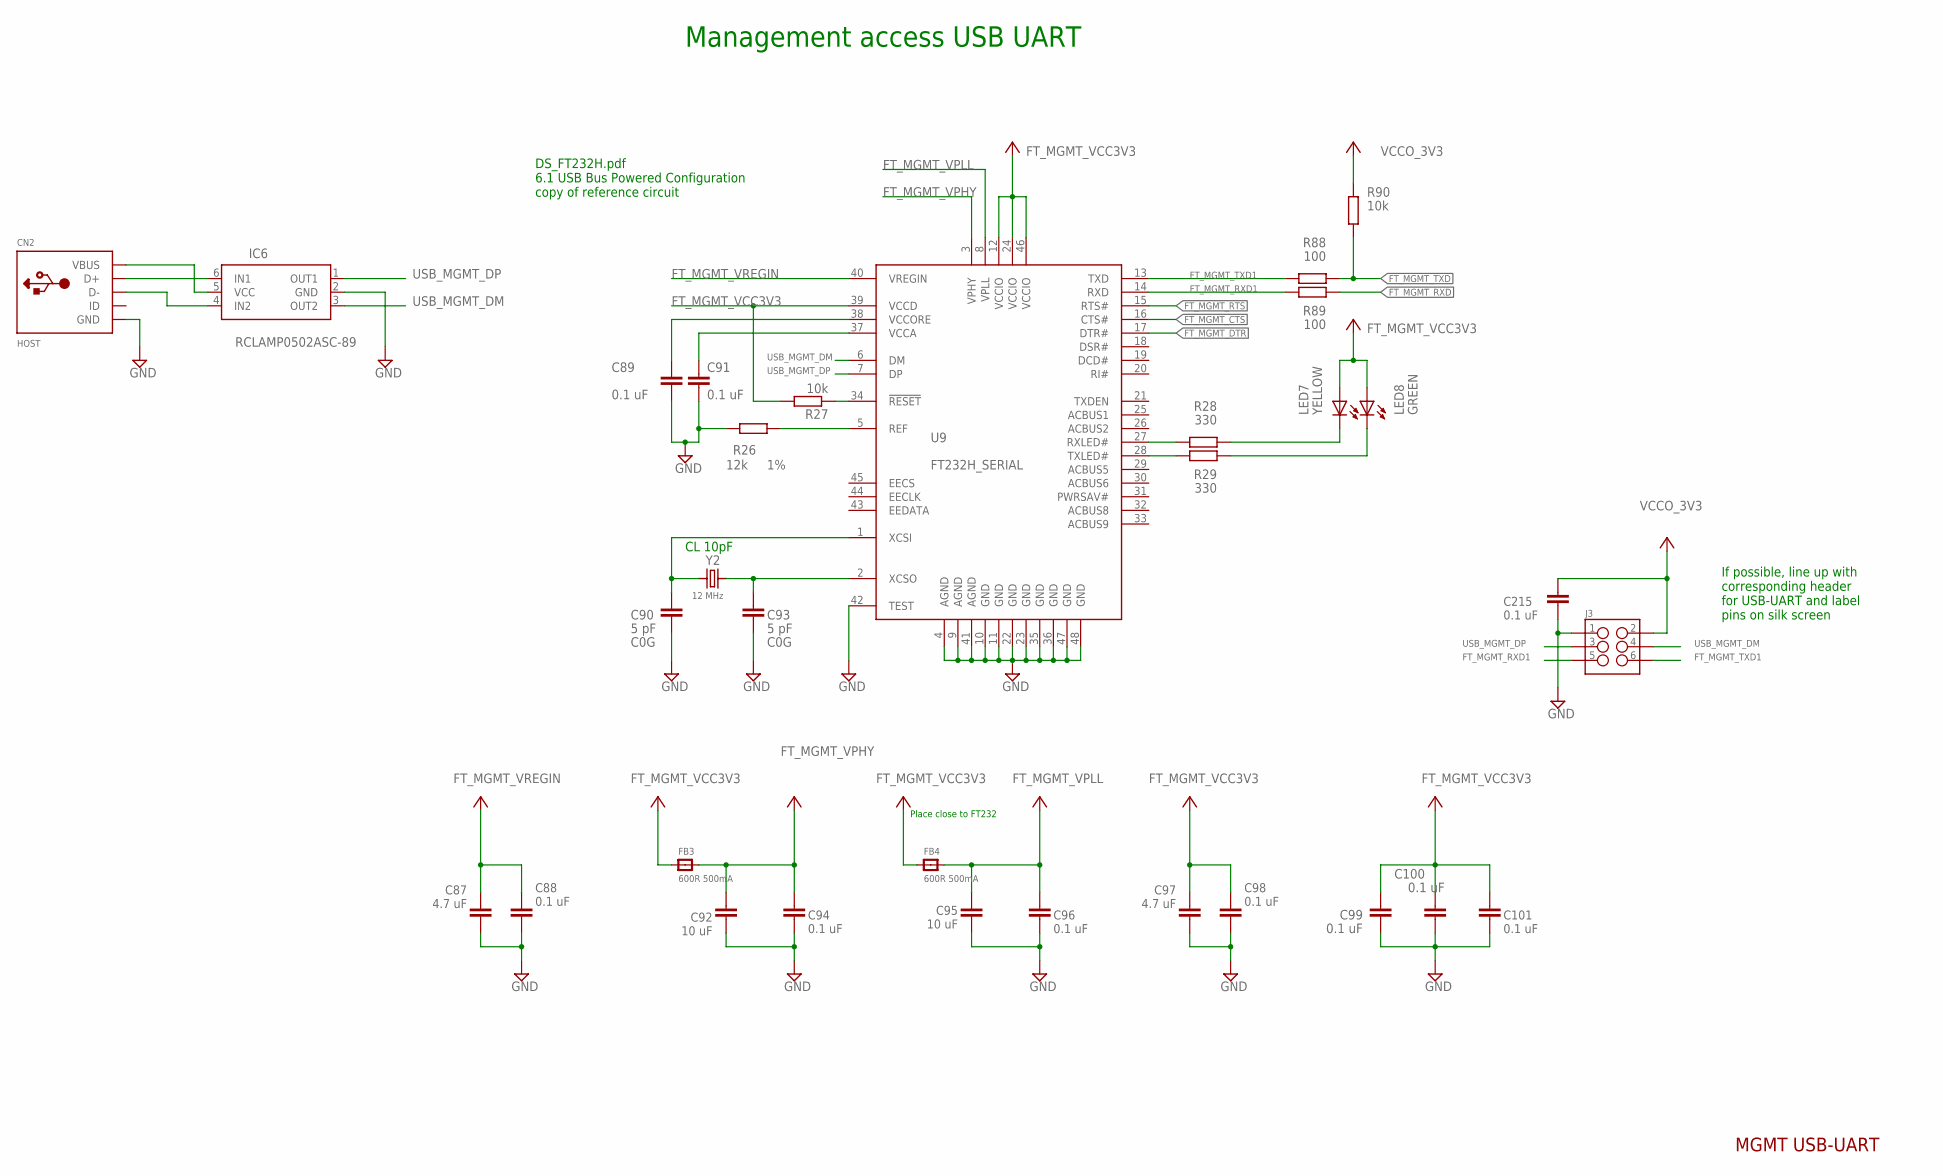
[picture p40: schematic rev02.sch, sheet 11, MGMT USB-UART]

Parts:
C87, C97: 4.7 uF; C0603
C88, C89, C91, C94, C96, C98, C99, C100, C101, C215: 0.1 uF; C0402
C90, C93: 5 pF; C0402
C92, C95: 10 uF; C0805
CN2: HOST; USB-MINIB
FB3, FB4: 600R 500mA; _0603MP
IC6: RCLAMP0502ASC-89; RCLAMP0502A
J3: M03X2NO_SILK; 2X3-NS
LED7: YELLOW; CHIP-LED0603
LED8: GREEN; CHIP-LED0603
R26: 12k; R0402; TOLERANCE 1%
R27, R90: 10k; R0402; TOLERANCE 5%
R28, R29: 330; R0402; TOLERANCE 5%
R88, R89: 100; R0402; TOLERANCE 5%
U9: FT232H_SERIAL; FT2323HL_LQFP48
Y2: 12 MHz; CRYSTAL_3.2X2.5; TOLERANCE ±30 ppm; MPN ABM8G-12.000MHZ-4Y-T3

Connections:
FT_MGMT_CTS: U9.16 (CTS#); also elsewhere on the board
FT_MGMT_DTR: U9.17 (DTR#); also elsewhere on the board
FT_MGMT_RTS: U9.15 (RTS#); also elsewhere on the board
FT_MGMT_RXD: R89.1; also elsewhere on the board
FT_MGMT_RXD1: J3.5, R89.2
FT_MGMT_TXD: R88.1, R90.2; also elsewhere on the board
FT_MGMT_TXD1: J3.6, R88.2
FT_MGMT_VCC3V3: C97.1, C98.1, C99.1, C100.1, C101.1, FB3.1, FB4.1, LED7.A, LED8.A, R27.2, U9.12 (VCCIO), U9.24 (VCCIO), U9.39 (VCCD), U9.46 (VCCIO)
FT_MGMT_VPHY: C92.1, C94.1, FB3.2, U9.3 (VPHY)
FT_MGMT_VPLL: C95.1, C96.1, FB4.2, U9.8 (VPLL)
FT_MGMT_VREGIN: C87.1, C88.1, CN2.VBUS, IC6.5 (VCC), U9.40 (VREGIN)
FT_REF1: R26.1, U9.5 (REF)
FT_RESET1: R27.1, U9.34 (!RESET)
FT_RXLED1: R28.2, U9.27 (RXLED#)
FT_TXLED1: R29.2, U9.28 (TXLED#)
FT_VCCA1: C91.1, U9.37 (VCCA)
FT_VCCORE1: C89.1, U9.38 (VCCORE)
GND: C87.2, C88.2, C89.2, C90.1, C91.2, C92.2, C93.1, C94.2, C95.2, C96.2, C97.2, C98.2, C99.2, C100.2, C101.2, C215.2, CN2.GND, IC6.2 (GND), J3.1, R26.2, U9.4 (AGND), U9.9 (AGND), U9.10 (GND), U9.11 (GND), U9.22 (GND), U9.23 (GND), U9.35 (GND), U9.36 (GND), U9.41 (AGND), U9.42 (TEST), U9.47 (GND), U9.48 (GND); also elsewhere on the board
unnamed: LED7.C, R28.1
unnamed: LED8.C, R29.1
unnamed: C93.2, U9.2 (XCSO), Y2.2
unnamed: C90.2, U9.1 (XCSI), Y2.1
unnamed: CN2.D+, IC6.6 (IN1)
unnamed: CN2.D-, IC6.4 (IN2)
USB_MGMT_DM: IC6.3 (OUT2), J3.4, U9.6 (DM)
USB_MGMT_DP: IC6.1 (OUT1), J3.3, U9.7 (DP)
VCCO_3V3: C215.1, J3.2, R90.1; also elsewhere on the board

Notes on the sheet:
DS_FT232H.pdf 6.1 USB Bus Powered Configuration copy of reference circuit
Place close to FT232
CL 10pF
Management access USB UART
MGMT USB-UART
If possible, line up with corresponding header for USB-UART and label pins on silk screen

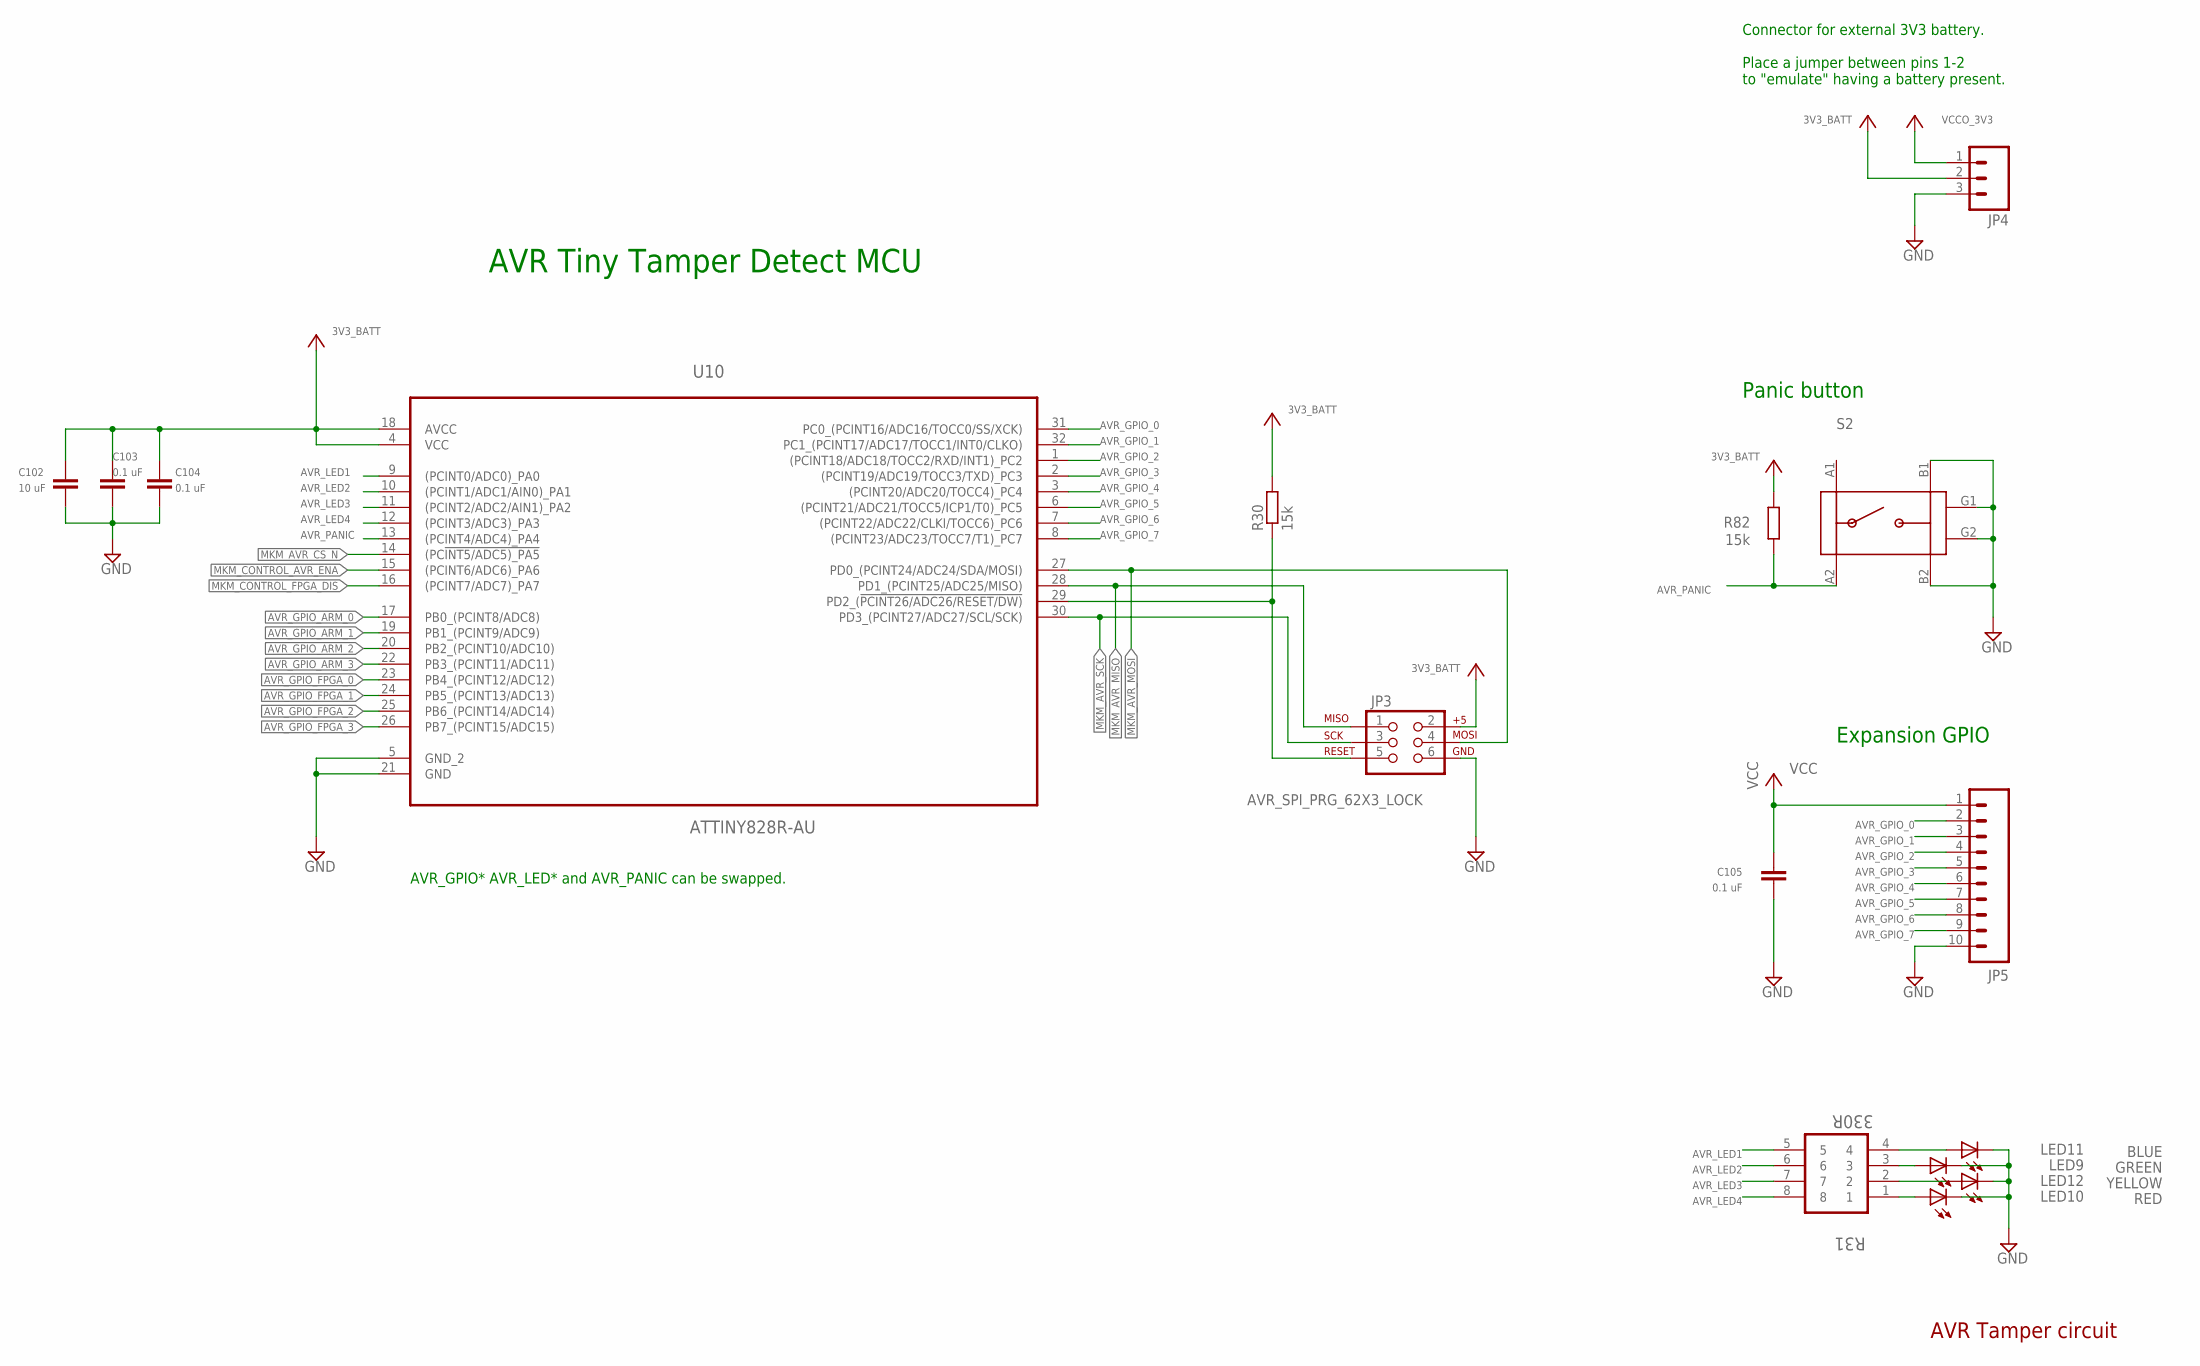
[picture p41: schematic rev02.sch, sheet 12, AVR Tamper circuit]

Parts:
C102: 10 uF; C0805
C103, C104, C105: 0.1 uF; C0402
JP3: AVR_SPI_PRG_62X3_LOCK; 2X3_LOCK
JP4: M03LOCK; 1X03_LOCK
JP5: M10LOCK; 1X10_LOCK
LED9: GREEN; CHIP-LED0603
LED10: RED; CHIP-LED0603
LED11: BLUE; CHIP-LED0603
LED12: YELLOW; CHIP-LED0603
R30, R82: 15k; R0402
R31: 330R; RESCAXE80P320X160X60-8N
S2: TACTILE_SWITCH
U10: ATTINY828R-AU; QFP80P900X900X120-32N

Connections:
3V3_BATT: C102.1, C103.1, C104.1, JP3.2, JP4.2, R30.2, R82.2, U10.4 (VCC), U10.18 (AVCC); also elsewhere on the board
AVR_GPIO_0: JP5.2, U10.31 (PC0_(PCINT16/ADC16/TOCC0/SS/XCK))
AVR_GPIO_1: JP5.3, U10.32 (PC1_(PCINT17/ADC17/TOCC1/INT0/CLKO))
AVR_GPIO_2: JP5.4, U10.1 ((PCINT18/ADC18/TOCC2/RXD/INT1)_PC2)
AVR_GPIO_3: JP5.5, U10.2 ((PCINT19/ADC19/TOCC3/TXD)_PC3)
AVR_GPIO_4: JP5.6, U10.3 ((PCINT20/ADC20/TOCC4)_PC4)
AVR_GPIO_5: JP5.7, U10.6 ((PCINT21/ADC21/TOCC5/ICP1/T0)_PC5)
AVR_GPIO_6: JP5.8, U10.7 ((PCINT22/ADC22/CLKI/TOCC6)_PC6)
AVR_GPIO_7: JP5.9, U10.8 ((PCINT23/ADC23/TOCC7/T1)_PC7)
AVR_GPIO_ARM_0: U10.17 (PB0_(PCINT8/ADC8)); also elsewhere on the board
AVR_GPIO_ARM_1: U10.19 (PB1_(PCINT9/ADC9)); also elsewhere on the board
AVR_GPIO_FPGA_2: U10.25 (PB6_(PCINT14/ADC14))
AVR_GPIO_FPGA_3: U10.26 (PB7_(PCINT15/ADC15))
AVR_LED1: R31.5, U10.9 ((PCINT0/ADC0)_PA0)
AVR_LED2: R31.6, U10.10 ((PCINT1/ADC1/AIN0)_PA1)
AVR_LED3: R31.7, U10.11 ((PCINT2/ADC2/AIN1)_PA2)
AVR_LED4: R31.8, U10.12 ((PCINT3/ADC3)_PA3)
AVR_PANIC: R82.1, S2.A2
AVR_RESET: JP3.5, R30.1, U10.29 (PD2_(!PCINT26/ADC26/RESET/DW))
GND: C102.2, C103.2, C104.2, C105.2, JP3.6, JP4.3, JP5.10, LED9.C, LED10.C, LED11.C, LED12.C, S2.B1, S2.B2, S2.G1, S2.G2, U10.5 (GND_2), U10.21 (GND); also elsewhere on the board
MKM_AVR_CS_N: U10.14 ((PC!INT5/ADC5)_PA5); also elsewhere on the board
MKM_AVR_MISO: JP3.1, U10.28 (PD1_(PCINT25/ADC25/MISO)); also elsewhere on the board
MKM_AVR_MOSI: JP3.4, U10.27 (PD0_(PCINT24/ADC24/SDA/MOSI)); also elsewhere on the board
MKM_AVR_SCK: JP3.3, U10.30 (PD3_(PCINT27/ADC27/SCL/SCK)); also elsewhere on the board
MKM_CONTROL_AVR_ENA: U10.15 ((PCINT6/ADC6)_PA6); also elsewhere on the board
unnamed: LED11.A, R31.4
unnamed: LED9.A, R31.3
unnamed: LED12.A, R31.2
unnamed: LED10.A, R31.1
VCC: C105.1, JP5.1; also elsewhere on the board
VCCO_3V3: JP4.1; also elsewhere on the board

Notes on the sheet:
AVR Tiny Tamper Detect MCU
Panic button
Expansion GPIO
Connector for external 3V3 battery. Place a jumper between pins 1-2 to "emulate" having a battery present.
AVR_GPIO* AVR_LED* and AVR_PANIC can be swapped.
AVR Tamper circuit
