vgisc/cryptech.hardware/cad/rev02/alpha/rev02/rev02.brd

## EAGLE design cad/rev02/alpha/rev02/rev02.brd (continued)

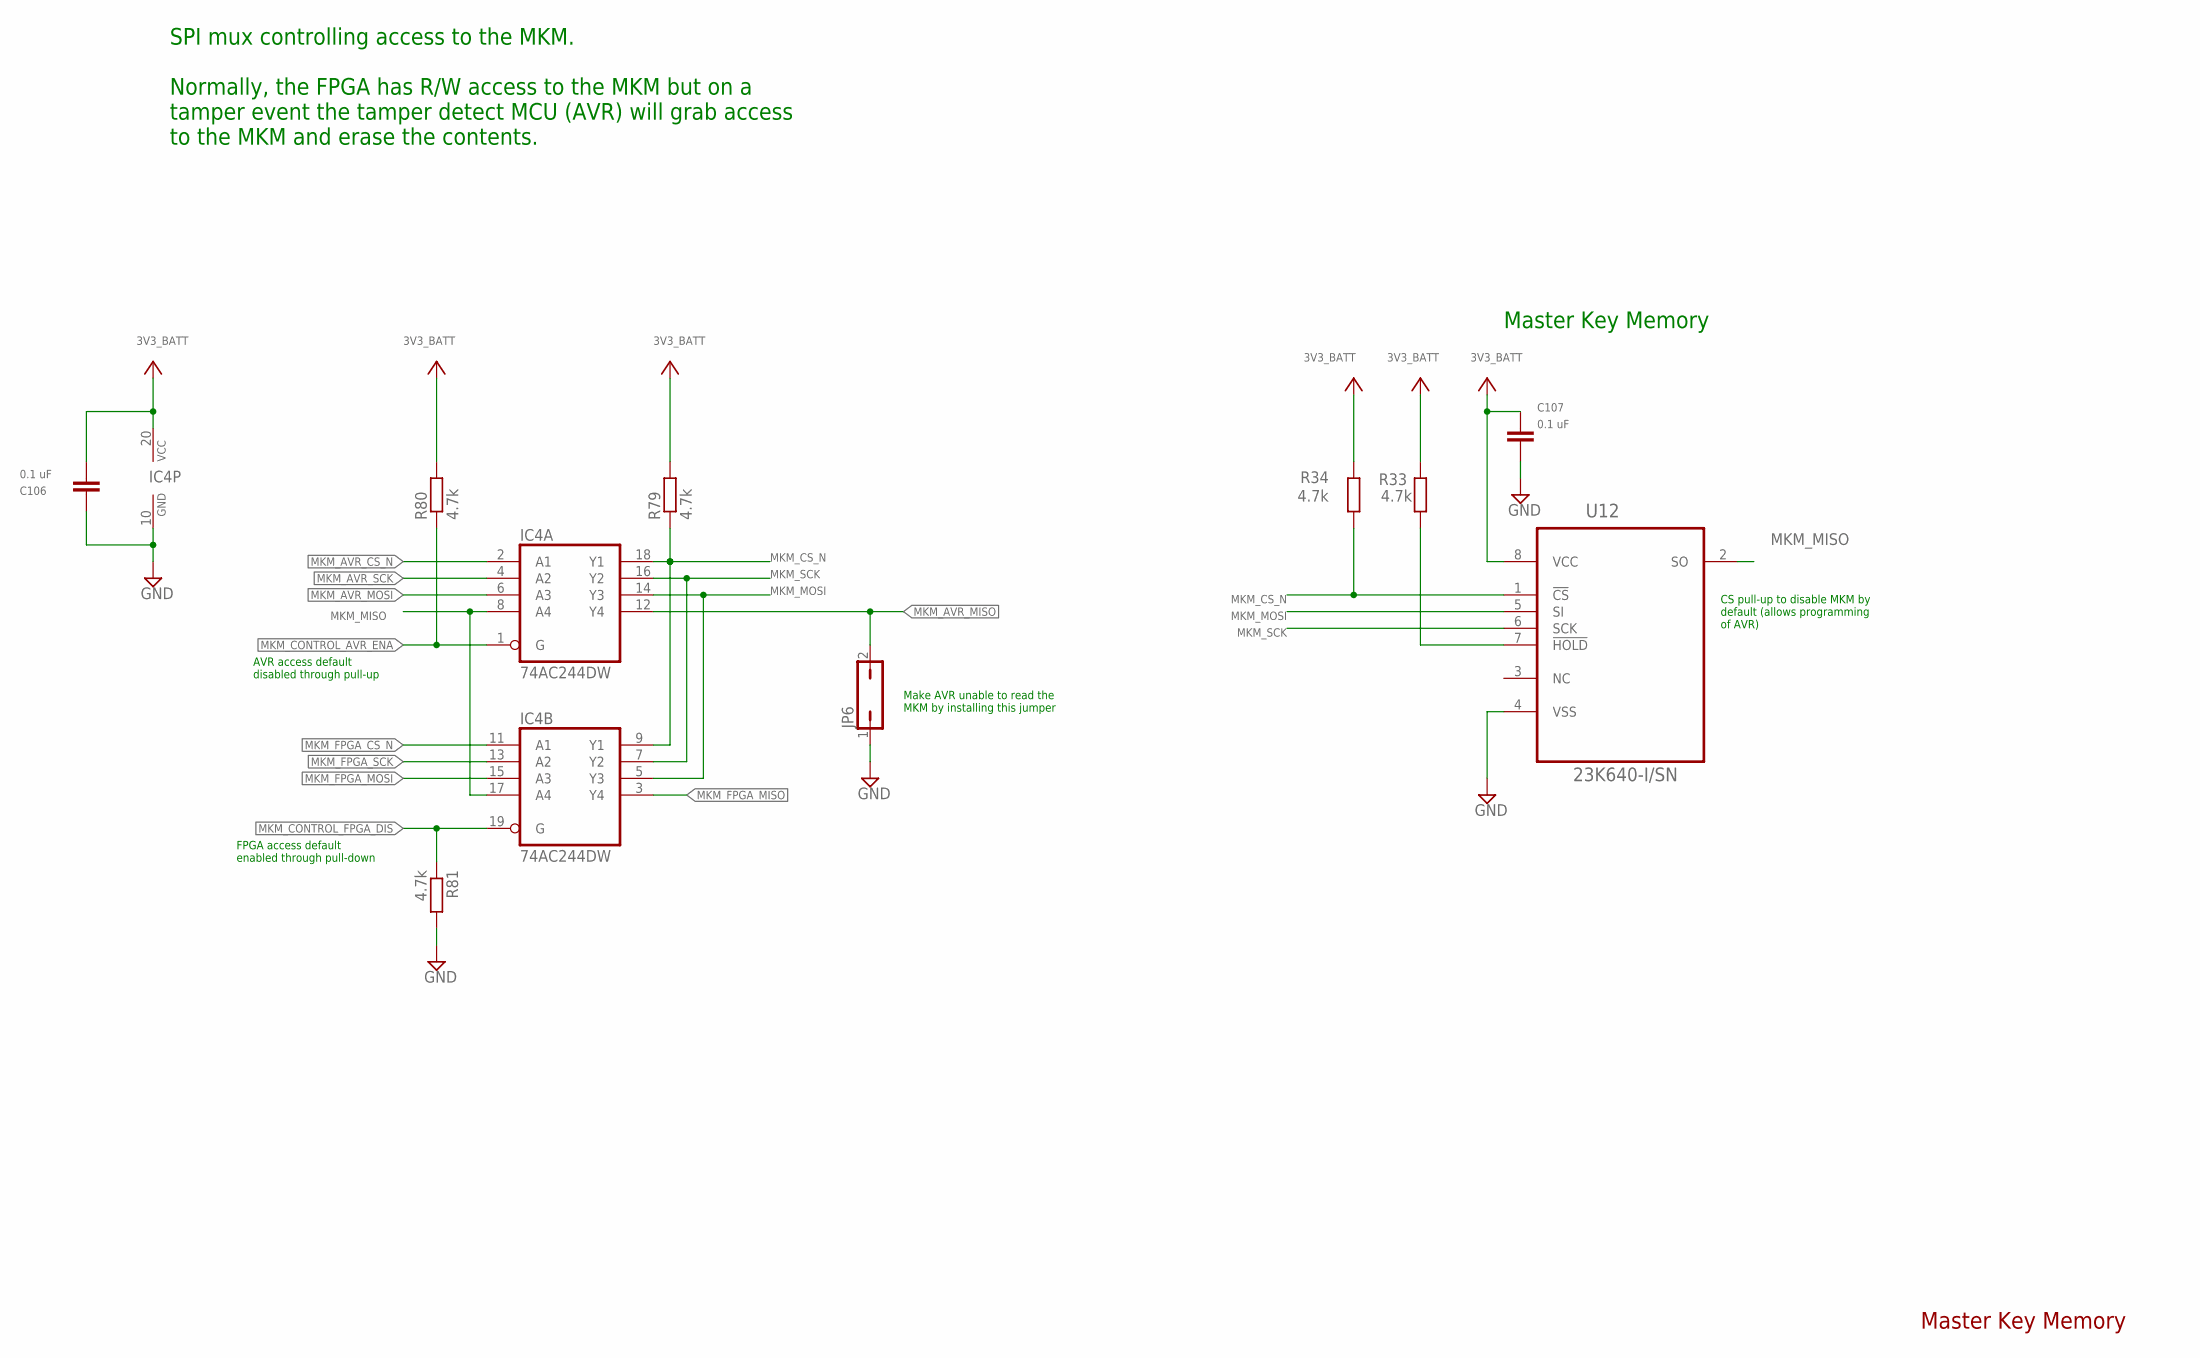
[picture p42: schematic rev02.sch, sheet 13, Master Key Memory]

Parts:
C106, C107: 0.1 uF; C0402
IC4: 74AC244DW; SO20W
JP6: JP1Q; JP1
R33, R34: 4.7k; R0402
R79, R80, R81: 4.7k; R0402; TOLERANCE 5%
U12: 23K640-I/SN; SOIC127P600X175-8N

Connections:
3V3_BATT: C106.1, C107.1, IC4.20 (VCC), R33.1, R34.2, R79.2, R80.2, U12.8 (VCC); also elsewhere on the board
GND: C106.2, C107.2, IC4.10 (GND), JP6.1, R81.2, U12.4 (VSS); also elsewhere on the board
MKM_AVR_CS_N: IC4.2 (A1); also elsewhere on the board
MKM_AVR_MISO: IC4.12 (Y4), JP6.2; also elsewhere on the board
MKM_AVR_MOSI: IC4.6 (A3); also elsewhere on the board
MKM_AVR_SCK: IC4.4 (A2); also elsewhere on the board
MKM_CONTROL_AVR_ENA: IC4.1 (G), R80.1; also elsewhere on the board
MKM_CONTROL_FPGA_DIS: IC4.19 (G), R81.1
MKM_CS_N: IC4.9 (Y1), IC4.18 (Y1), R34.1, R79.1, U12.1 (!CS)
MKM_FPGA_CS_N: IC4.11 (A1); also elsewhere on the board
MKM_FPGA_MISO: IC4.3 (Y4); also elsewhere on the board
MKM_FPGA_MOSI: IC4.15 (A3); also elsewhere on the board
MKM_FPGA_SCK: IC4.13 (A2); also elsewhere on the board
MKM_MISO: IC4.8 (A4), IC4.17 (A4), U12.2 (SO)
MKM_MOSI: IC4.5 (Y3), IC4.14 (Y3), U12.5 (SI)
MKM_SCK: IC4.7 (Y2), IC4.16 (Y2), U12.6 (SCK)
unnamed: R33.2, U12.7 (!HOLD)

Notes on the sheet:
CS pull-up to disable MKM by default (allows programming of AVR)
Master Key Memory
SPI mux controlling access to the MKM. Normally, the FPGA has R/W access to the MKM but on a tamper event the tamper detect MCU (AVR) will grab access to the MKM and erase the contents.
Make AVR unable to read the MKM by installing this jumper
AVR access default disabled through pull-up
FPGA access default enabled through pull-down

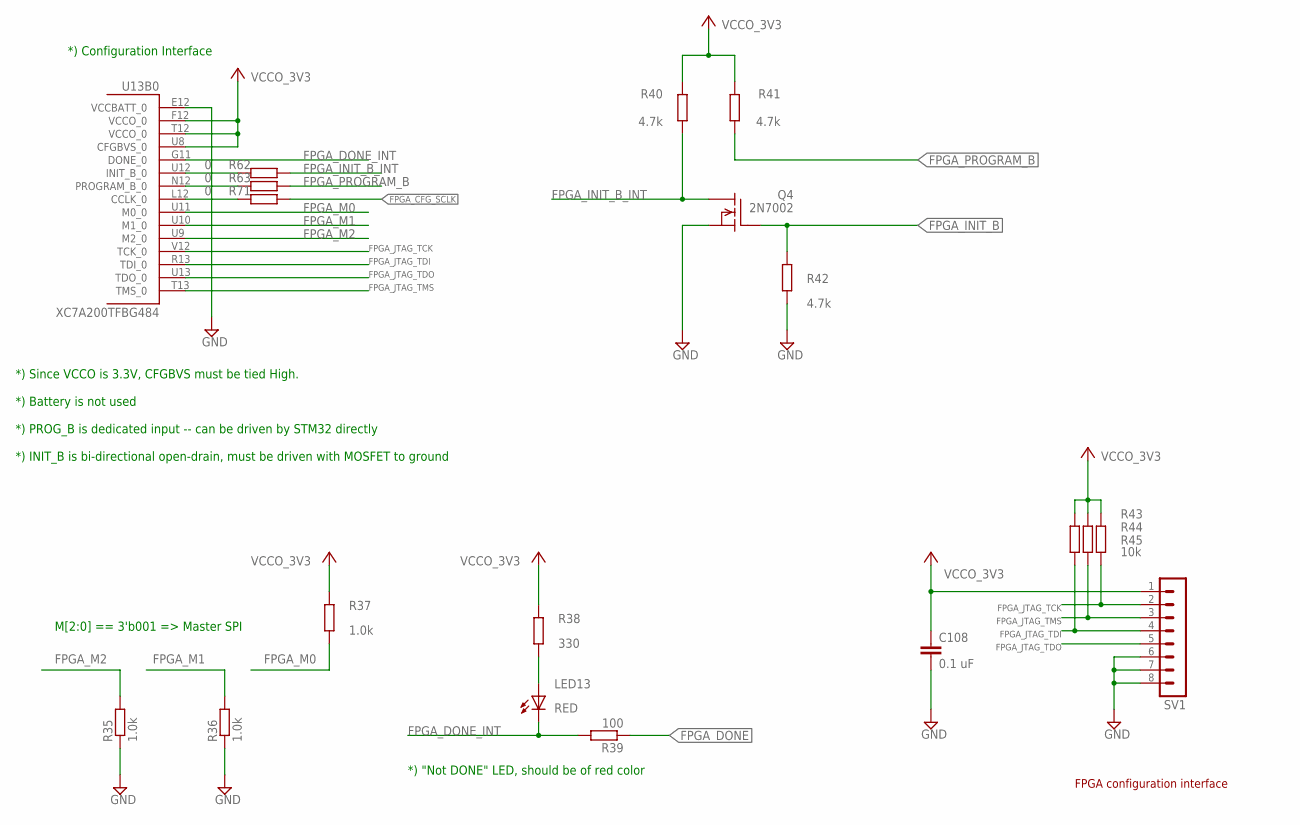
[picture p43: schematic rev02.sch, sheet 14, FPGA configuration interface]

Parts:
C108: 0.1 uF; C0402; TOLERANCE 10%
LED13: RED; CHIP-LED0603
Q4: 2N7002; SOT23
R35, R36, R37: 1.0k; R0402; TOLERANCE 5%
R38: 330; R0402; TOLERANCE 5%
R39: 100; R0402; TOLERANCE 5%
R40, R41, R42: 4.7k; R0402; TOLERANCE 5%
R43, R44, R45: 10k; R0402; TOLERANCE 5%
R62, R63, R71: 0; R0603; TOLERANCE 5%
SV1: MA08-1
U13: XC7A200TFBG484; FF484; MPN XC7A200T-1FBG484C

Connections:
FPGA_CFG_SCLK: R71.1; also elsewhere on the board
FPGA_CFG_SCLK1: R71.2, U13.L12 (CCLK_0)
FPGA_DONE: R39.1; also elsewhere on the board
FPGA_DONE_INT: LED13.C, R39.2, U13.G11 (DONE_0)
FPGA_INIT_B: Q4.1 (G), R42.2; also elsewhere on the board
FPGA_INIT_B_INT: Q4.3 (D), R40.1, R62.1
FPGA_INIT_B_INT1: R62.2, U13.U12 (INIT_B_0)
FPGA_JTAG_TCK: R45.1, SV1.2, U13.V12 (TCK_0)
FPGA_JTAG_TDI: R43.1, SV1.4, U13.R13 (TDI_0)
FPGA_JTAG_TDO: SV1.5, U13.U13 (TDO_0)
FPGA_JTAG_TMS: R44.1, SV1.3, U13.T13 (TMS_0)
FPGA_M0: R37.1, U13.U11 (M0_0)
FPGA_M1: R36.2, U13.U10 (M1_0)
FPGA_M2: R35.2, U13.U9 (M2_0)
FPGA_PROGRAM_B: R41.1, R63.1; also elsewhere on the board
FPGA_PROGRAM_B1: R63.2, U13.N12 (PROGRAM_B_0)
GND: C108.2, Q4.2 (S), R35.1, R36.1, R42.1, SV1.6, SV1.7, SV1.8, U13.E12 (VCCBATT_0); also elsewhere on the board
unnamed: LED13.A, R38.1
VCCO_3V3: C108.1, R37.2, R38.2, R40.2, R41.2, R43.2, R44.2, R45.2, SV1.1, U13.F12 (VCCO_0), U13.T12 (VCCO_0), U13.U8 (CFGBVS_0); also elsewhere on the board

Notes on the sheet:
*) Configuration Interface
M[2:0] == 3'b001 => Master SPI
*) Since VCCO is 3.3V, CFGBVS must be tied High. *) Battery is not used *) PROG_B is dedicated input -- can be driven by STM32 directly *) INIT_B is bi-directional open-drain, must be driven with MOSFET to ground
*) "Not DONE" LED, should be of red color
FPGA configuration interface

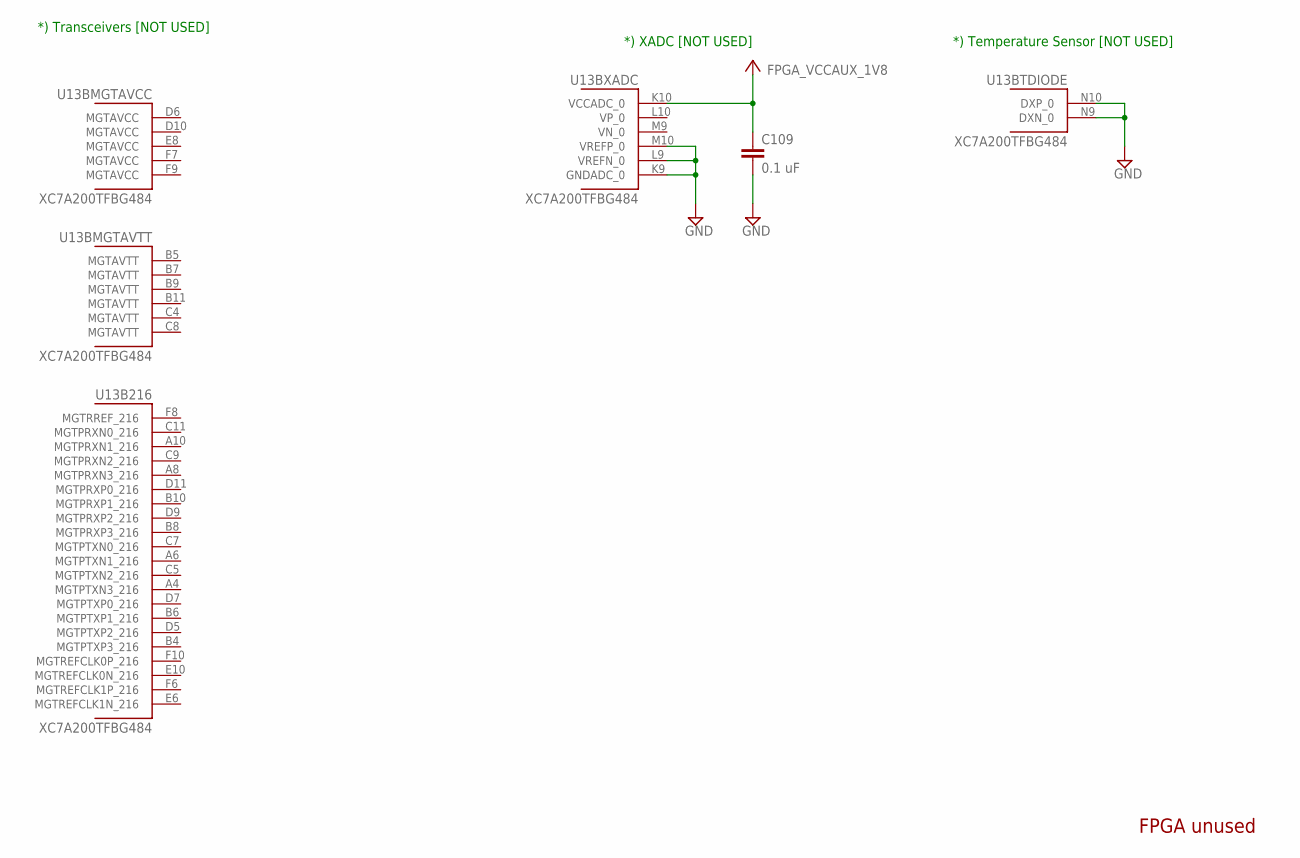
[picture p44: schematic rev02.sch, sheet 15, FPGA unused]

Parts:
C109: 0.1 uF; C0402; TOLERANCE 10%
U13: XC7A200TFBG484; FF484; MPN XC7A200T-1FBG484C

Connections:
FPGA_VCCAUX_1V8: C109.1, U13.K10 (VCCADC_0); also elsewhere on the board
GND: C109.2, U13.K9 (GNDADC_0), U13.L9 (VREFN_0), U13.M10 (VREFP_0), U13.N9 (DXN_0), U13.N10 (DXP_0); also elsewhere on the board

Notes on the sheet:
*) Temperature Sensor [NOT USED]
*) XADC [NOT USED]
*) Transceivers [NOT USED]
FPGA unused

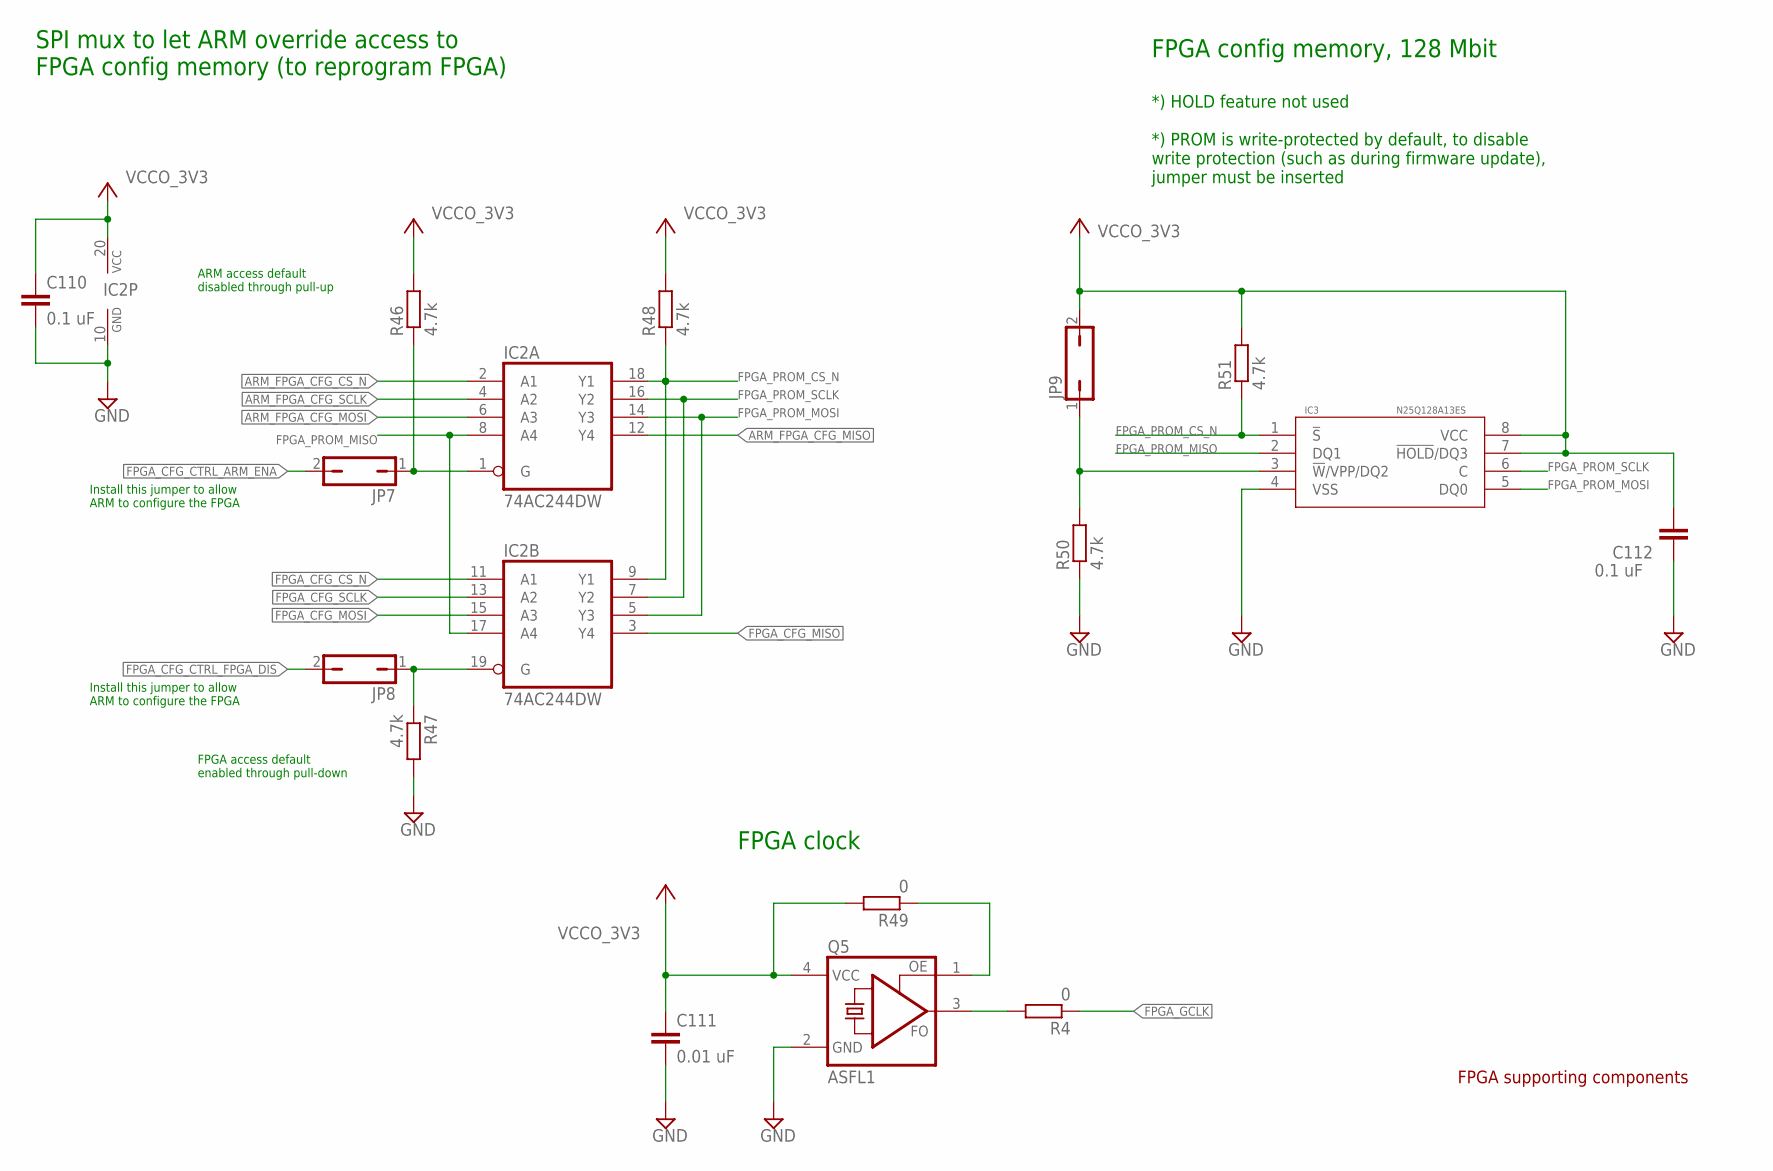
[picture p45: schematic rev02.sch, sheet 16, FPGA supporting components]

Parts:
C110: 0.1 uF; C0402
C111: 0.01 uF; C0402; TOLERANCE 10%
C112: 0.1 uF; C0402; TOLERANCE 10%
IC2: 74AC244DW; SO20W
IC3: N25Q128A13ES; SO08
JP7, JP8, JP9: JP1Q; JP1
Q5: ASFL1; ASF; MPN ASFL1-50.000MHZ-EK-T
R4, R49: 0; R0402
R46, R47, R48, R50, R51: 4.7k; R0402; TOLERANCE 5%

Connections:
ARM_FPGA_CFG_CS_N: IC2.2 (A1); also elsewhere on the board
ARM_FPGA_CFG_MISO: IC2.12 (Y4); also elsewhere on the board
ARM_FPGA_CFG_MOSI: IC2.6 (A3); also elsewhere on the board
ARM_FPGA_CFG_SCLK: IC2.4 (A2); also elsewhere on the board
FPGA_CFG_CS_N: IC2.11 (A1); also elsewhere on the board
FPGA_CFG_CTRL_ARM_ENA: JP7.2; also elsewhere on the board
FPGA_CFG_CTRL_FPGA_DIS: JP8.2; also elsewhere on the board
FPGA_CFG_MISO: IC2.3 (Y4); also elsewhere on the board
FPGA_CFG_MOSI: IC2.15 (A3); also elsewhere on the board
FPGA_CFG_SCLK: IC2.13 (A2); also elsewhere on the board
FPGA_PROM_CS_N: IC2.9 (Y1), IC2.18 (Y1), IC3.1 (!S), R48.1, R51.1
FPGA_PROM_MISO: IC2.8 (A4), IC2.17 (A4), IC3.2 (DQ1)
FPGA_PROM_MOSI: IC2.5 (Y3), IC2.14 (Y3), IC3.5 (DQ0)
FPGA_PROM_SCLK: IC2.7 (Y2), IC2.16 (Y2), IC3.6 (C)
FPGA_PROM_W_N: IC3.3 (!W!/VPP/DQ2), JP9.1, R50.2
GND: C110.2, C111.2, C112.2, IC2.10 (GND), IC3.4 (VSS), Q5.2 (GND), R47.2, R50.1; also elsewhere on the board
unnamed: Q5.3 (FO), R4.2
unnamed: Q5.1 (OE), R49.1
SPI_A_TRISTATE: IC2.1 (G), JP7.1, R46.1
SPI_B_TRISTATE: IC2.19 (G), JP8.1, R47.1
VCCO_3V3: C110.1, C111.1, C112.1, IC2.20 (VCC), IC3.7 (!HOLD!/DQ3), IC3.8 (VCC), JP9.2, Q5.4 (VCC), R46.2, R48.2, R49.2, R51.2; also elsewhere on the board

Notes on the sheet:
*) HOLD feature not used *) PROM is write-protected by default, to disable write protection (such as during firmware update), jumper must be inserted
FPGA clock
FPGA config memory, 128 Mbit
SPI mux to let ARM override access to FPGA config memory (to reprogram FPGA)
Install this jumper to allow ARM to configure the FPGA
ARM access default disabled through pull-up
FPGA access default enabled through pull-down
FPGA supporting components

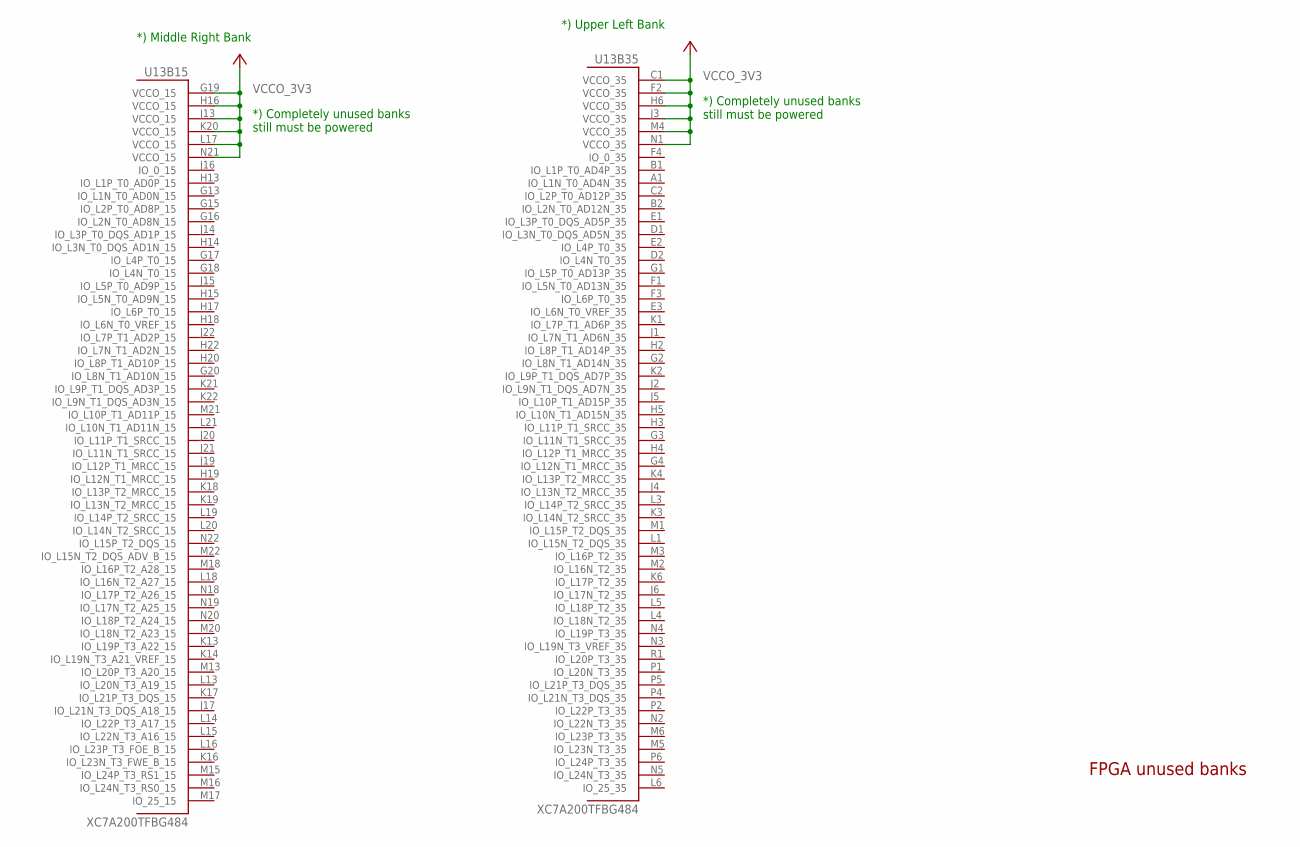
[picture p46: schematic rev02.sch, sheet 17, FPGA unused banks]

Parts:
U13: XC7A200TFBG484; FF484; MPN XC7A200T-1FBG484C

Connections:
VCCO_3V3: U13.C1 (VCCO_35), U13.F2 (VCCO_35), U13.G19 (VCCO_15), U13.H6 (VCCO_35), U13.H16 (VCCO_15), U13.J3 (VCCO_35), U13.J13 (VCCO_15), U13.K20 (VCCO_15), U13.L17 (VCCO_15), U13.M4 (VCCO_35), U13.N1 (VCCO_35), U13.N21 (VCCO_15); also elsewhere on the board

Notes on the sheet:
*) Middle Right Bank
*) Upper Left Bank
*) Completely unused banks still must be powered
FPGA unused banks

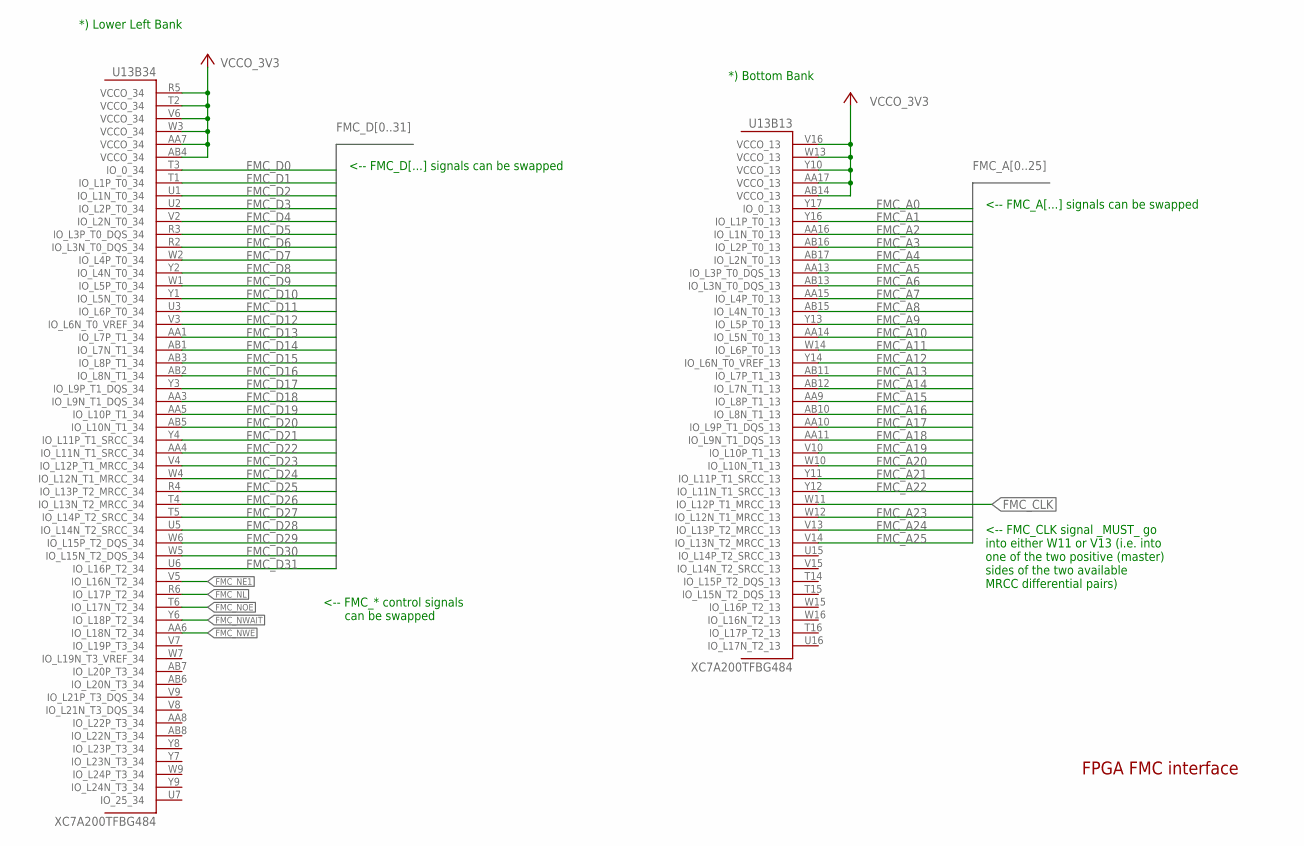
[picture p47: schematic rev02.sch, sheet 18, FPGA FMC interface]

Parts:
U13: XC7A200TFBG484; FF484; MPN XC7A200T-1FBG484C

Connections:
FMC_A0: U13.Y17 (IO_0_13); also elsewhere on the board
FMC_A1: U13.Y16 (IO_L1P_T0_13); also elsewhere on the board
FMC_A2: U13.AA16 (IO_L1N_T0_13); also elsewhere on the board
FMC_A3: U13.AB16 (IO_L2P_T0_13); also elsewhere on the board
FMC_A4: U13.AB17 (IO_L2N_T0_13); also elsewhere on the board
FMC_A5: U13.AA13 (IO_L3P_T0_DQS_13); also elsewhere on the board
FMC_A6: U13.AB13 (IO_L3N_T0_DQS_13); also elsewhere on the board
FMC_A7: U13.AA15 (IO_L4P_T0_13); also elsewhere on the board
FMC_A8: U13.AB15 (IO_L4N_T0_13); also elsewhere on the board
FMC_A9: U13.Y13 (IO_L5P_T0_13); also elsewhere on the board
FMC_A10: U13.AA14 (IO_L5N_T0_13); also elsewhere on the board
FMC_A11: U13.W14 (IO_L6P_T0_13); also elsewhere on the board
FMC_A12: U13.Y14 (IO_L6N_T0_VREF_13); also elsewhere on the board
FMC_A13: U13.AB11 (IO_L7P_T1_13); also elsewhere on the board
FMC_A14: U13.AB12 (IO_L7N_T1_13); also elsewhere on the board
FMC_A15: U13.AA9 (IO_L8P_T1_13); also elsewhere on the board
FMC_A16: U13.AB10 (IO_L8N_T1_13); also elsewhere on the board
FMC_A17: U13.AA10 (IO_L9P_T1_DQS_13); also elsewhere on the board
FMC_A18: U13.AA11 (IO_L9N_T1_DQS_13); also elsewhere on the board
FMC_A19: U13.V10 (IO_L10P_T1_13); also elsewhere on the board
FMC_A20: U13.W10 (IO_L10N_T1_13); also elsewhere on the board
FMC_A21: U13.Y11 (IO_L11P_T1_SRCC_13); also elsewhere on the board
FMC_A22: U13.Y12 (IO_L11N_T1_SRCC_13); also elsewhere on the board
FMC_A23: U13.W12 (IO_L12N_T1_MRCC_13); also elsewhere on the board
FMC_A24: U13.V13 (IO_L13P_T2_MRCC_13); also elsewhere on the board
FMC_A25: U13.V14 (IO_L13N_T2_MRCC_13); also elsewhere on the board
FMC_CLK: U13.W11 (IO_L12P_T1_MRCC_13); also elsewhere on the board
FMC_D0: U13.T3 (IO_0_34); also elsewhere on the board
FMC_D1: U13.T1 (IO_L1P_T0_34); also elsewhere on the board
FMC_D2: U13.U1 (IO_L1N_T0_34); also elsewhere on the board
FMC_D3: U13.U2 (IO_L2P_T0_34); also elsewhere on the board
FMC_D4: U13.V2 (IO_L2N_T0_34); also elsewhere on the board
FMC_D5: U13.R3 (IO_L3P_T0_DQS_34); also elsewhere on the board
FMC_D6: U13.R2 (IO_L3N_T0_DQS_34); also elsewhere on the board
FMC_D7: U13.W2 (IO_L4P_T0_34); also elsewhere on the board
FMC_D8: U13.Y2 (IO_L4N_T0_34); also elsewhere on the board
FMC_D9: U13.W1 (IO_L5P_T0_34); also elsewhere on the board
FMC_D10: U13.Y1 (IO_L5N_T0_34); also elsewhere on the board
FMC_D11: U13.U3 (IO_L6P_T0_34); also elsewhere on the board
FMC_D12: U13.V3 (IO_L6N_T0_VREF_34); also elsewhere on the board
FMC_D13: U13.AA1 (IO_L7P_T1_34); also elsewhere on the board
FMC_D14: U13.AB1 (IO_L7N_T1_34); also elsewhere on the board
FMC_D15: U13.AB3 (IO_L8P_T1_34); also elsewhere on the board
FMC_D16: U13.AB2 (IO_L8N_T1_34); also elsewhere on the board
FMC_D17: U13.Y3 (IO_L9P_T1_DQS_34); also elsewhere on the board
FMC_D18: U13.AA3 (IO_L9N_T1_DQS_34); also elsewhere on the board
FMC_D19: U13.AA5 (IO_L10P_T1_34); also elsewhere on the board
FMC_D20: U13.AB5 (IO_L10N_T1_34); also elsewhere on the board
FMC_D21: U13.Y4 (IO_L11P_T1_SRCC_34); also elsewhere on the board
FMC_D22: U13.AA4 (IO_L11N_T1_SRCC_34); also elsewhere on the board
FMC_D23: U13.V4 (IO_L12P_T1_MRCC_34); also elsewhere on the board
FMC_D24: U13.W4 (IO_L12N_T1_MRCC_34); also elsewhere on the board
FMC_D25: U13.R4 (IO_L13P_T2_MRCC_34); also elsewhere on the board
FMC_D26: U13.T4 (IO_L13N_T2_MRCC_34); also elsewhere on the board
FMC_D27: U13.T5 (IO_L14P_T2_SRCC_34); also elsewhere on the board
FMC_D28: U13.U5 (IO_L14N_T2_SRCC_34); also elsewhere on the board
FMC_D29: U13.W6 (IO_L15P_T2_DQS_34); also elsewhere on the board
FMC_D30: U13.W5 (IO_L15N_T2_DQS_34); also elsewhere on the board
FMC_D31: U13.U6 (IO_L16P_T2_34); also elsewhere on the board
FMC_NE1: U13.V5 (IO_L16N_T2_34); also elsewhere on the board
FMC_NL: U13.R6 (IO_L17P_T2_34); also elsewhere on the board
FMC_NOE: U13.T6 (IO_L17N_T2_34); also elsewhere on the board
FMC_NWAIT: U13.Y6 (IO_L18P_T2_34); also elsewhere on the board
FMC_NWE: U13.AA6 (IO_L18N_T2_34); also elsewhere on the board
VCCO_3V3: U13.AA7 (VCCO_34), U13.AA17 (VCCO_13), U13.AB4 (VCCO_34), U13.AB14 (VCCO_13), U13.R5 (VCCO_34), U13.T2 (VCCO_34), U13.V6 (VCCO_34), U13.V16 (VCCO_13), U13.W3 (VCCO_34), U13.W13 (VCCO_13), U13.Y10 (VCCO_13); also elsewhere on the board

Notes on the sheet:
*) Bottom Bank
*) Lower Left Bank
<-- FMC_A[...] signals can be swapped
<-- FMC_CLK signal _MUST_ go into either W11 or V13 (i.e. into one of the two positive (master) sides of the two available MRCC differential pairs)
<-- FMC_D[...] signals can be swapped
<-- FMC_* control signals can be swapped
FPGA FMC interface

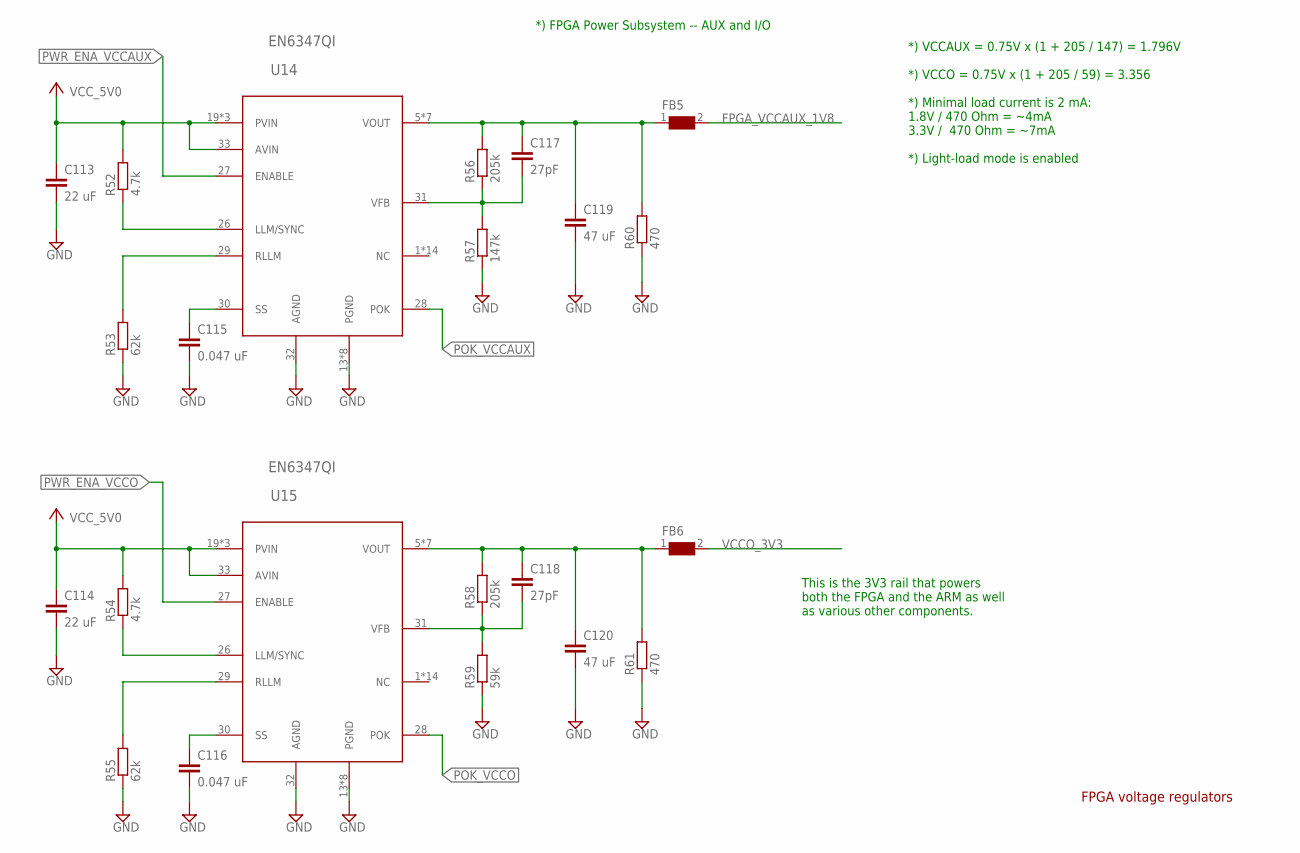
[picture p48: schematic rev02.sch, sheet 19, FPGA voltage regulators]

Parts:
C113, C114: 22 uF; C1210; TOLERANCE 20%
C115, C116: 0.047 uF; C0402; TOLERANCE 10%
C117, C118: 27pF; C0402; TOLERANCE 5%
C119, C120: 47 uF; C1210; TOLERANCE 20%
FB5, FB6: 0; 1206
R52, R54: 4.7k; R0402; TOLERANCE 5%
R53, R55: 62k; R0402; TOLERANCE 5%
R56, R58: 205k; R0402; TOLERANCE 1%
R57: 147k; R0402; TOLERANCE 1%
R59: 59k; R0402; TOLERANCE 1%
R60, R61: 470; R0402; TOLERANCE 5%
U14, U15: EN6347QI; QFN38_4X7X1.85

Connections:
FPGA_VCCAUX_1V8: FB5.2; also elsewhere on the board
GND: C113.2, C114.2, C115.2, C116.2, C119.2, C120.2, R53.1, R55.1, R57.1, R59.1, R60.1, R61.1, U14.13 (PGND), U14.14 (PGND), U14.15 (PGND), U14.16 (PGND), U14.17 (PGND), U14.18 (PGND), U14.32 (AGND), U14.P$39 (PGND), U14.P$40 (PGND), U15.13 (PGND), U15.14 (PGND), U15.15 (PGND), U15.16 (PGND), U15.17 (PGND), U15.18 (PGND), U15.32 (AGND), U15.P$39 (PGND), U15.P$40 (PGND); also elsewhere on the board
unnamed: C115.1, U14.30 (SS)
unnamed: R53.2, U14.29 (RLLM)
unnamed: R52.1, U14.26 (LLM/SYNC)
unnamed: C117.1, C119.1, FB5.1, R56.2, R60.2, U14.5 (VOUT), U14.6 (VOUT), U14.7 (VOUT), U14.8 (VOUT), U14.9 (VOUT), U14.10 (VOUT), U14.11 (VOUT)
unnamed: C117.2, R56.1, R57.2, U14.31 (VFB)
unnamed: C116.1, U15.30 (SS)
unnamed: R55.2, U15.29 (RLLM)
unnamed: R54.1, U15.26 (LLM/SYNC)
unnamed: C118.1, C120.1, FB6.1, R58.2, R61.2, U15.5 (VOUT), U15.6 (VOUT), U15.7 (VOUT), U15.8 (VOUT), U15.9 (VOUT), U15.10 (VOUT), U15.11 (VOUT)
unnamed: C118.2, R58.1, R59.2, U15.31 (VFB)
POK_VCCAUX: U14.28 (POK); also elsewhere on the board
POK_VCCO: U15.28 (POK); also elsewhere on the board
PWR_ENA_VCCAUX: U14.27 (ENABLE); also elsewhere on the board
PWR_ENA_VCCO: U15.27 (ENABLE); also elsewhere on the board
VCCO_3V3: FB6.2; also elsewhere on the board
VCC_5V0: C113.1, C114.1, R52.2, R54.2, U14.19 (PVIN), U14.20 (PVIN), U14.21 (PVIN), U14.33 (AVIN), U15.19 (PVIN), U15.20 (PVIN), U15.21 (PVIN), U15.33 (AVIN); also elsewhere on the board

Notes on the sheet:
*) FPGA Power Subsystem -- AUX and I/O
*) VCCAUX = 0.75V x (1 + 205 / 147) = 1.796V *) VCCO = 0.75V x (1 + 205 / 59) = 3.356 *) Minimal load current is 2 mA: 1.8V / 470 Ohm = ~4mA 3.3V / 470 Ohm = ~7mA *) Light-load mode is enabled
This is the 3V3 rail that powers both the FPGA and the ARM as well as various other components.
FPGA voltage regulators

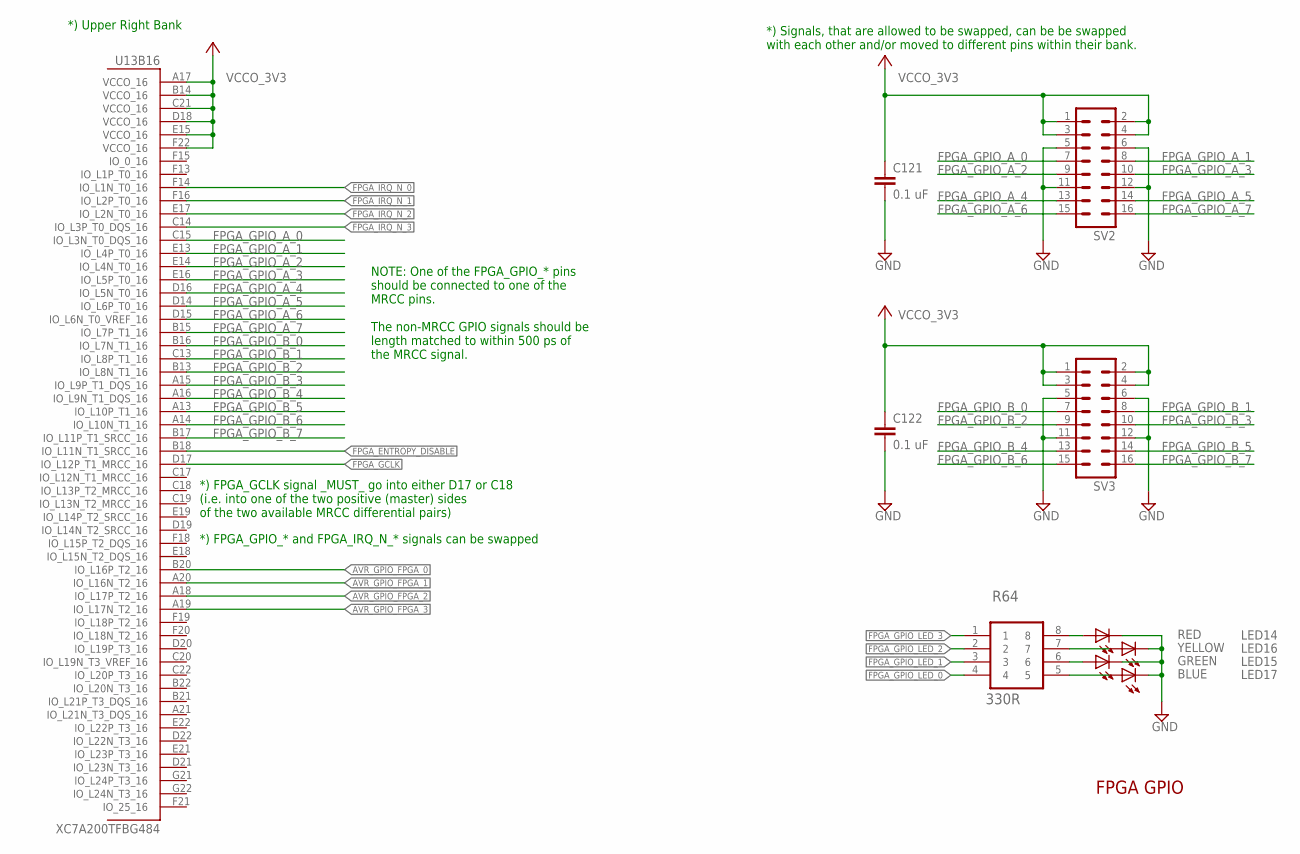
[picture p49: schematic rev02.sch, sheet 20, FPGA GPIO]

Parts:
C121, C122: 0.1 uF; C0402; TOLERANCE 10%
LED14: RED; CHIP-LED0603
LED15: GREEN; CHIP-LED0603
LED16: YELLOW; CHIP-LED0603
LED17: BLUE; CHIP-LED0603
R64: 330R; RESCAXE80P320X160X60-8N
SV2, SV3: MA08-2
U13: XC7A200TFBG484; FF484; MPN XC7A200T-1FBG484C

Connections:
FPGA_ENTROPY_DISABLE: U13.B18 (IO_L11N_T1_SRCC_16); also elsewhere on the board
FPGA_GCLK: U13.D17 (IO_L12P_T1_MRCC_16)
FPGA_GPIO_A_0: SV2.7, U13.C15 (IO_L3N_T0_DQS_16)
FPGA_GPIO_A_1: SV2.8, U13.E13 (IO_L4P_T0_16)
FPGA_GPIO_A_2: SV2.9, U13.E14 (IO_L4N_T0_16)
FPGA_GPIO_A_3: SV2.10, U13.E16 (IO_L5P_T0_16)
FPGA_GPIO_A_4: SV2.13, U13.D16 (IO_L5N_T0_16)
FPGA_GPIO_A_5: SV2.14, U13.D14 (IO_L6P_T0_16)
FPGA_GPIO_A_6: SV2.15, U13.D15 (IO_L6N_T0_VREF_16)
FPGA_GPIO_A_7: SV2.16, U13.B15 (IO_L7P_T1_16)
FPGA_GPIO_B_0: SV3.7, U13.B16 (IO_L7N_T1_16)
FPGA_GPIO_B_1: SV3.8, U13.C13 (IO_L8P_T1_16)
FPGA_GPIO_B_2: SV3.9, U13.B13 (IO_L8N_T1_16)
FPGA_GPIO_B_3: SV3.10, U13.A15 (IO_L9P_T1_DQS_16)
FPGA_GPIO_B_4: SV3.13, U13.A16 (IO_L9N_T1_DQS_16)
FPGA_GPIO_B_5: SV3.14, U13.A13 (IO_L10P_T1_16)
FPGA_GPIO_B_6: SV3.15, U13.A14 (IO_L10N_T1_16)
FPGA_GPIO_B_7: SV3.16, U13.B17 (IO_L11P_T1_SRCC_16)
FPGA_GPIO_LED_0: R64.4; also elsewhere on the board
FPGA_GPIO_LED_1: R64.3; also elsewhere on the board
FPGA_GPIO_LED_2: R64.2; also elsewhere on the board
FPGA_GPIO_LED_3: R64.1; also elsewhere on the board
FPGA_IRQ_N_0: U13.F14 (IO_L1N_T0_16); also elsewhere on the board
FPGA_IRQ_N_1: U13.F16 (IO_L2P_T0_16); also elsewhere on the board
FPGA_IRQ_N_2: U13.E17 (IO_L2N_T0_16); also elsewhere on the board
FPGA_IRQ_N_3: U13.C14 (IO_L3P_T0_DQS_16); also elsewhere on the board
GND: C121.2, C122.2, LED14.C, LED15.C, LED16.C, LED17.C, SV2.5, SV2.6, SV2.11, SV2.12, SV3.5, SV3.6, SV3.11, SV3.12; also elsewhere on the board
unnamed: LED17.A, R64.5
unnamed: LED15.A, R64.6
unnamed: LED16.A, R64.7
unnamed: LED14.A, R64.8
VCCO_3V3: C121.1, C122.1, SV2.1, SV2.2, SV2.3, SV2.4, SV3.1, SV3.2, SV3.3, SV3.4, U13.A17 (VCCO_16), U13.B14 (VCCO_16), U13.C21 (VCCO_16), U13.D18 (VCCO_16), U13.E15 (VCCO_16), U13.F22 (VCCO_16); also elsewhere on the board

Notes on the sheet:
*) Upper Right Bank
*) FPGA_GCLK signal _MUST_ go into either D17 or C18 (i.e. into one of the two positive (master) sides of the two available MRCC differential pairs)
*) FPGA_GPIO_* and FPGA_IRQ_N_* signals can be swapped
*) Signals, that are allowed to be swapped, can be be swapped with each other and/or moved to different pins within their bank.
NOTE: One of the FPGA_GPIO_* pins should be connected to one of the MRCC pins. The non-MRCC GPIO signals should be length matched to within 500 ps of the MRCC signal.
FPGA GPIO
