vgisc/cryptech.hardware/cad/rev02/alpha/rev02/rev02.brd

## EAGLE design cad/rev02/alpha/rev02/rev02.brd (continued)

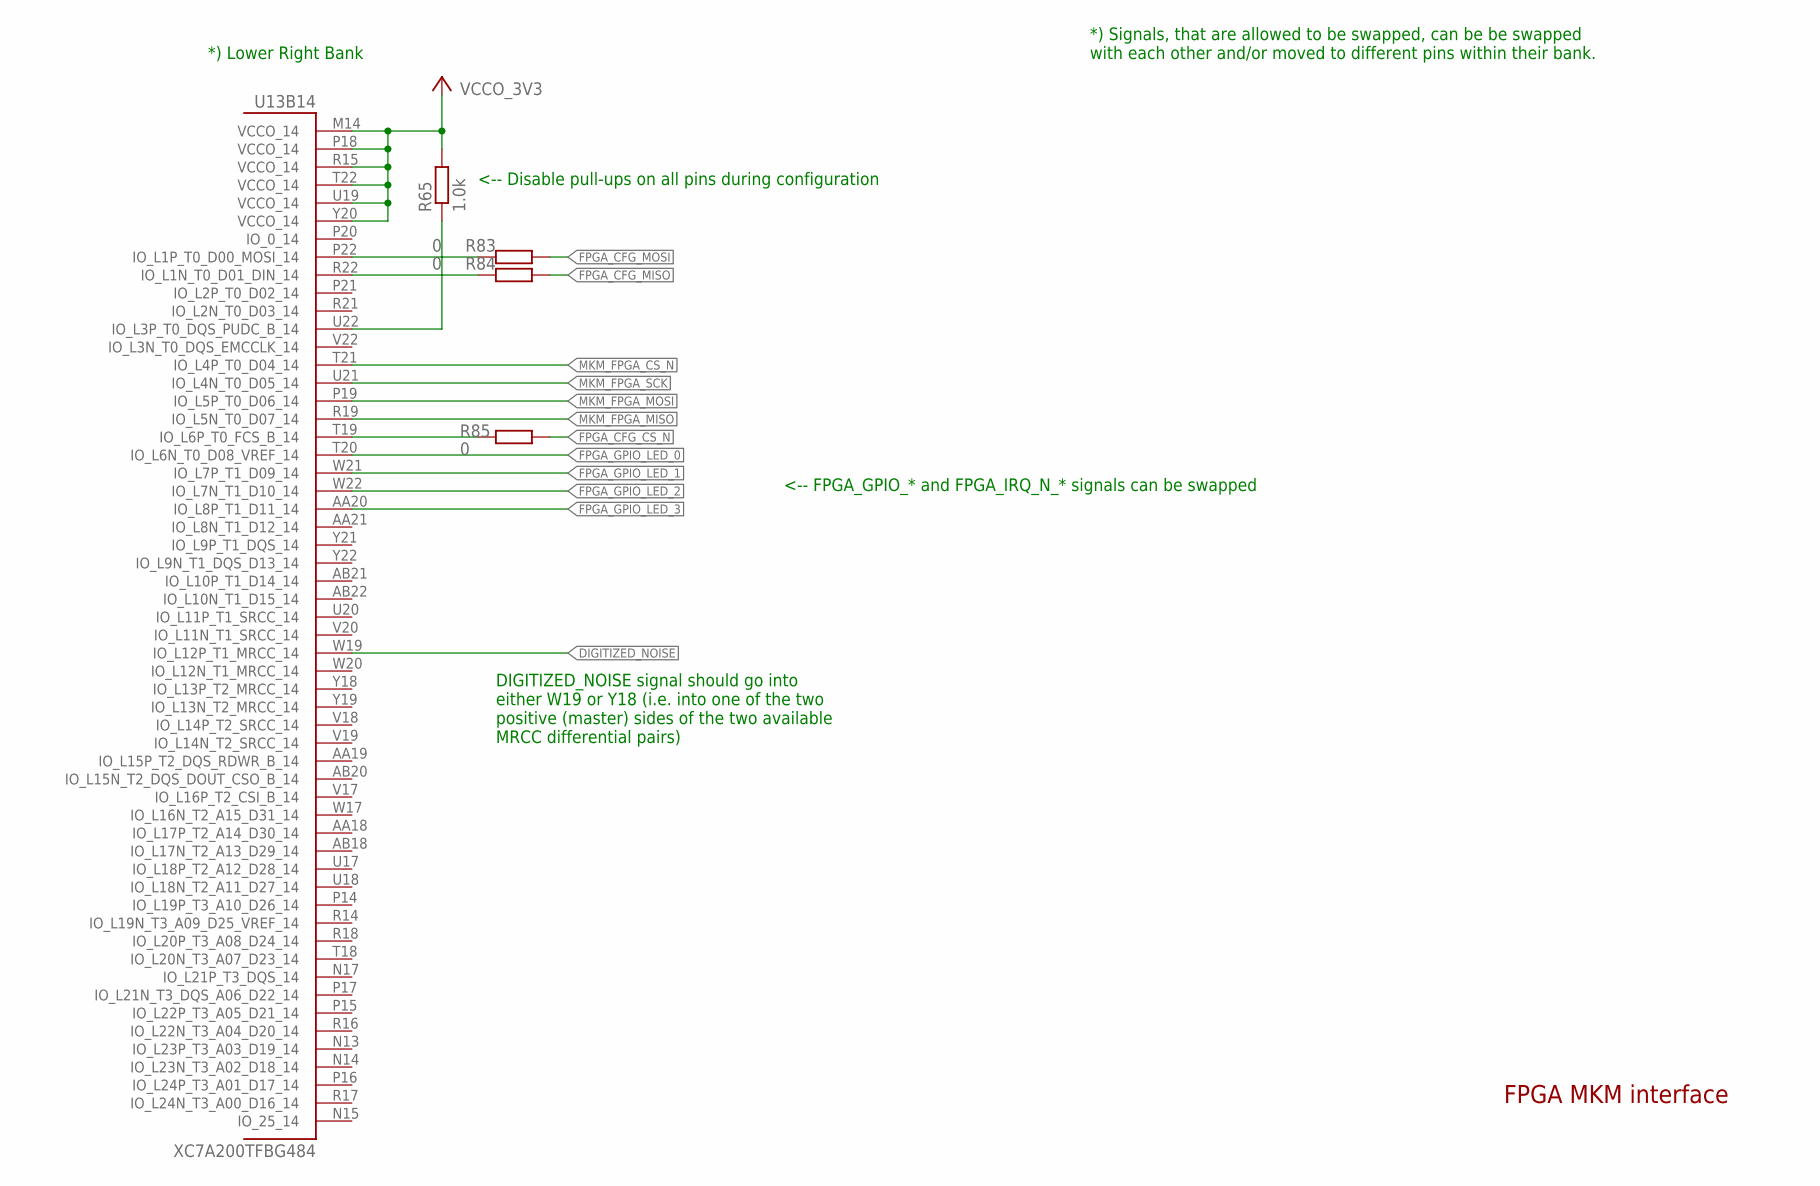
[picture p50: schematic rev02.sch, sheet 21, FPGA MKM interface]

Parts:
R65: 1.0k; R0402; TOLERANCE 5%
R83, R84, R85: 0; R0603; TOLERANCE 5%
U13: XC7A200TFBG484; FF484; MPN XC7A200T-1FBG484C

Connections:
DIGITIZED_NOISE: U13.W19 (IO_L12P_T1_MRCC_14); also elsewhere on the board
FPGA_CFG_CS_N: R85.1; also elsewhere on the board
FPGA_CFG_CS_N1: R85.2, U13.T19 (IO_L6P_T0_FCS_B_14)
FPGA_CFG_MISO: R84.1; also elsewhere on the board
FPGA_CFG_MISO1: R84.2, U13.R22 (IO_L1N_T0_D01_DIN_14)
FPGA_CFG_MOSI: R83.1; also elsewhere on the board
FPGA_CFG_MOSI1: R83.2, U13.P22 (IO_L1P_T0_D00_MOSI_14)
FPGA_GPIO_LED_0: U13.T20 (IO_L6N_T0_D08_VREF_14); also elsewhere on the board
FPGA_GPIO_LED_1: U13.W21 (IO_L7P_T1_D09_14); also elsewhere on the board
FPGA_GPIO_LED_2: U13.W22 (IO_L7N_T1_D10_14); also elsewhere on the board
FPGA_GPIO_LED_3: U13.AA20 (IO_L8P_T1_D11_14); also elsewhere on the board
MKM_FPGA_CS_N: U13.T21 (IO_L4P_T0_D04_14); also elsewhere on the board
MKM_FPGA_MISO: U13.R19 (IO_L5N_T0_D07_14); also elsewhere on the board
MKM_FPGA_MOSI: U13.P19 (IO_L5P_T0_D06_14); also elsewhere on the board
MKM_FPGA_SCK: U13.U21 (IO_L4N_T0_D05_14); also elsewhere on the board
unnamed: R65.1, U13.U22 (IO_L3P_T0_DQS_PUDC_B_14)
VCCO_3V3: R65.2, U13.M14 (VCCO_14), U13.P18 (VCCO_14), U13.R15 (VCCO_14), U13.T22 (VCCO_14), U13.U19 (VCCO_14), U13.Y20 (VCCO_14); also elsewhere on the board

Notes on the sheet:
*) Lower Right Bank
DIGITIZED_NOISE signal should go into either W19 or Y18 (i.e. into one of the two positive (master) sides of the two available MRCC differential pairs)
*) Signals, that are allowed to be swapped, can be be swapped with each other and/or moved to different pins within their bank.
<-- FPGA_GPIO_* and FPGA_IRQ_N_* signals can be swapped
<-- Disable pull-ups on all pins during configuration
FPGA MKM interface

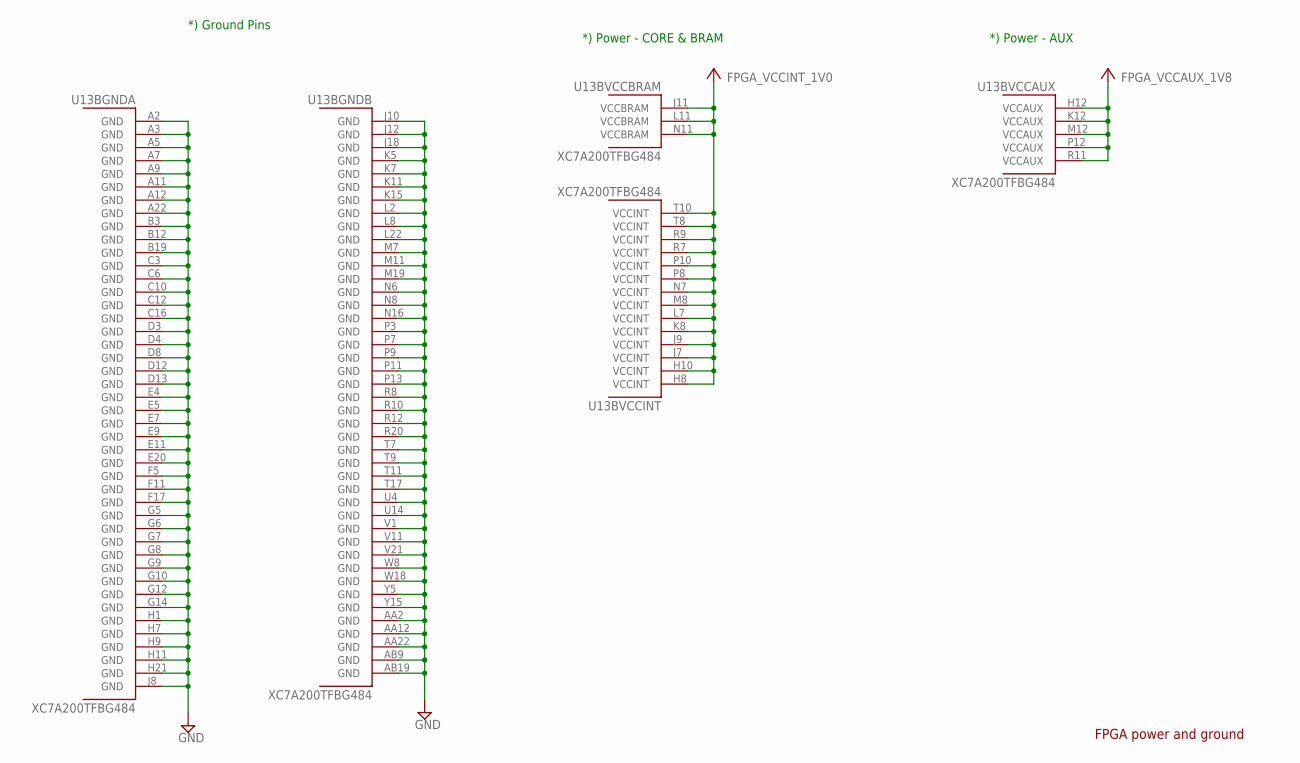
[picture p51: schematic rev02.sch, sheet 22, FPGA power and ground]

Parts:
U13: XC7A200TFBG484; FF484; MPN XC7A200T-1FBG484C

Connections:
FPGA_VCCAUX_1V8: U13.H12 (VCCAUX), U13.K12 (VCCAUX), U13.M12 (VCCAUX), U13.P12 (VCCAUX), U13.R11 (VCCAUX); also elsewhere on the board
FPGA_VCCINT_1V0: U13.H8 (VCCINT), U13.H10 (VCCINT), U13.J7 (VCCINT), U13.J9 (VCCINT), U13.J11 (VCCBRAM), U13.K8 (VCCINT), U13.L7 (VCCINT), U13.L11 (VCCBRAM), U13.M8 (VCCINT), U13.N7 (VCCINT), U13.N11 (VCCBRAM), U13.P8 (VCCINT), U13.P10 (VCCINT), U13.R7 (VCCINT), U13.R9 (VCCINT), U13.T8 (VCCINT), U13.T10 (VCCINT); also elsewhere on the board
GND: U13.A2 (GND), U13.A3 (GND), U13.A5 (GND), U13.A7 (GND), U13.A9 (GND), U13.A11 (GND), U13.A12 (GND), U13.A22 (GND), U13.AA2 (GND), U13.AA12 (GND), U13.AA22 (GND), U13.AB9 (GND), U13.AB19 (GND), U13.B3 (GND), U13.B12 (GND), U13.B19 (GND), U13.C3 (GND), U13.C6 (GND), U13.C10 (GND), U13.C12 (GND), U13.C16 (GND), U13.D3 (GND), U13.D4 (GND), U13.D8 (GND), U13.D12 (GND), U13.D13 (GND), U13.E4 (GND), U13.E5 (GND), U13.E7 (GND), U13.E9 (GND), U13.E11 (GND), U13.E20 (GND), U13.F5 (GND), U13.F11 (GND), U13.F17 (GND), U13.G5 (GND), U13.G6 (GND), U13.G7 (GND), U13.G8 (GND), U13.G9 (GND), U13.G10 (GND), U13.G12 (GND), U13.G14 (GND), U13.H1 (GND), U13.H7 (GND), U13.H9 (GND), U13.H11 (GND), U13.H21 (GND), U13.J8 (GND), U13.J10 (GND), U13.J12 (GND), U13.J18 (GND), U13.K5 (GND), U13.K7 (GND), U13.K11 (GND), U13.K15 (GND), U13.L2 (GND), U13.L8 (GND), U13.L22 (GND), U13.M7 (GND), U13.M11 (GND), U13.M19 (GND), U13.N6 (GND), U13.N8 (GND), U13.N16 (GND), U13.P3 (GND), U13.P7 (GND), U13.P9 (GND), U13.P11 (GND), U13.P13 (GND), U13.R8 (GND), U13.R10 (GND), U13.R12 (GND), U13.R20 (GND), U13.T7 (GND), U13.T9 (GND), U13.T11 (GND), U13.T17 (GND), U13.U4 (GND), U13.U14 (GND), U13.V1 (GND), U13.V11 (GND), U13.V21 (GND), U13.W8 (GND), U13.W18 (GND), U13.Y5 (GND), U13.Y15 (GND); also elsewhere on the board

Notes on the sheet:
*) Power - AUX
*) Power - CORE & BRAM
*) Ground Pins
FPGA power and ground

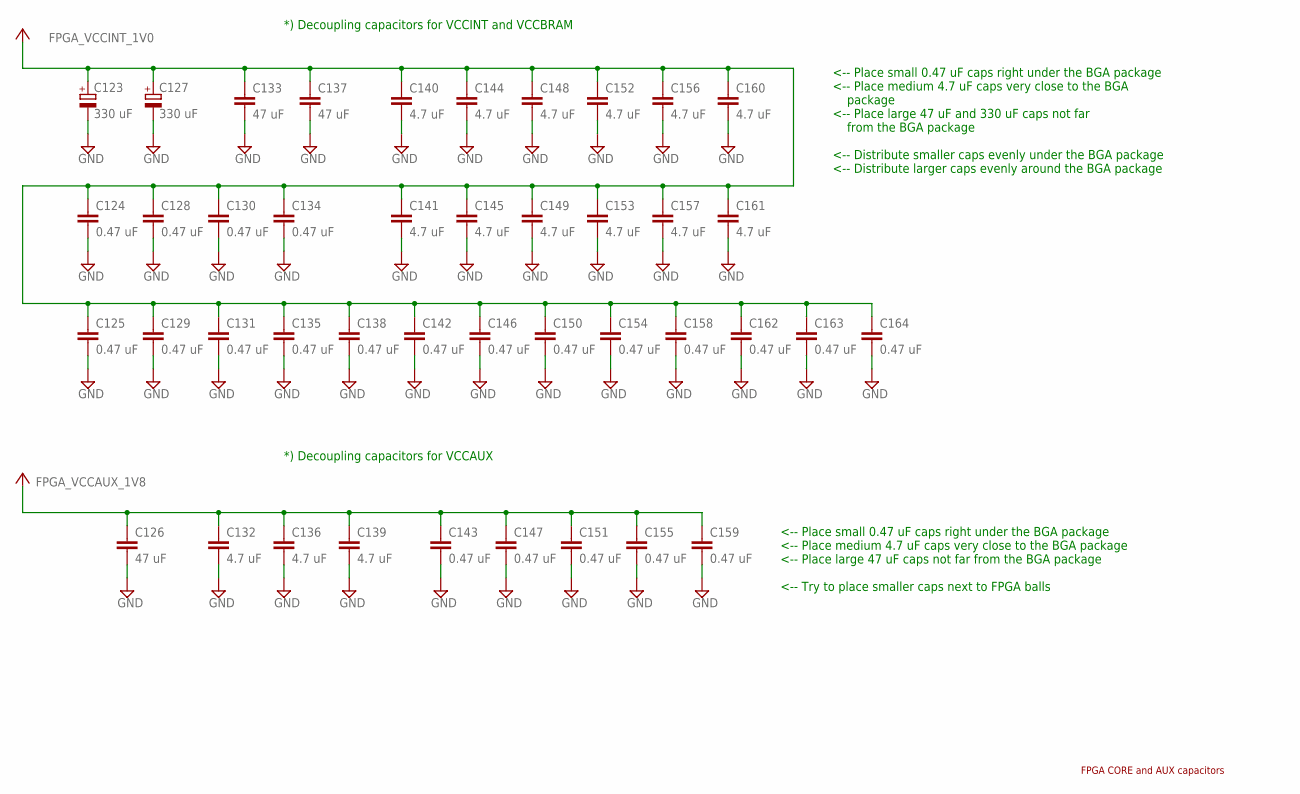
[picture p52: schematic rev02.sch, sheet 23, FPGA CORE and AUX capacitors]

Parts:
C123, C127: 330 uF; SMC_D; TOLERANCE 10%
C124, C125, C128, C129, C130, C131, C134, C135, C138, C142, C143, C146, C147, C150, C151, C154, C155, C158, C159, C162, C163, C164: 0.47 uF; C0402; TOLERANCE 10%
C126, C133, C137: 47 uF; C1210; TOLERANCE 20%
C132, C136, C139, C140, C141, C144, C145, C148, C149, C152, C153, C156, C157, C160, C161: 4.7 uF; C0603; TOLERANCE 10%

Connections:
FPGA_VCCAUX_1V8: C126.1, C132.1, C136.1, C139.1, C143.1, C147.1, C151.1, C155.1, C159.1; also elsewhere on the board
FPGA_VCCINT_1V0: C123.+, C124.1, C125.1, C127.+, C128.1, C129.1, C130.1, C131.1, C133.1, C134.1, C135.1, C137.1, C138.1, C140.1, C141.1, C142.1, C144.1, C145.1, C146.1, C148.1, C149.1, C150.1, C152.1, C153.1, C154.1, C156.1, C157.1, C158.1, C160.1, C161.1, C162.1, C163.1, C164.1; also elsewhere on the board
GND: C123.-, C124.2, C125.2, C126.2, C127.-, C128.2, C129.2, C130.2, C131.2, C132.2, C133.2, C134.2, C135.2, C136.2, C137.2, C138.2, C139.2, C140.2, C141.2, C142.2, C143.2, C144.2, C145.2, C146.2, C147.2, C148.2, C149.2, C150.2, C151.2, C152.2, C153.2, C154.2, C155.2, C156.2, C157.2, C158.2, C159.2, C160.2, C161.2, C162.2, C163.2, C164.2; also elsewhere on the board

Notes on the sheet:
<-- Place small 0.47 uF caps right under the BGA package <-- Place medium 4.7 uF caps very close to the BGA package <-- Place large 47 uF and 330 uF caps not far from the BGA package <-- Distribute smaller caps evenly under the BGA package <-- Distribute larger caps evenly around the BGA package
*) Decoupling capacitors for VCCINT and VCCBRAM
<-- Place small 0.47 uF caps right under the BGA package <-- Place medium 4.7 uF caps very close to the BGA package <-- Place large 47 uF caps not far from the BGA package <-- Try to place smaller caps next to FPGA balls
*) Decoupling capacitors for VCCAUX
FPGA CORE and AUX capacitors

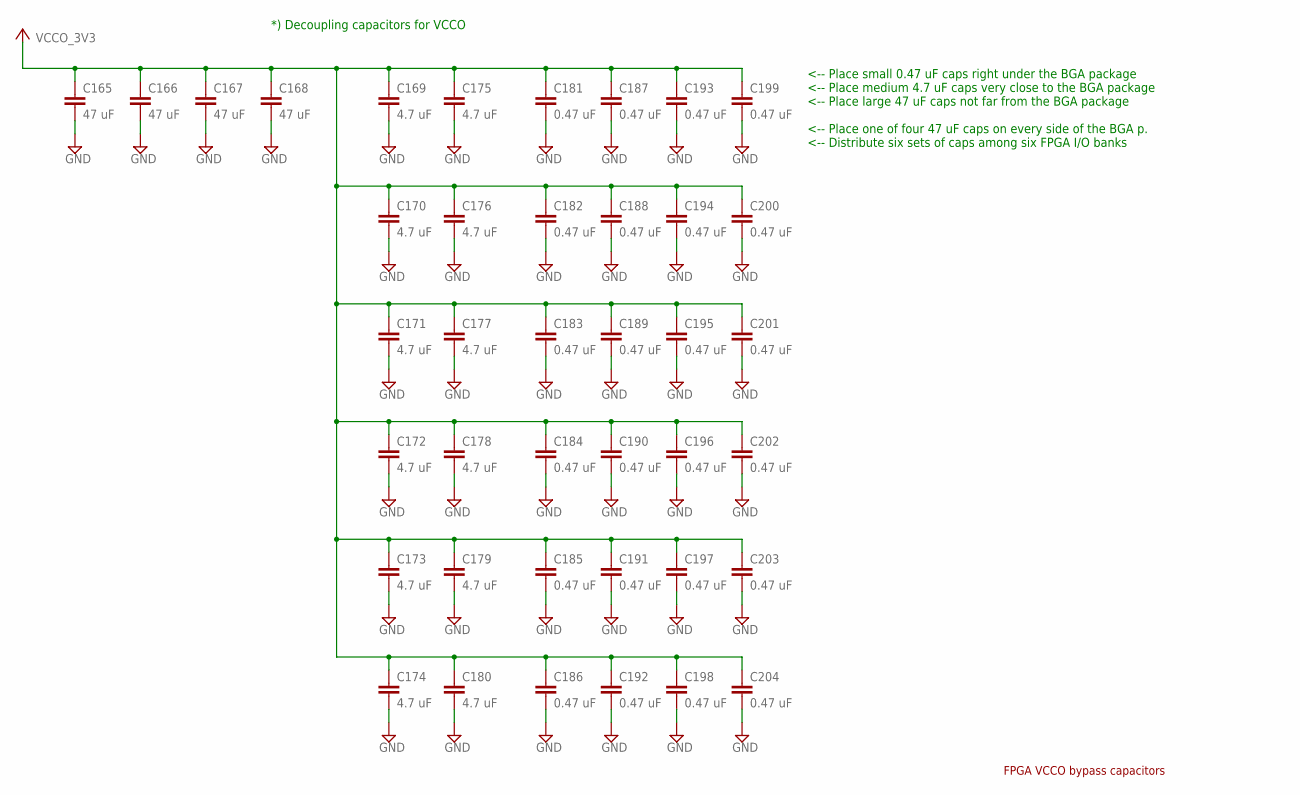
[picture p53: schematic rev02.sch, sheet 24, FPGA VCCO bypass capacitors]

Parts:
C165, C166, C167, C168: 47 uF; C1210; TOLERANCE 20%
C169, C170, C171, C172, C173, C174, C175, C176, C177, C178, C179, C180: 4.7 uF; C0603; TOLERANCE 10%
C181, C182, C183, C184, C185, C186, C187, C188, C189, C190, C191, C192, C193, C194, C195, C196, C197, C198, C199, C200, C201, C202, C203, C204: 0.47 uF; C0402; TOLERANCE 10%

Connections:
GND: C165.2, C166.2, C167.2, C168.2, C169.2, C170.2, C171.2, C172.2, C173.2, C174.2, C175.2, C176.2, C177.2, C178.2, C179.2, C180.2, C181.2, C182.2, C183.2, C184.2, C185.2, C186.2, C187.2, C188.2, C189.2, C190.2, C191.2, C192.2, C193.2, C194.2, C195.2, C196.2, C197.2, C198.2, C199.2, C200.2, C201.2, C202.2, C203.2, C204.2; also elsewhere on the board
VCCO_3V3: C165.1, C166.1, C167.1, C168.1, C169.1, C170.1, C171.1, C172.1, C173.1, C174.1, C175.1, C176.1, C177.1, C178.1, C179.1, C180.1, C181.1, C182.1, C183.1, C184.1, C185.1, C186.1, C187.1, C188.1, C189.1, C190.1, C191.1, C192.1, C193.1, C194.1, C195.1, C196.1, C197.1, C198.1, C199.1, C200.1, C201.1, C202.1, C203.1, C204.1; also elsewhere on the board

Notes on the sheet:
<-- Place small 0.47 uF caps right under the BGA package <-- Place medium 4.7 uF caps very close to the BGA package <-- Place large 47 uF caps not far from the BGA package <-- Place one of four 47 uF caps on every side of the BGA p. <-- Distribute six sets of caps among six FPGA I/O banks
*) Decoupling capacitors for VCCO
FPGA VCCO bypass capacitors

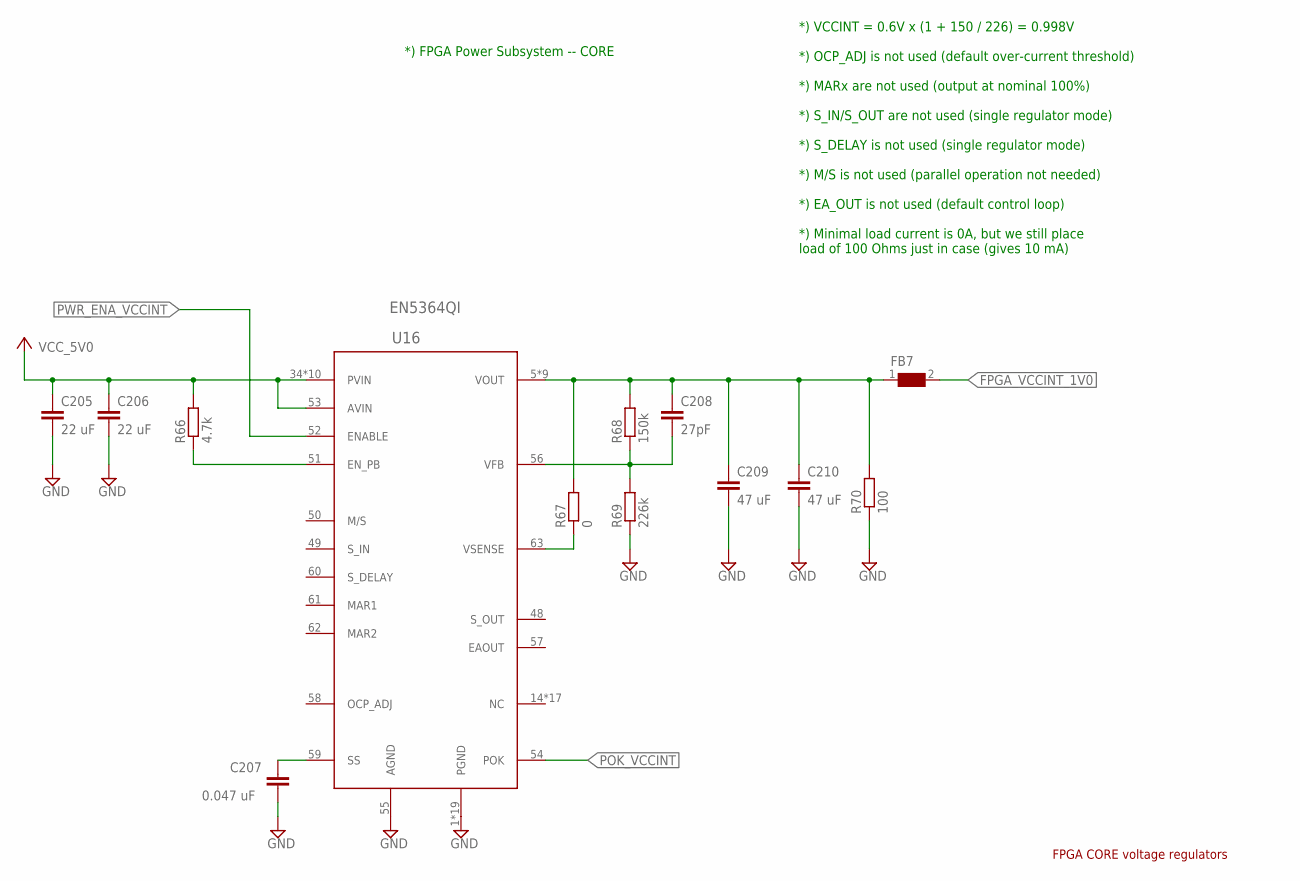
[picture p54: schematic rev02.sch, sheet 25, FPGA CORE voltage regulator]

Parts:
C205, C206: 22 uF; C1210; TOLERANCE 20%
C207: 0.047 uF; C0402; TOLERANCE 10%
C208: 27pF; C0402; TOLERANCE 5%
C209, C210: 47 uF; C1210; TOLERANCE 20%
FB7: 0; 1206
R66: 4.7k; R0402; TOLERANCE 5%
R67: 0; R0402
R68: 150k; R0402; TOLERANCE 1%
R69: 226k; R0402; TOLERANCE 1%
R70: 100; R0402; TOLERANCE 5%
U16: EN5364QI; QFN68_8X11X1.85

Connections:
FPGA_VCCINT_1V0: FB7.2; also elsewhere on the board
GND: C205.2, C206.2, C207.2, C209.2, C210.2, R69.1, R70.1, U16.1 (PGND), U16.2 (PGND), U16.3 (PGND), U16.4 (PGND), U16.27 (PGND), U16.28 (PGND), U16.29 (PGND), U16.30 (PGND), U16.31 (PGND), U16.32 (PGND), U16.33 (PGND), U16.55 (AGND), U16.64 (PGND), U16.65 (PGND), U16.66 (PGND), U16.67 (PGND), U16.68 (PGND), U16.P$69 (PGND), U16.P$70 (PGND), U16.P$71 (PGND); also elsewhere on the board
unnamed: C207.1, U16.59 (SS)
unnamed: R66.1, U16.51 (EN_PB)
unnamed: R67.1, U16.63 (VSENSE)
unnamed: C208.1, C209.1, C210.1, FB7.1, R67.2, R68.2, R70.2, U16.5 (VOUT), U16.6 (VOUT), U16.7 (VOUT), U16.8 (VOUT), U16.9 (VOUT), U16.10 (VOUT), U16.11 (VOUT), U16.12 (VOUT), U16.13 (VOUT)
unnamed: C208.2, R68.1, R69.2, U16.56 (VFB)
POK_VCCINT: U16.54 (POK); also elsewhere on the board
PWR_ENA_VCCINT: U16.52 (ENABLE); also elsewhere on the board
VCC_5V0: C205.1, C206.1, R66.2, U16.34 (PVIN), U16.35 (PVIN), U16.36 (PVIN), U16.37 (PVIN), U16.38 (PVIN), U16.39 (PVIN), U16.40 (PVIN), U16.41 (PVIN), U16.42 (PVIN), U16.43 (PVIN), U16.53 (AVIN); also elsewhere on the board

Notes on the sheet:
*) FPGA Power Subsystem -- CORE
*) VCCINT = 0.6V x (1 + 150 / 226) = 0.998V *) OCP_ADJ is not used (default over-current threshold) *) MARx are not used (output at nominal 100%) *) S_IN/S_OUT are not used (single regulator mode) *) S_DELAY is not used (single regulator mode) *) M/S is not used (parallel operation not needed) *) E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
FPGA CORE voltage regulators

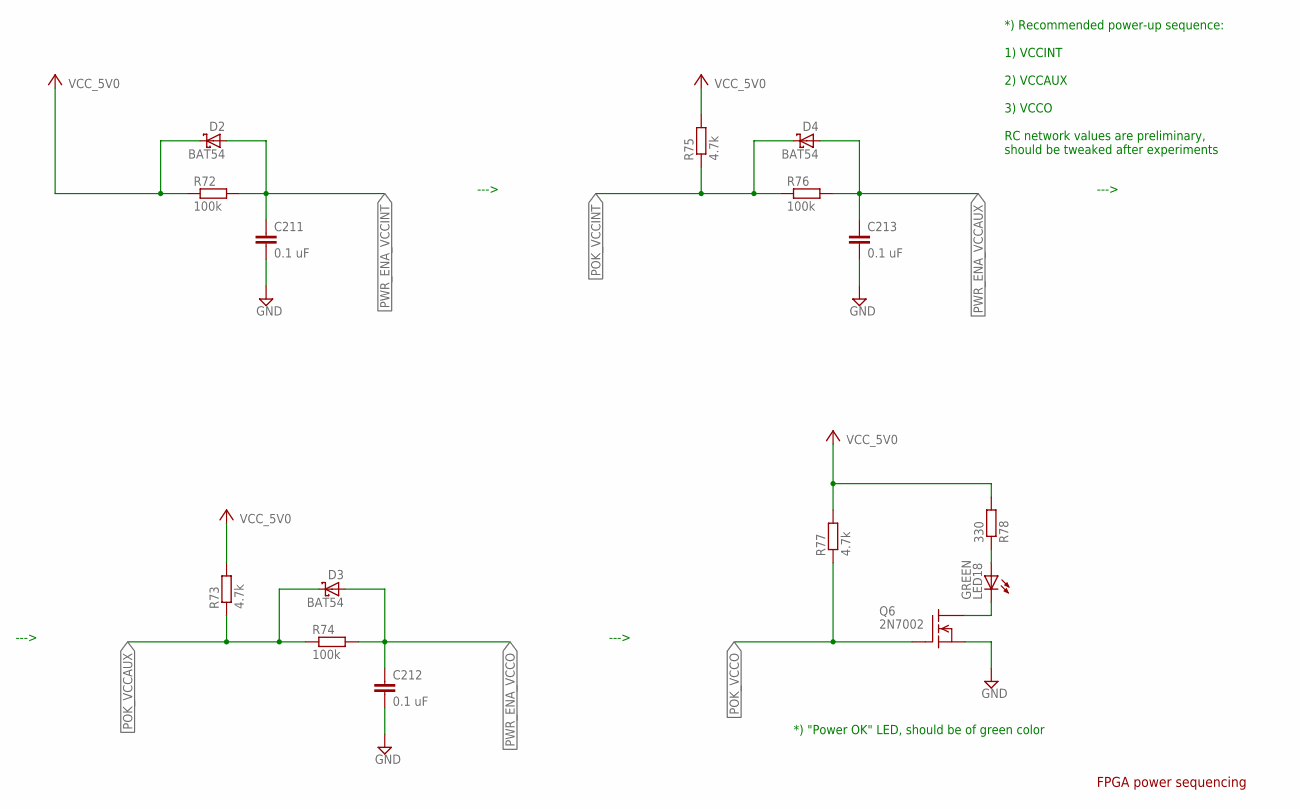
[picture p55: schematic rev02.sch, sheet 26, FPGA power sequencing]

Parts:
C211, C212, C213: 0.1 uF; C0402; TOLERANCE 10%
D2, D3, D4: BAT54; SOT23
LED18: GREEN; CHIP-LED0603
Q6: 2N7002; SOT23
R72, R74, R76: 100k; R0402; TOLERANCE 1%
R73, R75, R77: 4.7k; R0402; TOLERANCE 5%
R78: 330; R0402; TOLERANCE 5%

Connections:
GND: C211.2, C212.2, C213.2, Q6.2 (S); also elsewhere on the board
unnamed: LED18.C, Q6.3 (D)
unnamed: LED18.A, R78.1
POK_VCCAUX: D3.3 (C), R73.1, R74.1; also elsewhere on the board
POK_VCCINT: D4.3 (C), R75.1, R76.1; also elsewhere on the board
POK_VCCO: Q6.1 (G), R77.1; also elsewhere on the board
PWR_ENA_VCCAUX: C213.1, D4.1 (A), R76.2; also elsewhere on the board
PWR_ENA_VCCINT: C211.1, D2.1 (A), R72.2; also elsewhere on the board
PWR_ENA_VCCO: C212.1, D3.1 (A), R74.2; also elsewhere on the board
VCC_5V0: D2.3 (C), R72.1, R73.2, R75.2, R77.2, R78.2; also elsewhere on the board

Notes on the sheet:
*) Recommended power-up sequence: 1) VCCINT 2) VCCAUX 3) VCCO RC network values are preliminary, should be tweaked after experiments
--->
*) "Power OK" LED, should be of green color
FPGA power sequencing

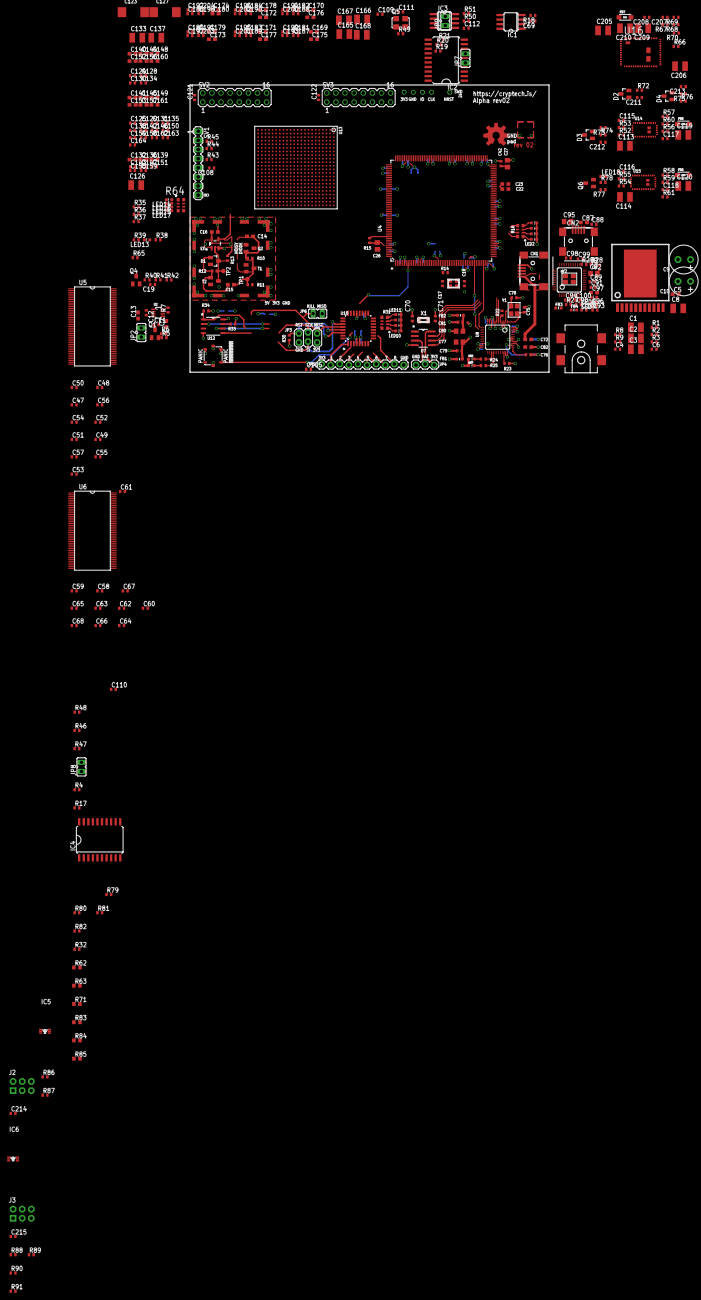
[picture p56: board rev02.brd from above]

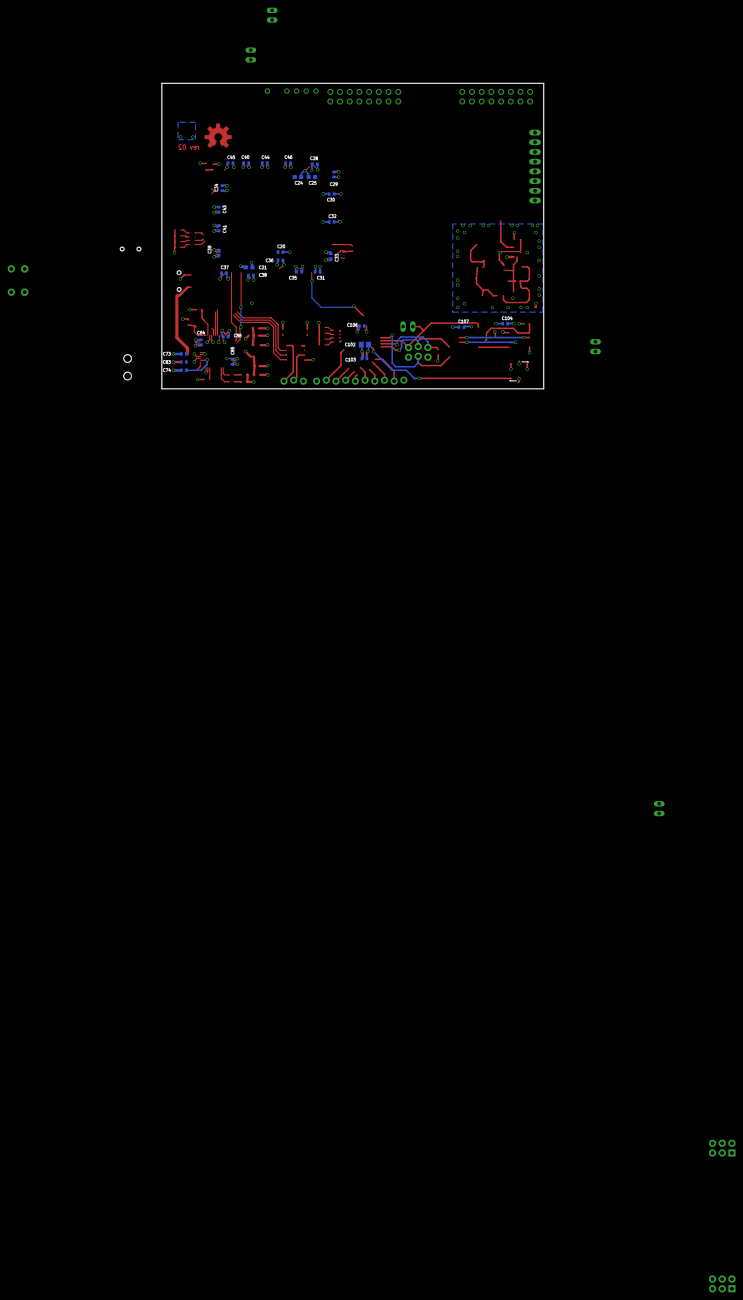
[picture p57: board rev02.brd from below]

Board: 4 copper layers, 100.0 x 80.0 mm, 389 parts (33 on the bottom side), 304 nets.
