vgisc/cryptech.hardware/cad/rev01/rev01.brd

## EAGLE design cad/rev01/rev01.brd (2015-12-01, an earlier design)

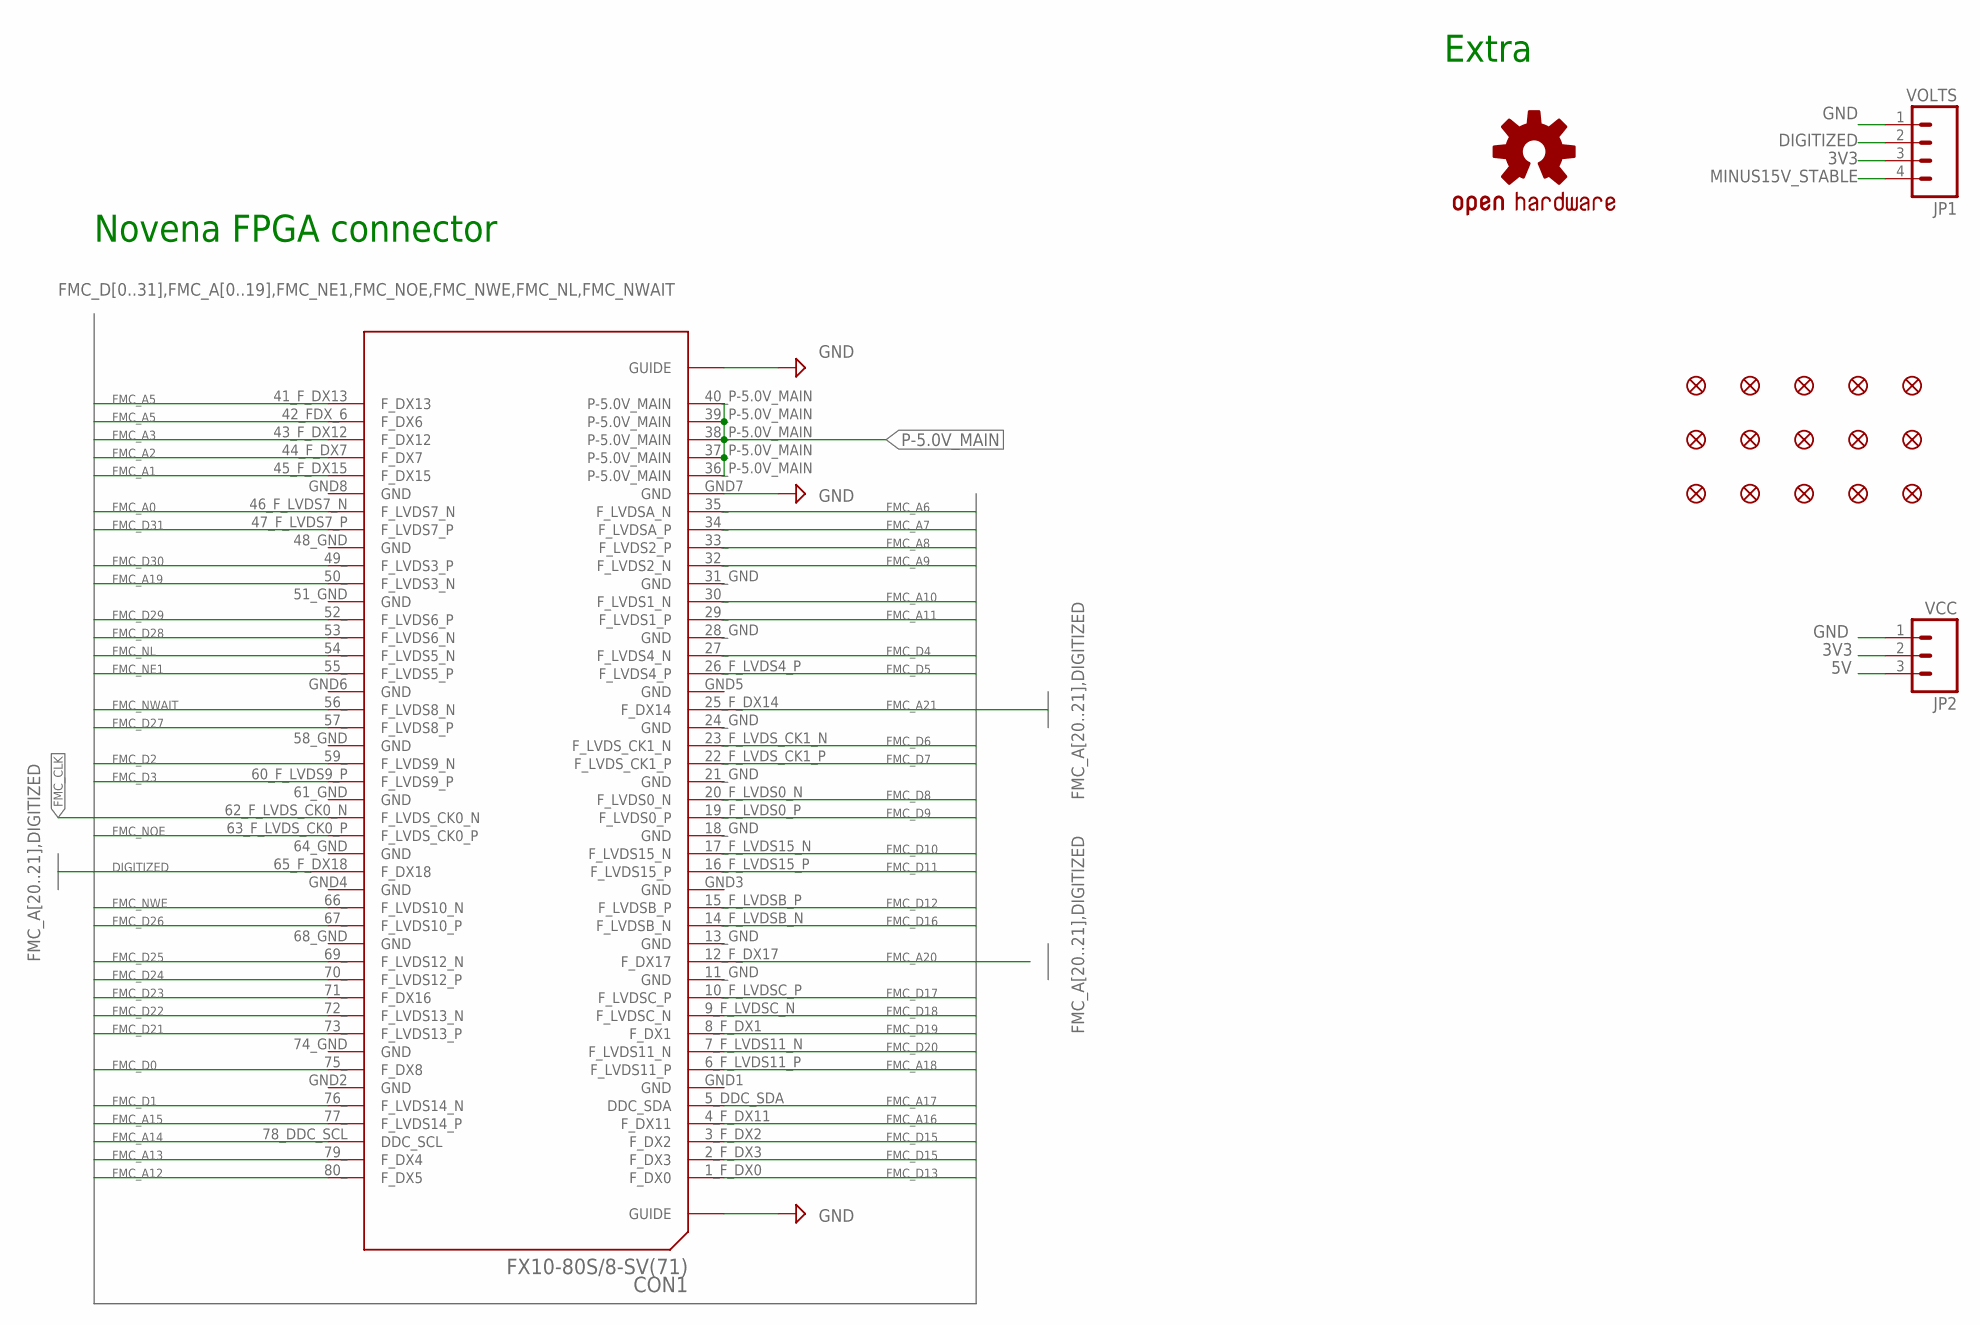
[picture p58: schematic rev01.sch, sheet 1, CrypTech avalanche noise evaluation board, rev 02]

Parts:
CON1: FX10-80S/8-SV(71); FX10A-80P/8-SV(71)
FID1, FID2, FID3, FID4, FID5, FID6, FID7, FID8, FID9, FID10, FID11, FID12, FID13, FID14, FID15: FIDUCIAL1X2; FIDUCIAL-1X2
JP1: VOLTS; 1X04_LOCK
JP2: VCC; 1X03_LOCK
LOGO1: OSHW-LOGOL-COPPER; OSHW-LOGO-L_COPPER

Connections:
3V3: JP1.3, JP2.2; also elsewhere on the board
5V: JP2.3; also elsewhere on the board
DIGITIZED: CON1.65_F_DX18 (F_DX18), JP1.2; also elsewhere on the board
FMC_A0: CON1.46_F_LVDS7_N (F_LVDS7_N); also elsewhere on the board
FMC_A1: CON1.45_F_DX15 (F_DX15); also elsewhere on the board
FMC_A2: CON1.44_F_DX7 (F_DX7); also elsewhere on the board
FMC_A3: CON1.43_F_DX12 (F_DX12); also elsewhere on the board
FMC_A4: CON1.42_FDX_6 (F_DX6); also elsewhere on the board
FMC_A5: CON1.41_F_DX13 (F_DX13); also elsewhere on the board
FMC_A6: CON1.35_ (F_LVDSA_N); also elsewhere on the board
FMC_A7: CON1.34_ (F_LVDSA_P); also elsewhere on the board
FMC_A8: CON1.33_ (F_LVDS2_P); also elsewhere on the board
FMC_A9: CON1.32_ (F_LVDS2_N); also elsewhere on the board
FMC_A10: CON1.30_ (F_LVDS1_N); also elsewhere on the board
FMC_A11: CON1.29_ (F_LVDS1_P); also elsewhere on the board
FMC_A12: CON1.80_ (F_DX5); also elsewhere on the board
FMC_A13: CON1.79_ (F_DX4); also elsewhere on the board
FMC_A14: CON1.78_DDC_SCL (DDC_SCL); also elsewhere on the board
FMC_A15: CON1.77_ (F_LVDS14_P); also elsewhere on the board
FMC_A16: CON1.4_F_DX11 (F_DX11); also elsewhere on the board
FMC_A17: CON1.5_DDC_SDA (DDC_SDA); also elsewhere on the board
FMC_A18: CON1.6_F_LVDS11_P (F_LVDS11_P); also elsewhere on the board
FMC_A19: CON1.50_ (F_LVDS3_N); also elsewhere on the board
FMC_A20: CON1.12_F_DX17 (F_DX17); also elsewhere on the board
FMC_A21: CON1.25_F_DX14 (F_DX14); also elsewhere on the board
FMC_CLK: CON1.62_F_LVDS_CK0_N (F_LVDS_CK0_N); also elsewhere on the board
FMC_D0: CON1.75_ (F_DX8); also elsewhere on the board
FMC_D1: CON1.76_ (F_LVDS14_N); also elsewhere on the board
FMC_D2: CON1.59_ (F_LVDS9_N); also elsewhere on the board
FMC_D3: CON1.60_F_LVDS9_P (F_LVDS9_P); also elsewhere on the board
FMC_D4: CON1.27_ (F_LVDS4_N); also elsewhere on the board
FMC_D5: CON1.26_F_LVDS4_P (F_LVDS4_P); also elsewhere on the board
FMC_D6: CON1.23_F_LVDS_CK1_N (F_LVDS_CK1_N); also elsewhere on the board
FMC_D7: CON1.22_F_LVDS_CK1_P (F_LVDS_CK1_P); also elsewhere on the board
FMC_D8: CON1.20_F_LVDS0_N (F_LVDS0_N); also elsewhere on the board
FMC_D9: CON1.19_F_LVDS0_P (F_LVDS0_P); also elsewhere on the board
FMC_D10: CON1.17_F_LVDS15_N (F_LVDS15_N); also elsewhere on the board
FMC_D11: CON1.16_F_LVDS15_P (F_LVDS15_P); also elsewhere on the board
FMC_D12: CON1.15_F_LVDSB_P (F_LVDSB_P); also elsewhere on the board
FMC_D13: CON1.1_F_DX0 (F_DX0); also elsewhere on the board
FMC_D14: CON1.2_F_DX3 (F_DX3); also elsewhere on the board
FMC_D15: CON1.3_F_DX2 (F_DX2); also elsewhere on the board
FMC_D16: CON1.14_F_LVDSB_N (F_LVDSB_N); also elsewhere on the board
FMC_D17: CON1.10_F_LVDSC_P (F_LVDSC_P); also elsewhere on the board
FMC_D18: CON1.9_F_LVDSC_N (F_LVDSC_N); also elsewhere on the board
FMC_D19: CON1.8_F_DX1 (F_DX1); also elsewhere on the board
FMC_D20: CON1.7_F_LVDS11_N (F_LVDS11_N); also elsewhere on the board
FMC_D21: CON1.73_ (F_LVDS13_P); also elsewhere on the board
FMC_D22: CON1.72_ (F_LVDS13_N); also elsewhere on the board
FMC_D23: CON1.71_ (F_DX16); also elsewhere on the board
FMC_D24: CON1.70_ (F_LVDS12_P); also elsewhere on the board
FMC_D25: CON1.69_ (F_LVDS12_N); also elsewhere on the board
FMC_D26: CON1.67_ (F_LVDS10_P); also elsewhere on the board
FMC_D27: CON1.57_ (F_LVDS8_P); also elsewhere on the board
FMC_D28: CON1.53_ (F_LVDS6_N); also elsewhere on the board
FMC_D29: CON1.52_ (F_LVDS6_P); also elsewhere on the board
FMC_D30: CON1.49_ (F_LVDS3_P); also elsewhere on the board
FMC_D31: CON1.47_F_LVDS7_P (F_LVDS7_P); also elsewhere on the board
FMC_NE1: CON1.55_ (F_LVDS5_P); also elsewhere on the board
FMC_NL: CON1.54_ (F_LVDS5_N); also elsewhere on the board
FMC_NOE: CON1.63_F_LVDS_CK0_P (F_LVDS_CK0_P); also elsewhere on the board
FMC_NWAIT: CON1.56_ (F_LVDS8_N); also elsewhere on the board
FMC_NWE: CON1.66_ (F_LVDS10_N); also elsewhere on the board
GND: CON1.GND1 (GND), CON1.GND2 (GND), CON1.GND3 (GND), CON1.GND4 (GND), CON1.GND5 (GND), CON1.GND6 (GND), CON1.GND7 (GND), CON1.GND8 (GND), CON1.GUIDE@L (GUIDE), CON1.GUIDE@R (GUIDE), JP1.1, JP2.1; also elsewhere on the board
MINUS15V_STABLE: JP1.4; also elsewhere on the board
P-5.0V_MAIN: CON1.36_P-5.0V_MAIN (P-5.0V_MAIN), CON1.37_P-5.0V_MAIN (P-5.0V_MAIN), CON1.38_P-5.0V_MAIN (P-5.0V_MAIN), CON1.39_P-5.0V_MAIN (P-5.0V_MAIN), CON1.40_P-5.0V_MAIN (P-5.0V_MAIN); also elsewhere on the board

Notes on the sheet:
Novena FPGA connector
Extra

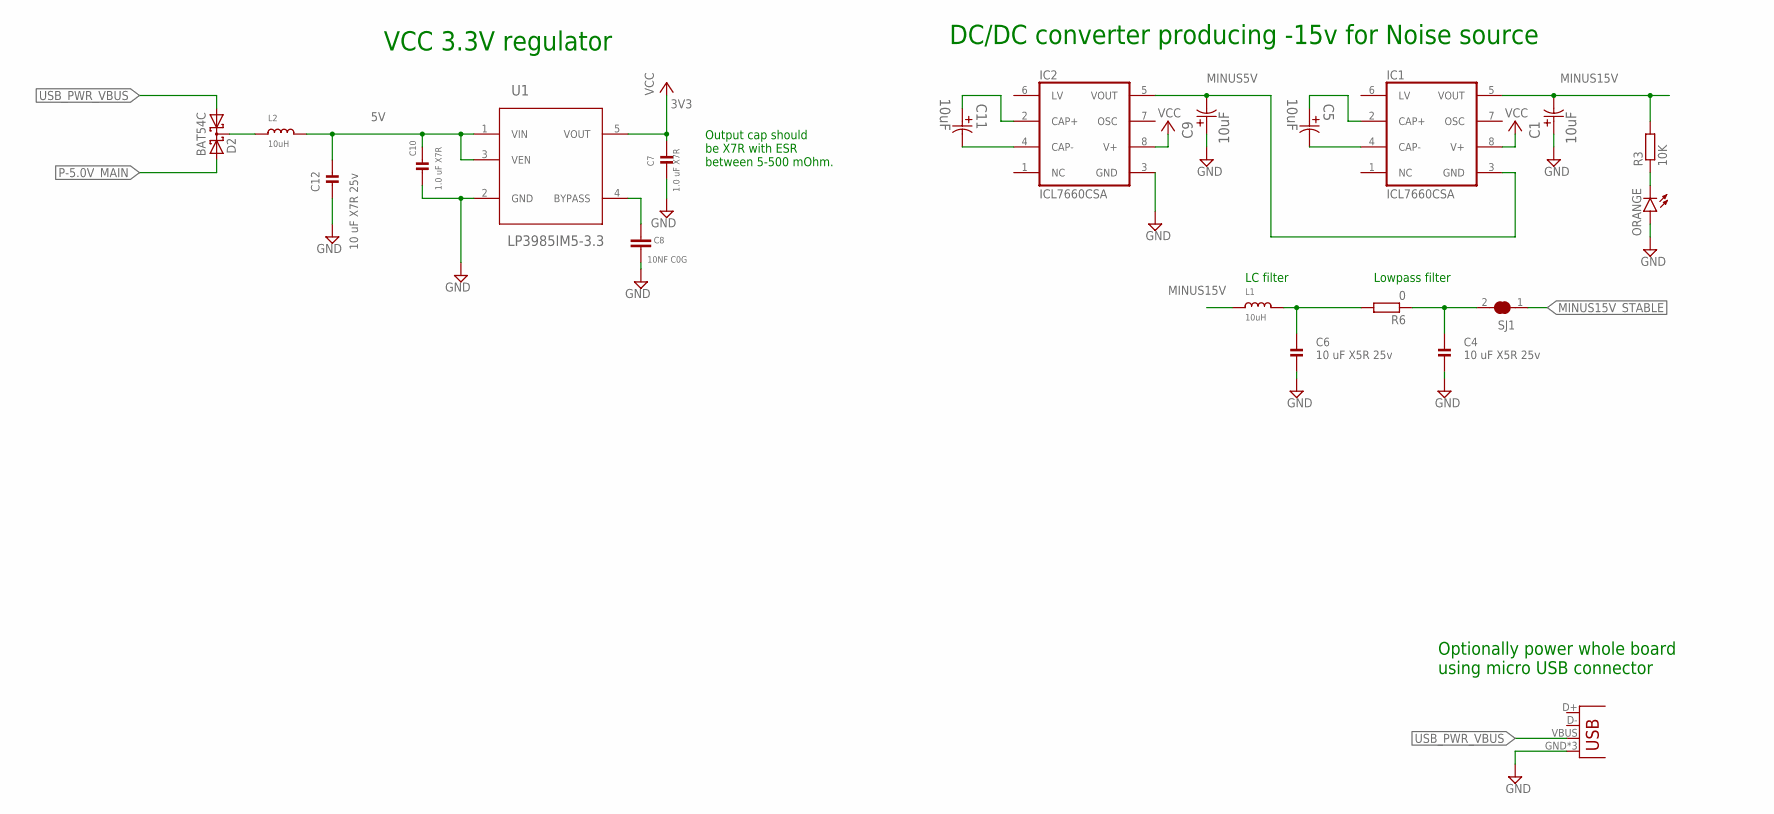
[picture p59: schematic rev01.sch, sheet 2, Power]

Parts:
C1, C5, C9, C11: 10uF; CAPAE530X610N_BIG_PADS
C4, C6: 10 uF X5R 25v; _0805
C7, C10: 1.0 uF X7R; 0805
C8: 10NF C0G; C0603
C12: 10 uF X7R 25v; 0805
D2: BAT54C; SOT23
IC1, IC2: ICL7660CSA; SO08
L1, L2: 10uH; _0805
ORANGE: LEDAMBER0603; LED-0603
R3: 10K; R0603
R6: 0; R0603
SJ1: SOLDERJUMPER_CLOSED; SOLDERJUMPER_CLOSEDWIRE@1
U1: LP3985IM5-3.3; SOT95P300X120-5N
USB_PWR: USB-MICROB

Connections:
3V3: C7.1, U1.5 (VOUT); also elsewhere on the board
5V: C10.1, C12.1, IC1.8 (V+), IC2.8 (V+), L2.2, U1.1 (VIN), U1.3 (VEN); also elsewhere on the board
GND: C1.1, C4.2, C6.2, C7.2, C8.1, C9.1, C10.2, C12.2, IC2.3 (GND), ORANGE.A, U1.2 (GND), USB_PWR.GND, USB_PWR.MT1 (GND), USB_PWR.MT2 (GND); also elsewhere on the board
MINUS5V: C9.2, IC1.3 (GND), IC2.5 (VOUT)
MINUS15V: C1.2, IC1.5 (VOUT), L1.1, R3.2
MINUS15V_STABLE: SJ1.1; also elsewhere on the board
unnamed: C5.2, IC1.4 (CAP-)
unnamed: C11.2, IC2.4 (CAP-)
unnamed: C11.1, IC2.2 (CAP+)
unnamed: C4.1, R6.1, SJ1.2
unnamed: ORANGE.C, R3.1
unnamed: C8.2, U1.4 (BYPASS)
unnamed: C5.1, IC1.2 (CAP+)
unnamed: C6.1, L1.2, R6.2
unnamed: D2.3 (CC), L2.1
P-5.0V_MAIN: D2.2 (A2); also elsewhere on the board
USB_PWR_VBUS: D2.1 (A1), USB_PWR.VBUS

Notes on the sheet:
VCC 3.3V regulator
DC/DC converter producing -15v for Noise source
Lowpass filter
LC filter
Optionally power whole board using micro USB connector
Output cap should be X7R with ESR between 5-500 mOhm.
