vgisc/cryptech.hardware/cad/rev01/rev01.brd

## EAGLE design cad/rev01/rev01.brd (continued)

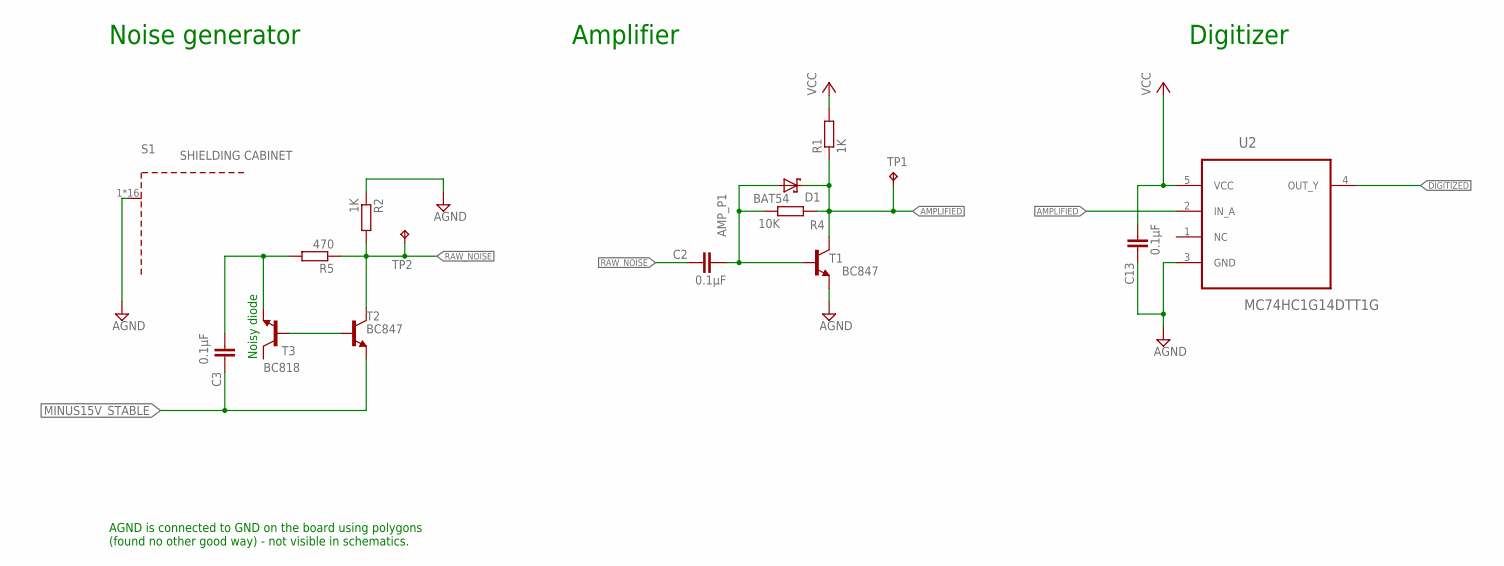
[picture p60: schematic rev01.sch, sheet 3, Noise source]

Parts:
C2, C3, C13: 0.1µF; C0603
D1: BAT54; SOT23
R1, R2: 1K; R0603
R4: 10K; R0603
R5: 470; R0603
S1: SHIELDING CABINET; WE-SHC_36103205_NO_CREAM
T1, T2: BC847; SOT23
T3: BC818; SOT23-BEC
TP1, TP2: TPB1,27; B1,27
U2: MC74HC1G14DTT1G; SOT95P275X110-5N

Connections:
3V3: C13.2, R1.2, U2.5 (VCC); also elsewhere on the board
AGND: C13.1, R2.1, S1.1, S1.2, S1.3, S1.4, S1.5, S1.6, S1.7, S1.8, S1.9, S1.10, S1.11, S1.12, S1.13, S1.14, S1.15, S1.16, T1.2 (E), U2.3 (GND)
AMPLIFIED: D1.3 (C), R1.1, R4.2, T1.3 (C), TP1.TP, U2.2 (IN_A)
AMP_P1: C2.2, D1.1 (A), R4.1, T1.1 (B)
DIGITIZED: U2.4 (OUT_Y); also elsewhere on the board
MINUS15V_STABLE: C3.1, T2.2 (E); also elsewhere on the board
NOISE_IN: C3.2, R5.2, T3.E
NOISE_OUT: T2.1 (B), T3.B
RAW_NOISE: C2.1, R2.2, R5.1, T2.3 (C), TP2.TP

Notes on the sheet:
Digitizer
Noise generator
Noisy diode
Amplifier
AGND is connected to GND on the board using polygons (found no other good way) - not visible in schematics.

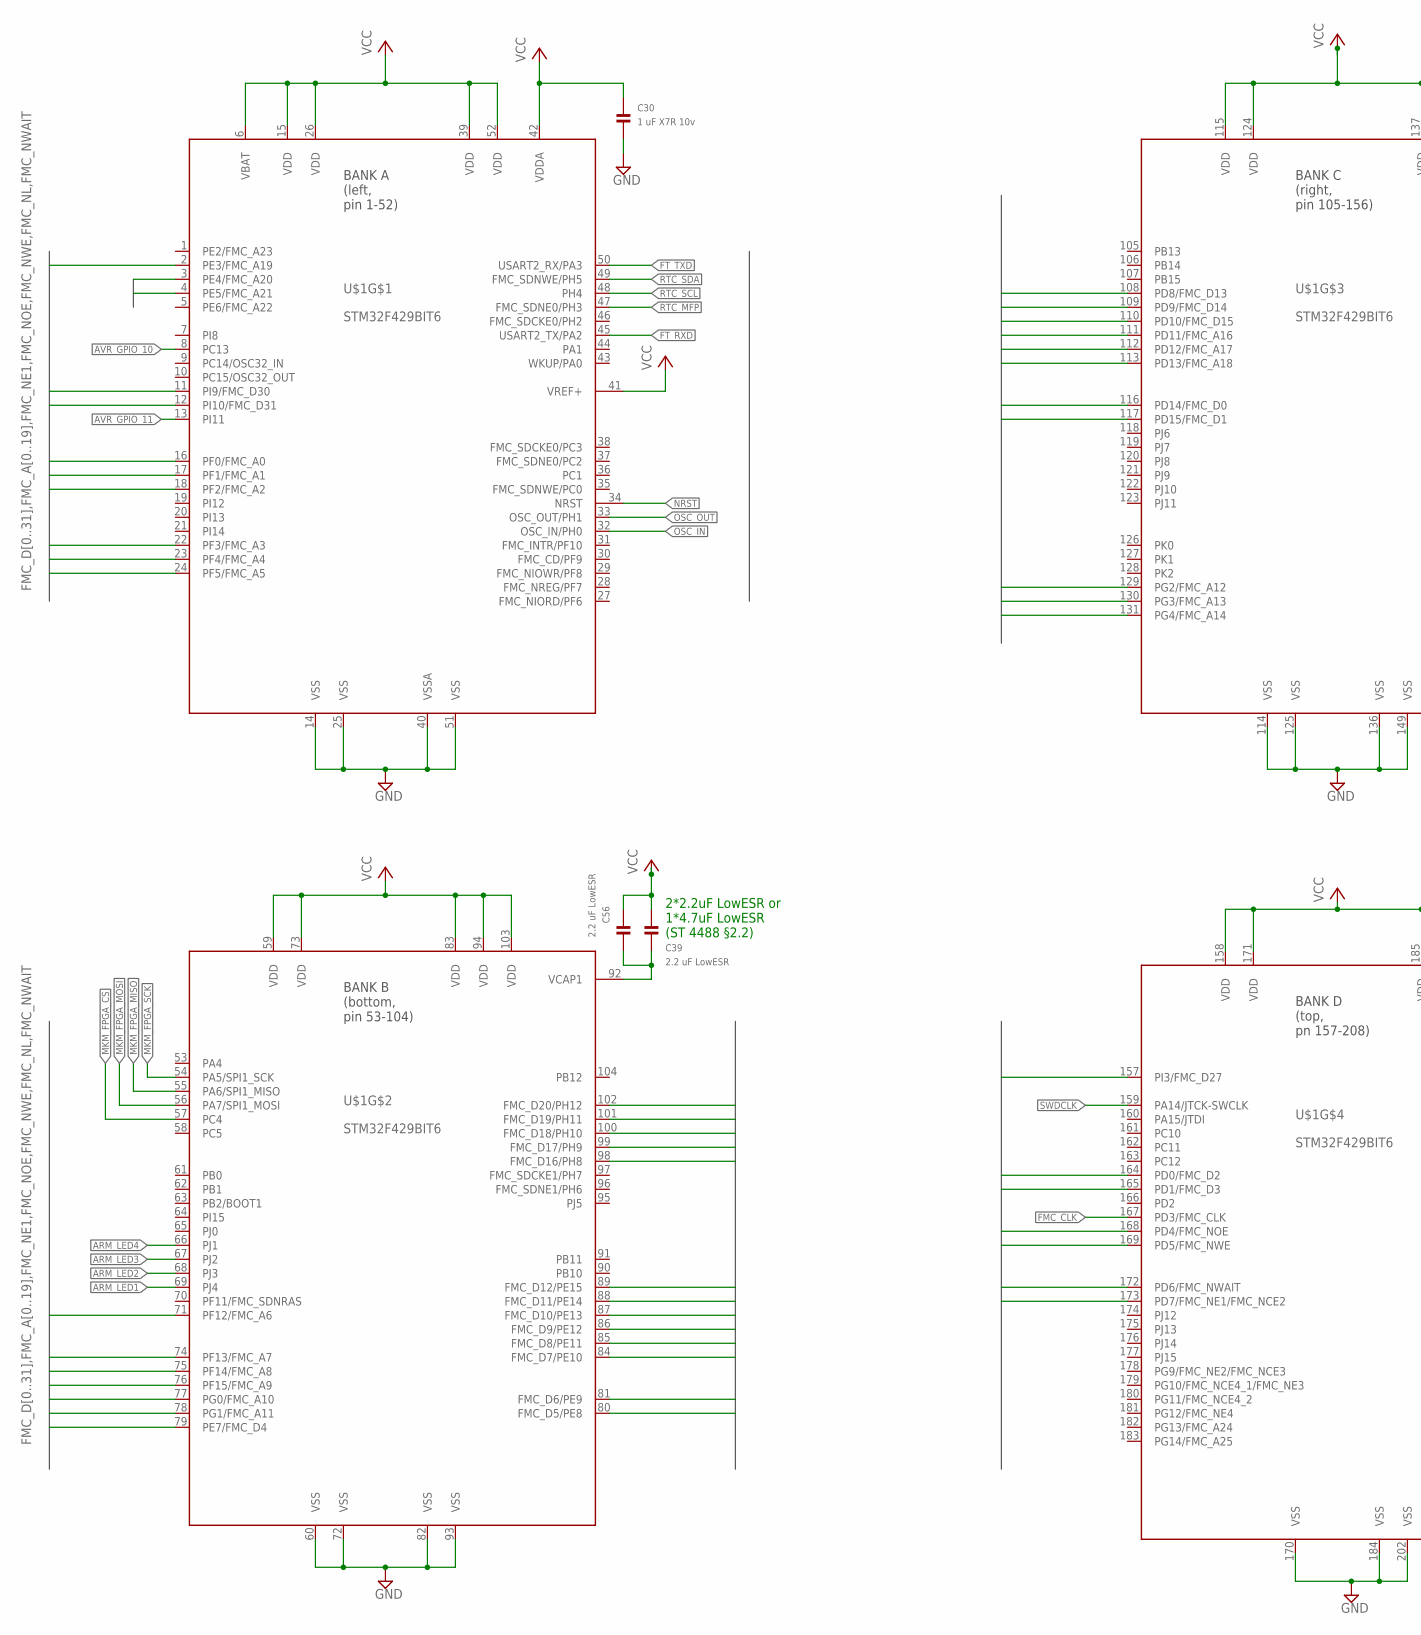
[picture p61: schematic rev01.sch, sheet 4, ARM Cortex-M4, part in row 1, column 1]

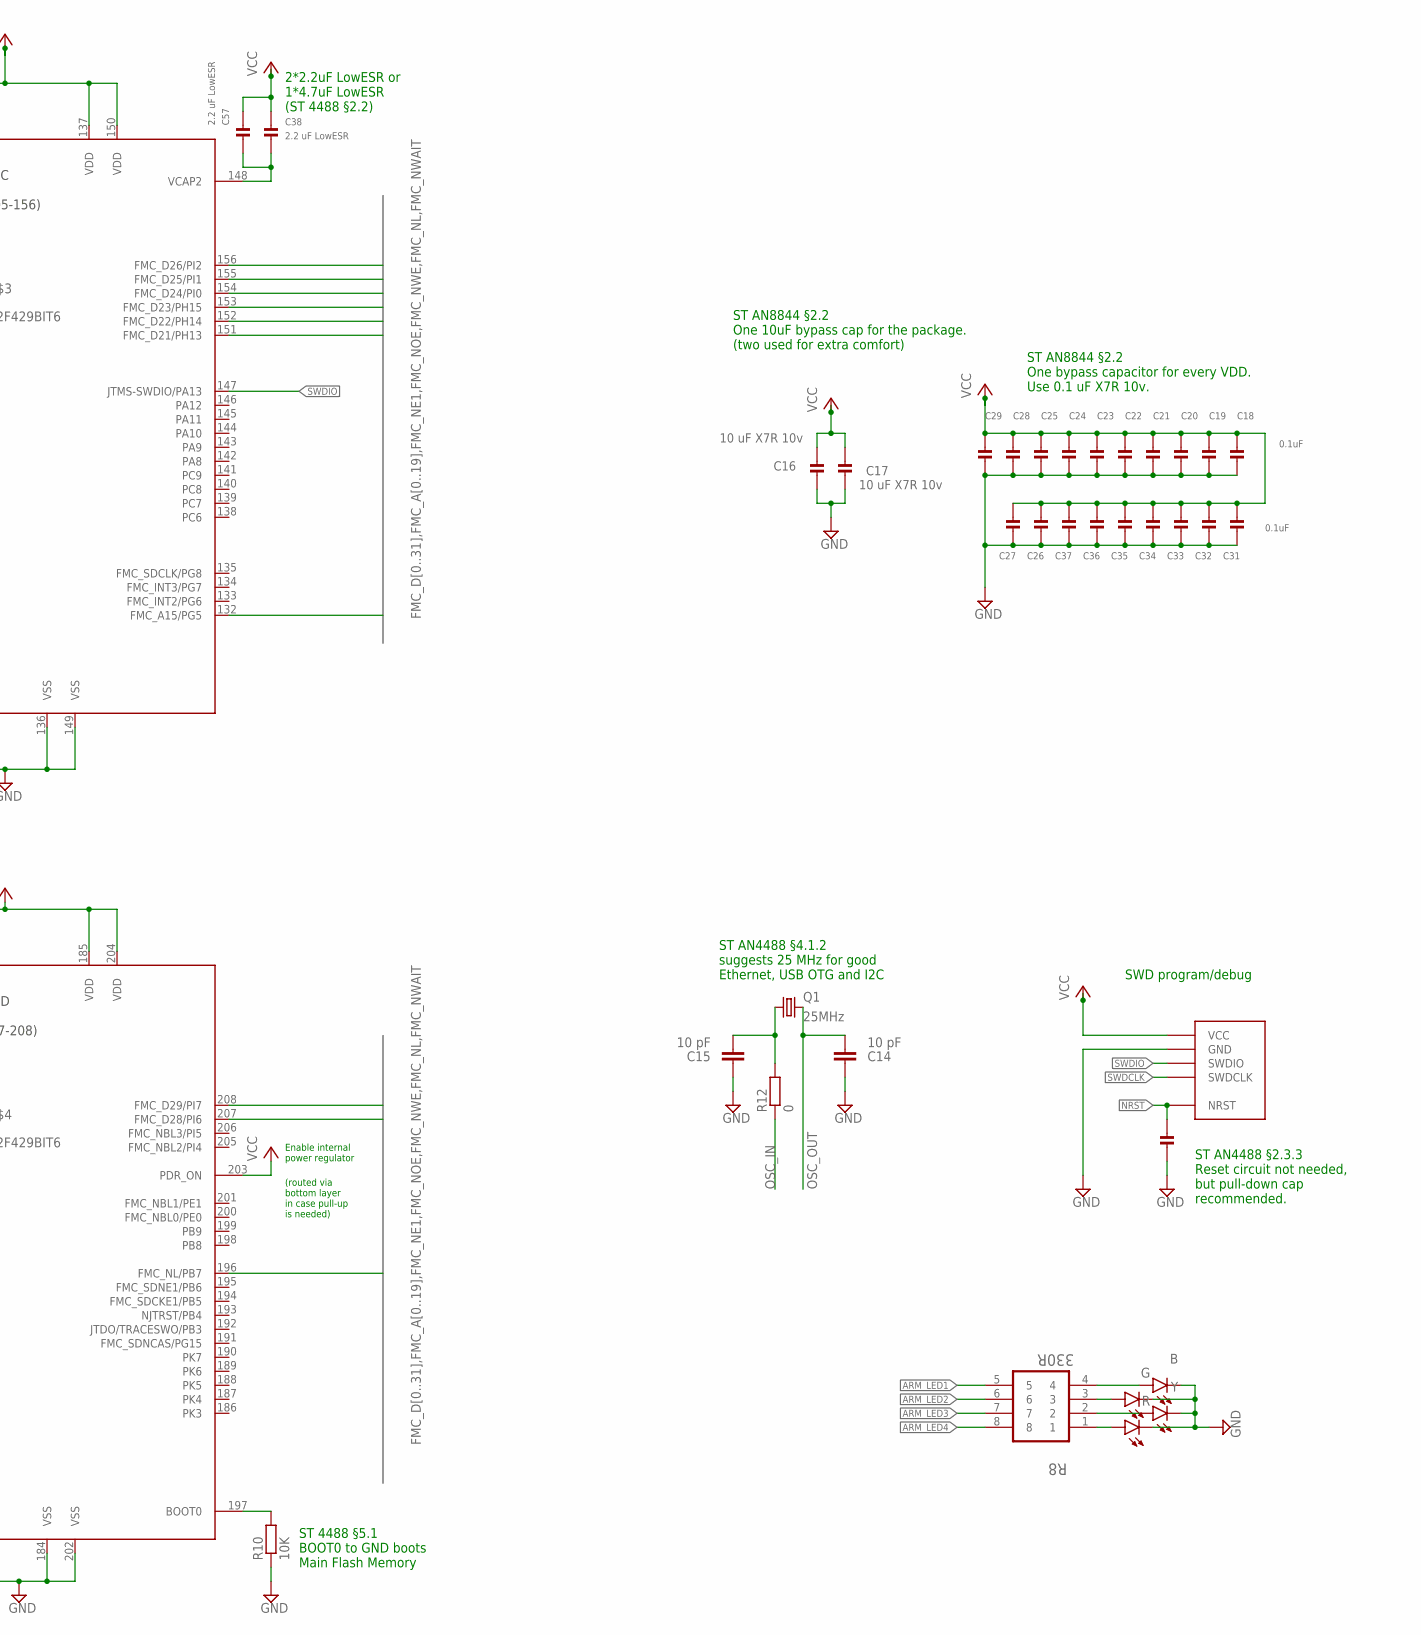
[picture p62: schematic rev01.sch, sheet 4, ARM Cortex-M4, part in row 1, column 2]

Parts:
C14, C15: 10 pF; C0603
C16, C17: 10 uF X7R 10v; 0805
C18, C19, C20, C21, C22, C23, C24, C25, C26, C27, C28, C29, C31, C32, C33, C34, C35, C36, C37, C40: 0.1uF; 0603
C30: 1 uF X7R 10v; 0603
C38, C39, C56, C57: 2.2 uF LowESR; 0603
LED5: B; LED-0603
LED6: G; LED-0603
LED7: Y; LED-0603
LED8: R; LED-0603
Q1: 25MHz; CTS406
R8: 330R; RESCAXE80P320X160X60-8N
R10: 10K; R0603
R12: 0; R0603
U$1: STM32F429BIT6; LQFP-208
U$2: STM32-SWD; 100MIL_THT

Connections:
3V3: C16.1, C17.1, C18.1, C19.1, C20.1, C21.1, C22.1, C23.1, C24.1, C25.1, C26.1, C27.1, C28.1, C29.1, C30.1, C31.1, C32.1, C33.1, C34.1, C35.1, C36.1, C37.1, C38.1, C39.1, C56.1, C57.1, U$1.6 (VBAT), U$1.15 (VDD), U$1.26 (VDD), U$1.39 (VDD), U$1.41 (VREF+), U$1.42 (VDDA), U$1.52 (VDD), U$1.59 (VDD), U$1.73 (VDD), U$1.83 (VDD), U$1.94 (VDD), U$1.103 (VDD), U$1.115 (VDD), U$1.124 (VDD), U$1.137 (VDD), U$1.150 (VDD), U$1.158 (VDD), U$1.171 (VDD), U$1.185 (VDD), U$1.203 (PDR_ON), U$1.204 (VDD), U$2.P$VCC (VCC); also elsewhere on the board
ARM_LED1: R8.5, U$1.69 (PJ4)
ARM_LED2: R8.6, U$1.68 (PJ3)
ARM_LED3: R8.7, U$1.67 (PJ2)
ARM_LED4: R8.8, U$1.66 (PJ1)
AVR_GPIO_10: U$1.8 (PC13); also elsewhere on the board
AVR_GPIO_11: U$1.13 (PI11); also elsewhere on the board
BOOT0: R10.2, U$1.197 (BOOT0)
FMC_A0: U$1.16 (PF0/FMC_A0); also elsewhere on the board
FMC_A1: U$1.17 (PF1/FMC_A1); also elsewhere on the board
FMC_A2: U$1.18 (PF2/FMC_A2); also elsewhere on the board
FMC_A3: U$1.22 (PF3/FMC_A3); also elsewhere on the board
FMC_A4: U$1.23 (PF4/FMC_A4); also elsewhere on the board
FMC_A5: U$1.24 (PF5/FMC_A5); also elsewhere on the board
FMC_A6: U$1.71 (PF12/FMC_A6); also elsewhere on the board
FMC_A7: U$1.74 (PF13/FMC_A7); also elsewhere on the board
FMC_A8: U$1.75 (PF14/FMC_A8); also elsewhere on the board
FMC_A9: U$1.76 (PF15/FMC_A9); also elsewhere on the board
FMC_A10: U$1.77 (PG0/FMC_A10); also elsewhere on the board
FMC_A11: U$1.78 (PG1/FMC_A11); also elsewhere on the board
FMC_A12: U$1.129 (PG2/FMC_A12); also elsewhere on the board
FMC_A13: U$1.130 (PG3/FMC_A13); also elsewhere on the board
FMC_A14: U$1.131 (PG4/FMC_A14); also elsewhere on the board
FMC_A15: U$1.132 (FMC_A15/PG5); also elsewhere on the board
FMC_A16: U$1.111 (PD11/FMC_A16); also elsewhere on the board
FMC_A17: U$1.112 (PD12/FMC_A17); also elsewhere on the board
FMC_A18: U$1.113 (PD13/FMC_A18); also elsewhere on the board
FMC_A19: U$1.2 (PE3/FMC_A19); also elsewhere on the board
FMC_A20: U$1.3 (PE4/FMC_A20); also elsewhere on the board
FMC_A21: U$1.4 (PE5/FMC_A21); also elsewhere on the board
FMC_CLK: U$1.167 (PD3/FMC_CLK); also elsewhere on the board
FMC_D0: U$1.116 (PD14/FMC_D0); also elsewhere on the board
FMC_D1: U$1.117 (PD15/FMC_D1); also elsewhere on the board
FMC_D2: U$1.164 (PD0/FMC_D2); also elsewhere on the board
FMC_D3: U$1.165 (PD1/FMC_D3); also elsewhere on the board
FMC_D4: U$1.79 (PE7/FMC_D4); also elsewhere on the board
FMC_D5: U$1.80 (FMC_D5/PE8); also elsewhere on the board
FMC_D6: U$1.81 (FMC_D6/PE9); also elsewhere on the board
FMC_D7: U$1.84 (FMC_D7/PE10); also elsewhere on the board
FMC_D8: U$1.85 (FMC_D8/PE11); also elsewhere on the board
FMC_D9: U$1.86 (FMC_D9/PE12); also elsewhere on the board
FMC_D10: U$1.87 (FMC_D10/PE13); also elsewhere on the board
FMC_D11: U$1.88 (FMC_D11/PE14); also elsewhere on the board
FMC_D12: U$1.89 (FMC_D12/PE15); also elsewhere on the board
FMC_D13: U$1.108 (PD8/FMC_D13); also elsewhere on the board
FMC_D14: U$1.109 (PD9/FMC_D14); also elsewhere on the board
FMC_D15: U$1.110 (PD10/FMC_D15); also elsewhere on the board
FMC_D16: U$1.98 (FMC_D16/PH8); also elsewhere on the board
FMC_D17: U$1.99 (FMC_D17/PH9); also elsewhere on the board
FMC_D18: U$1.100 (FMC_D18/PH10); also elsewhere on the board
FMC_D19: U$1.101 (FMC_D19/PH11); also elsewhere on the board
FMC_D20: U$1.102 (FMC_D20/PH12); also elsewhere on the board
FMC_D21: U$1.151 (FMC_D21/PH13); also elsewhere on the board
FMC_D22: U$1.152 (FMC_D22/PH14); also elsewhere on the board
FMC_D23: U$1.153 (FMC_D23/PH15); also elsewhere on the board
FMC_D24: U$1.154 (FMC_D24/PI0); also elsewhere on the board
FMC_D25: U$1.155 (FMC_D25/PI1); also elsewhere on the board
FMC_D26: U$1.156 (FMC_D26/PI2); also elsewhere on the board
FMC_D27: U$1.157 (PI3/FMC_D27); also elsewhere on the board
FMC_D28: U$1.207 (FMC_D28/PI6); also elsewhere on the board
FMC_D29: U$1.208 (FMC_D29/PI7); also elsewhere on the board
FMC_D30: U$1.11 (PI9/FMC_D30); also elsewhere on the board
FMC_D31: U$1.12 (PI10/FMC_D31); also elsewhere on the board
FMC_NE1: U$1.173 (PD7/FMC_NE1/FMC_NCE2); also elsewhere on the board
FMC_NL: U$1.196 (FMC_NL/PB7); also elsewhere on the board
FMC_NOE: U$1.168 (PD4/FMC_NOE); also elsewhere on the board
FMC_NWAIT: U$1.172 (PD6/FMC_NWAIT); also elsewhere on the board
FMC_NWE: U$1.169 (PD5/FMC_NWE); also elsewhere on the board
FT_RXD: U$1.45 (USART2_TX/PA2); also elsewhere on the board
FT_TXD: U$1.50 (USART2_RX/PA3); also elsewhere on the board
GND: C14.1, C15.1, C16.2, C17.2, C18.2, C19.2, C20.2, C21.2, C22.2, C23.2, C24.2, C25.2, C26.2, C27.2, C28.2, C29.2, C30.2, C31.2, C32.2, C33.2, C34.2, C35.2, C36.2, C37.2, C40.2, LED5.C, LED6.C, LED7.C, LED8.C, R10.1, U$1.14 (VSS), U$1.25 (VSS), U$1.40 (VSSA), U$1.51 (VSS), U$1.60 (VSS), U$1.72 (VSS), U$1.82 (VSS), U$1.93 (VSS), U$1.114 (VSS), U$1.125 (VSS), U$1.136 (VSS), U$1.149 (VSS), U$1.170 (VSS), U$1.184 (VSS), U$1.202 (VSS), U$2.P$GND (GND); also elsewhere on the board
MKM_FPGA_CS: U$1.57 (PC4); also elsewhere on the board
MKM_FPGA_MISO: U$1.55 (PA6/SPI1_MISO); also elsewhere on the board
MKM_FPGA_MOSI: U$1.56 (PA7/SPI1_MOSI); also elsewhere on the board
MKM_FPGA_SCK: U$1.54 (PA5/SPI1_SCK); also elsewhere on the board
unnamed: LED5.A, R8.4
unnamed: LED6.A, R8.3
unnamed: LED7.A, R8.2
unnamed: LED8.A, R8.1
unnamed: C15.2, Q1.1, R12.2
NRST: C40.1, U$1.34 (NRST), U$2.P$NRST (NRST)
OSC_IN: R12.1, U$1.32 (OSC_IN/PH0)
OSC_OUT: C14.2, Q1.3 (2), U$1.33 (OSC_OUT/PH1)
RTC_MFP: U$1.47 (FMC_SDNE0/PH3); also elsewhere on the board
RTC_SCL: U$1.48 (PH4); also elsewhere on the board
RTC_SDA: U$1.49 (FMC_SDNWE/PH5); also elsewhere on the board
SWDCLK: U$1.159 (PA14/JTCK-SWCLK), U$2.P$SWDCLK (SWDCLK)
SWDIO: U$1.147 (JTMS-SWDIO/PA13), U$2.P$SWDIO (SWDIO)
VCAP1: C39.2, C56.2, U$1.92 (VCAP1)
VCAP2: C38.2, C57.2, U$1.148 (VCAP2)

Notes on the sheet:
ST AN8844 §2.2 One bypass capacitor for every VDD. Use 0.1 uF X7R 10v.
ST AN8844 §2.2 One 10uF bypass cap for the package. (two used for extra comfort)
2*2.2uF LowESR or 1*4.7uF LowESR (ST 4488 §2.2)
ST 4488 §5.1 BOOT0 to GND boots Main Flash Memory
ST AN4488 §4.1.2 suggests 25 MHz for good Ethernet, USB OTG and I2C
SWD program/debug
ST AN4488 §2.3.3 Reset circuit not needed, but pull-down cap recommended.
Enable internal power regulator
(routed via bottom layer in case pull-up is needed)

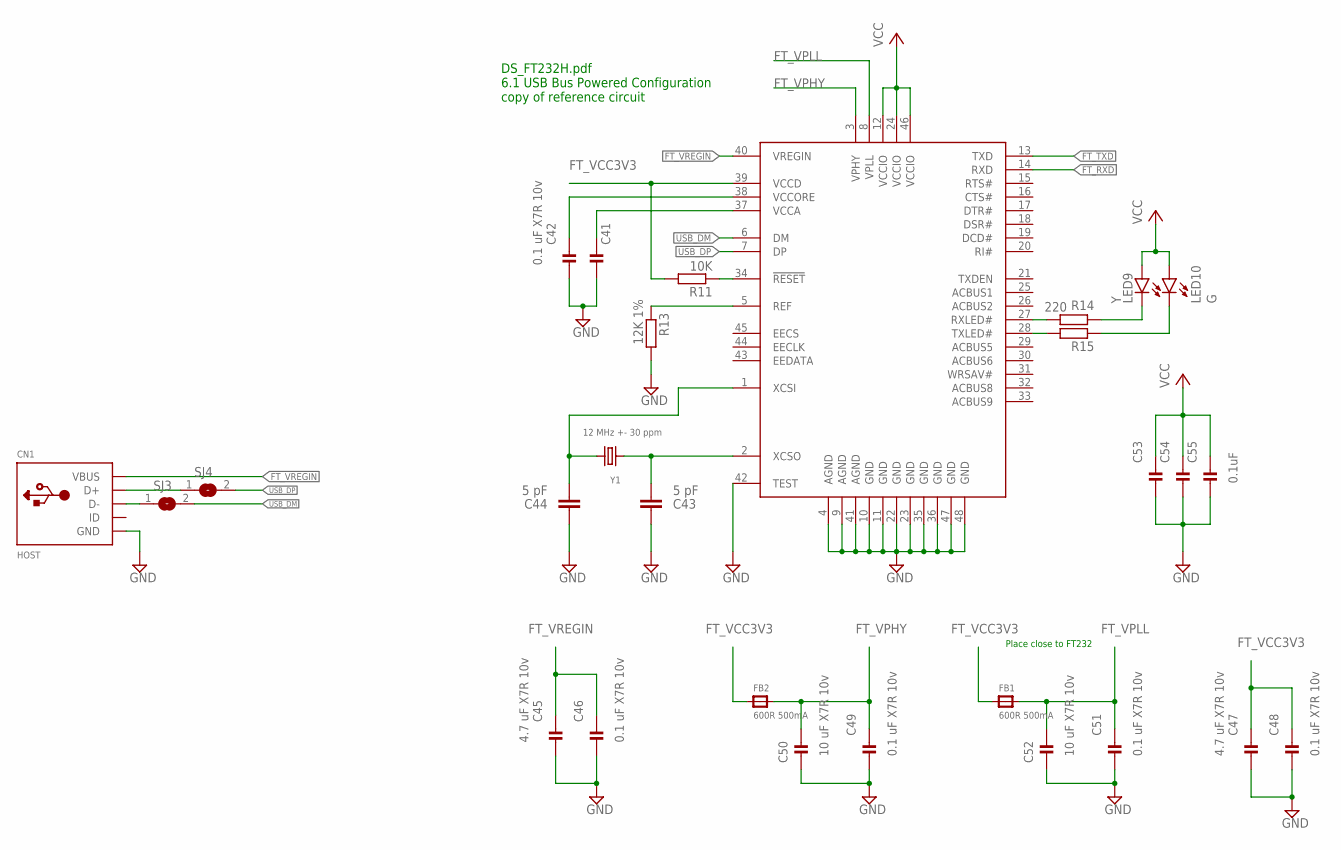
[picture p63: schematic rev01.sch, sheet 5, USB-UART interface]

Parts:
C41, C42, C46, C48, C49, C51: 0.1 uF X7R 10v; 0603
C43, C44: 5 pF; C0603
C45, C47: 4.7 uF X7R 10v; 0603
C50, C52: 10 uF X7R 10v; _0805
C53, C54, C55: 0.1uF; 0603
CN1: HOST; USB-MINIB
FB1, FB2: 600R 500mA; _0603MP
LED9: Y; LED-0603
LED10: G; LED-0603
R11: 10K; R0603
R13: 12K 1%; R0603
R14, R15: 220; R0603
SJ3, SJ4: SOLDERJUMPERCLOSED; SOLDERJUMPER_CLOSEDWIRE
U$3: FT232H_SERIAL; FT2323HL_LQFP48
Y1: 12 MHz +- 30 ppm; CRYSTAL_3.2X2.5

Connections:
FT_REF: R13.1, U$3.5 (REF)
FT_RESET: R11.1, U$3.34 (!RESET)
FT_RXD: U$3.14 (RXD); also elsewhere on the board
FT_RXLED: R14.2, U$3.27 (RXLED#)
FT_TXD: U$3.13 (TXD); also elsewhere on the board
FT_TXLED: R15.2, U$3.28 (TXLED#)
FT_VCC3V3: C47.1, C48.1, C53.1, C54.1, C55.1, FB1.1, FB2.1, LED9.A, LED10.A, R11.2, U$3.12 (VCCIO), U$3.24 (VCCIO), U$3.39 (VCCD), U$3.46 (VCCIO)
FT_VCCA: C41.1, U$3.37 (VCCA)
FT_VCCORE: C42.1, U$3.38 (VCCORE)
FT_VPHY: C49.1, C50.1, FB2.2, U$3.3 (VPHY)
FT_VPLL: C51.1, C52.1, FB1.2, U$3.8 (VPLL)
FT_VREGIN: C45.1, C46.1, CN1.VBUS, U$3.40 (VREGIN)
GND: C41.2, C42.2, C43.1, C44.1, C45.2, C46.2, C47.2, C48.2, C49.2, C50.2, C51.2, C52.2, C53.2, C54.2, C55.2, CN1.GND, R13.2, U$3.4 (AGND), U$3.9 (AGND), U$3.10 (GND), U$3.11 (GND), U$3.22 (GND), U$3.23 (GND), U$3.35 (GND), U$3.36 (GND), U$3.41 (AGND), U$3.42 (TEST), U$3.47 (GND), U$3.48 (GND); also elsewhere on the board
unnamed: C44.2, U$3.1 (XCSI), Y1.1
unnamed: C43.2, U$3.2 (XCSO), Y1.2
unnamed: LED9.C, R14.1
unnamed: LED10.C, R15.1
USBDM: CN1.D-, SJ3.1
USBDP: CN1.D+, SJ4.1
USB_DM: SJ3.2, U$3.6 (DM)
USB_DP: SJ4.2, U$3.7 (DP)

Notes on the sheet:
DS_FT232H.pdf 6.1 USB Bus Powered Configuration copy of reference circuit
Place close to FT232

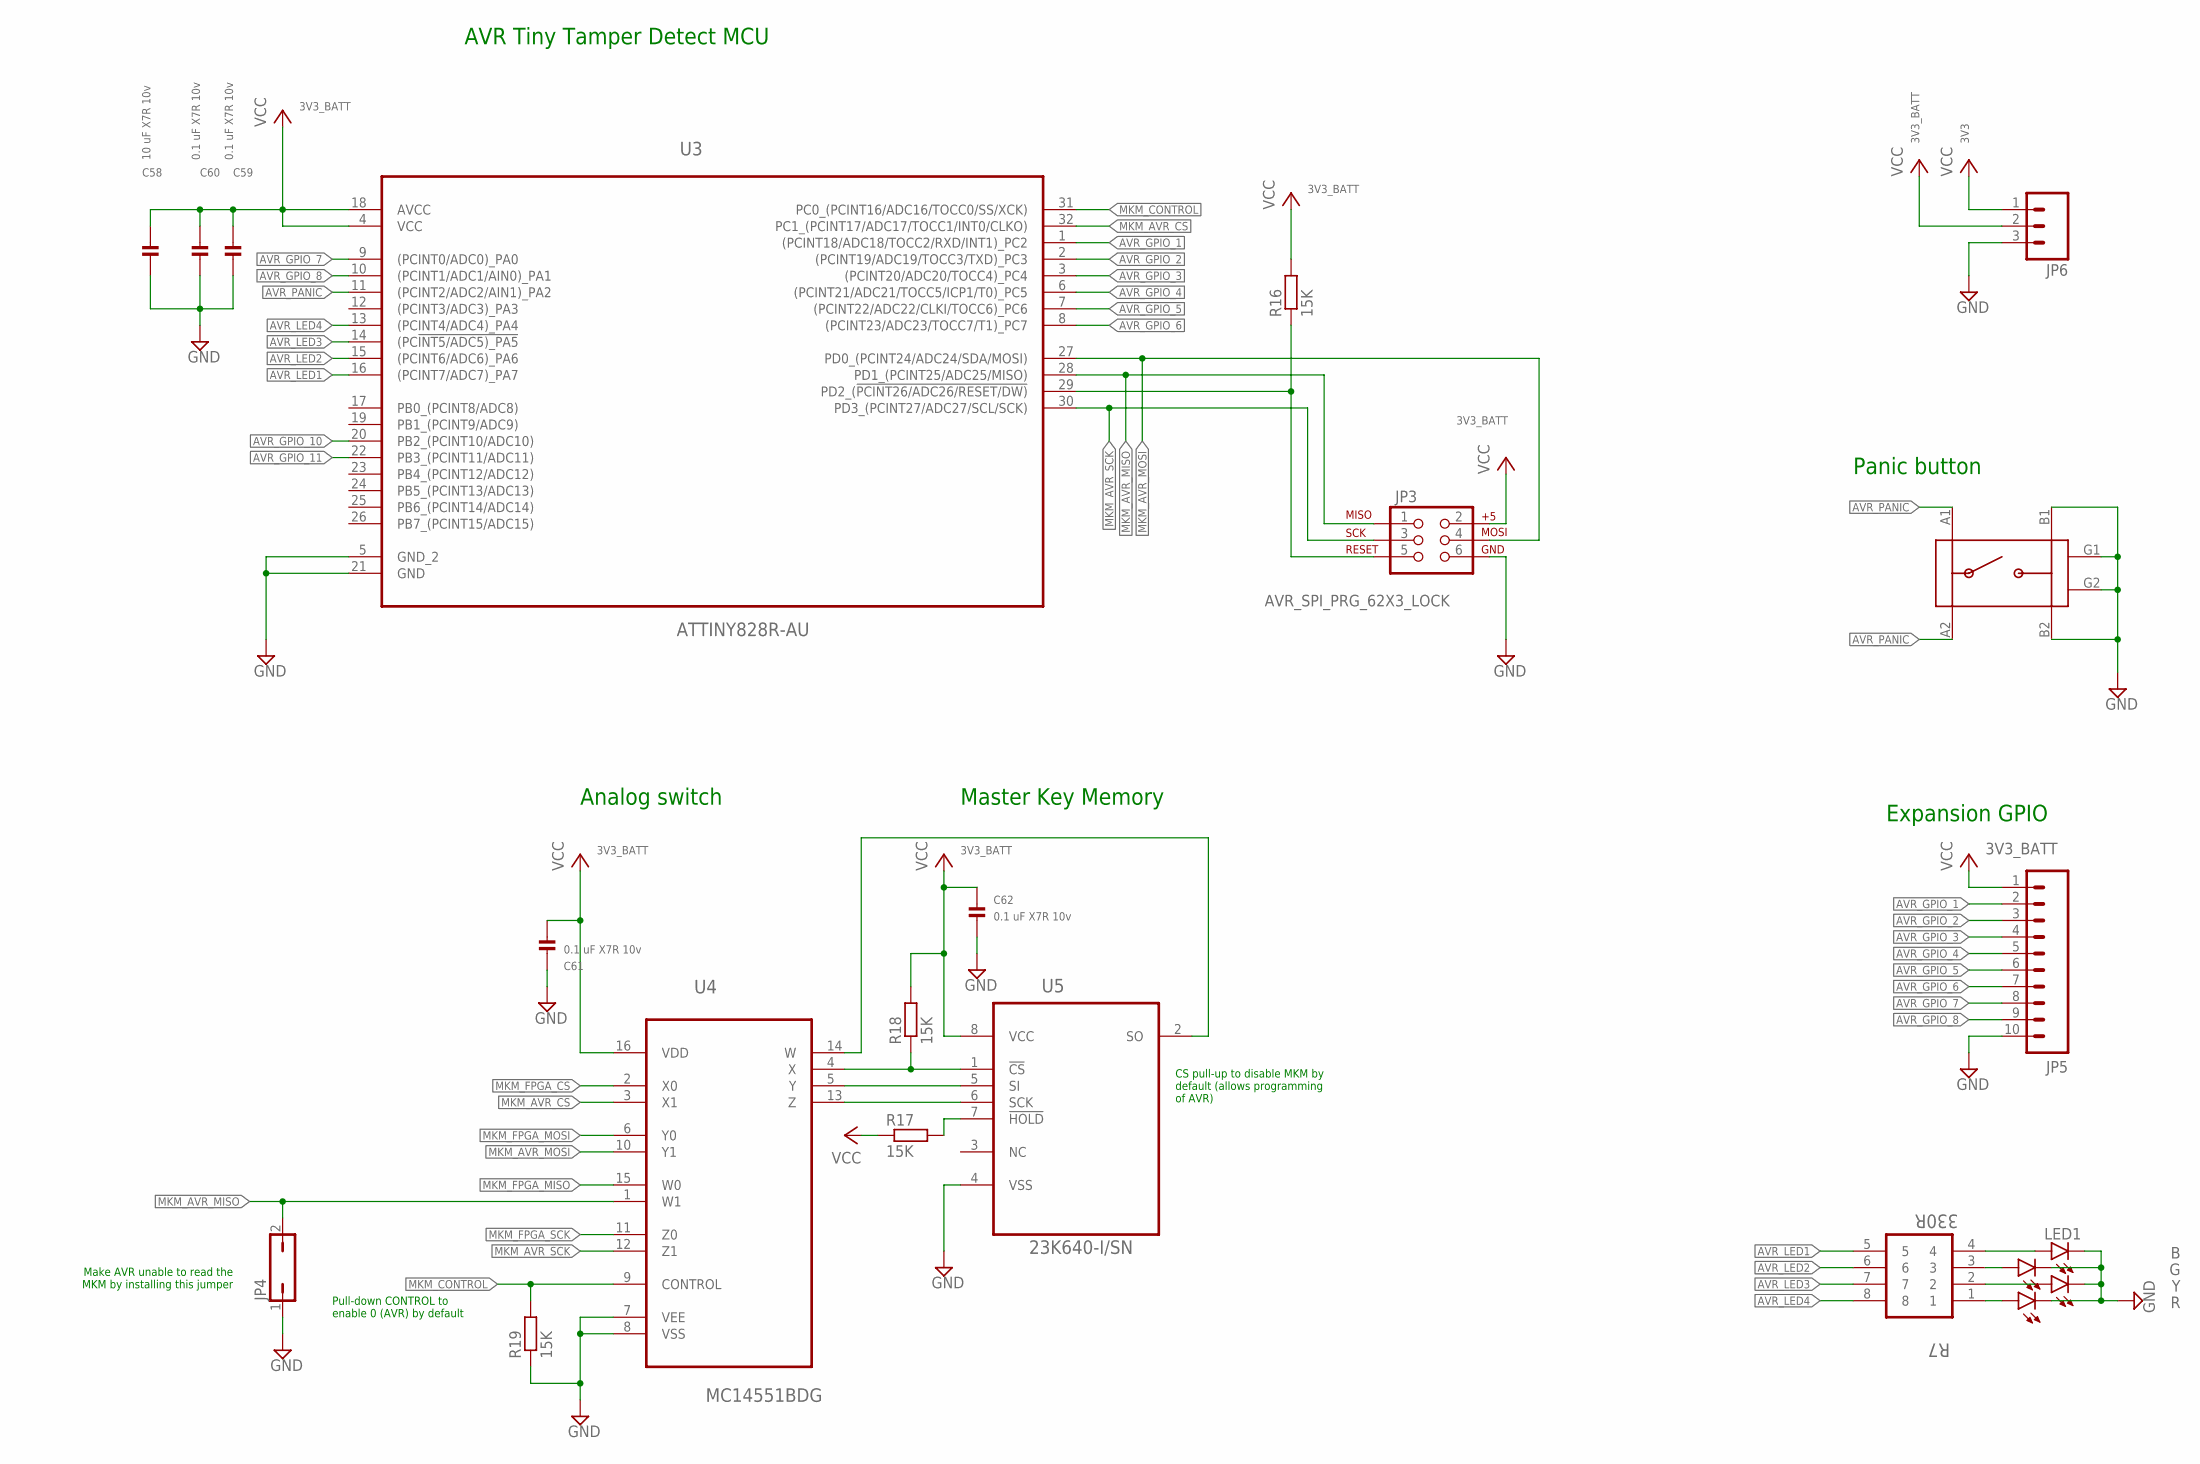
[picture p64: schematic rev01.sch, sheet 6, Tamper circuit Master Key Memory]

Parts:
C58: 10 uF X7R 10v; 0805
C59, C60, C61, C62: 0.1 uF X7R 10v; 0603
JP3: AVR_SPI_PRG_62X3_LOCK; 2X3_LOCK
JP4: JP1Q; JP1
JP5: M10LOCK; 1X10_LOCK
JP6: M03LOCK; 1X03_LOCK
LED1: B; LED-0603
LED2: G; LED-0603
LED3: Y; LED-0603
LED4: R; LED-0603
R7: 330R; RESCAXE80P320X160X60-8N
R16, R17, R18, R19: 15K; R0603
U3: ATTINY828R-AU; QFP80P900X900X120-32N
U4: MC14551BDG; SOIC127P600X175-16N
U5: 23K640-I/SN; SOIC127P600X175-8N
U$4: TACTILE_SWITCH

Connections:
3V3: JP6.1; also elsewhere on the board
3V3_BATT: C58.1, C59.1, C60.1, C61.1, C62.1, JP3.2, JP5.1, JP6.2, R16.2, R17.1, R18.2, U3.4 (VCC), U3.18 (AVCC), U4.16 (VDD), U5.8 (VCC); also elsewhere on the board
!MKM_CS: R18.1, U4.4 (X), U5.1 (!CS)
AVR_GPIO_1: JP5.2, U3.1 ((PCINT18/ADC18/TOCC2/RXD/INT1)_PC2)
AVR_GPIO_2: JP5.3, U3.2 ((PCINT19/ADC19/TOCC3/TXD)_PC3)
AVR_GPIO_3: JP5.4, U3.3 ((PCINT20/ADC20/TOCC4)_PC4)
AVR_GPIO_4: JP5.5, U3.6 ((PCINT21/ADC21/TOCC5/ICP1/T0)_PC5)
AVR_GPIO_5: JP5.6, U3.7 ((PCINT22/ADC22/CLKI/TOCC6)_PC6)
AVR_GPIO_6: JP5.7, U3.8 ((PCINT23/ADC23/TOCC7/T1)_PC7)
AVR_GPIO_7: JP5.8, U3.9 ((PCINT0/ADC0)_PA0)
AVR_GPIO_8: JP5.9, U3.10 ((PCINT1/ADC1/AIN0)_PA1)
AVR_GPIO_10: U3.20 (PB2_(PCINT10/ADC10)); also elsewhere on the board
AVR_GPIO_11: U3.22 (PB3_(PCINT11/ADC11)); also elsewhere on the board
AVR_LED1: R7.5, U3.16 ((PCINT7/ADC7)_PA7)
AVR_LED2: R7.6, U3.15 ((PCINT6/ADC6)_PA6)
AVR_LED3: R7.7, U3.14 ((PC!INT5/ADC5)_PA5)
AVR_LED4: R7.8, U3.13 ((PCINT4/ADC4)_PA4)
AVR_PANIC: U3.11 ((PCINT2/ADC2/AIN1)_PA2), U$4.A1, U$4.A2
AVR_RESET: JP3.5, R16.1, U3.29 (PD2_(!PCINT26/ADC26/RESET/DW))
GND: C58.2, C59.2, C60.2, C61.2, C62.2, JP3.6, JP4.1, JP5.10, JP6.3, LED1.C, LED2.C, LED3.C, LED4.C, R19.1, U3.5 (GND_2), U3.21 (GND), U4.7 (VEE), U4.8 (VSS), U5.4 (VSS), U$4.B1, U$4.B2, U$4.G1, U$4.G2; also elsewhere on the board
MKM_AVR_CS: U3.32 (PC1_(PCINT17/ADC17/TOCC1/INT0/CLKO)), U4.3 (X1)
MKM_AVR_MISO: JP3.1, JP4.2, U3.28 (PD1_(PCINT25/ADC25/MISO)), U4.1 (W1)
MKM_AVR_MOSI: JP3.4, U3.27 (PD0_(PCINT24/ADC24/SDA/MOSI)), U4.10 (Y1)
MKM_AVR_SCK: JP3.3, U3.30 (PD3_(PCINT27/ADC27/SCL/SCK)), U4.12 (Z1)
MKM_CONTROL: R19.2, U3.31 (PC0_(PCINT16/ADC16/TOCC0/SS/XCK)), U4.9 (CONTROL)
MKM_FPGA_CS: U4.2 (X0); also elsewhere on the board
MKM_FPGA_MISO: U4.15 (W0); also elsewhere on the board
MKM_FPGA_MOSI: U4.6 (Y0); also elsewhere on the board
MKM_FPGA_SCK: U4.11 (Z0); also elsewhere on the board
MKM_MISO: U4.14 (W), U5.2 (SO)
MKM_MOSI: U4.5 (Y), U5.5 (SI)
MKM_SCK: U4.13 (Z), U5.6 (SCK)
unnamed: LED1.A, R7.4
unnamed: LED2.A, R7.3
unnamed: LED3.A, R7.2
unnamed: LED4.A, R7.1
unnamed: R17.2, U5.7 (!HOLD)

Notes on the sheet:
CS pull-up to disable MKM by default (allows programming of AVR)
Pull-down CONTROL to enable 0 (AVR) by default
Master Key Memory
Analog switch
AVR Tiny Tamper Detect MCU
Make AVR unable to read the MKM by installing this jumper
Panic button
Expansion GPIO

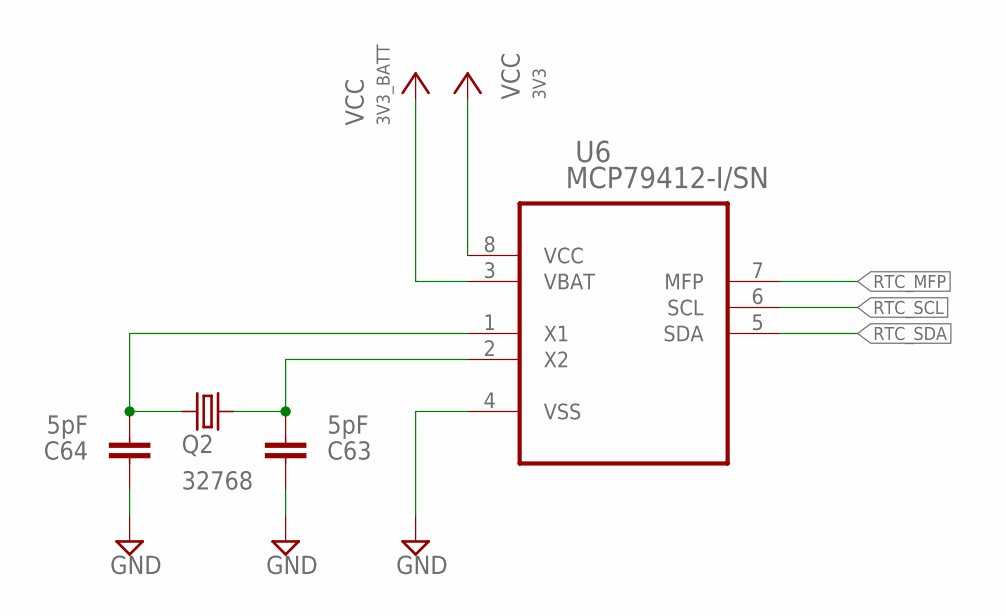
[picture p65: schematic rev01.sch, sheet 7, RTC]

Parts:
C63, C64: 5pF; C0603
Q2: 32768; TC26H
U6: MCP79412-I/SN; SOIC127P600X175-8N

Connections:
3V3: U6.8 (VCC); also elsewhere on the board
3V3_BATT: U6.3 (VBAT); also elsewhere on the board
GND: C63.1, C64.1, U6.4 (VSS); also elsewhere on the board
RTC_MFP: U6.7 (MFP); also elsewhere on the board
RTC_SCL: U6.6 (SCL); also elsewhere on the board
RTC_SDA: U6.5 (SDA); also elsewhere on the board
RTC_X1: C64.2, Q2.1, U6.1 (X1)
RTC_X2: C63.2, Q2.2, U6.2 (X2)

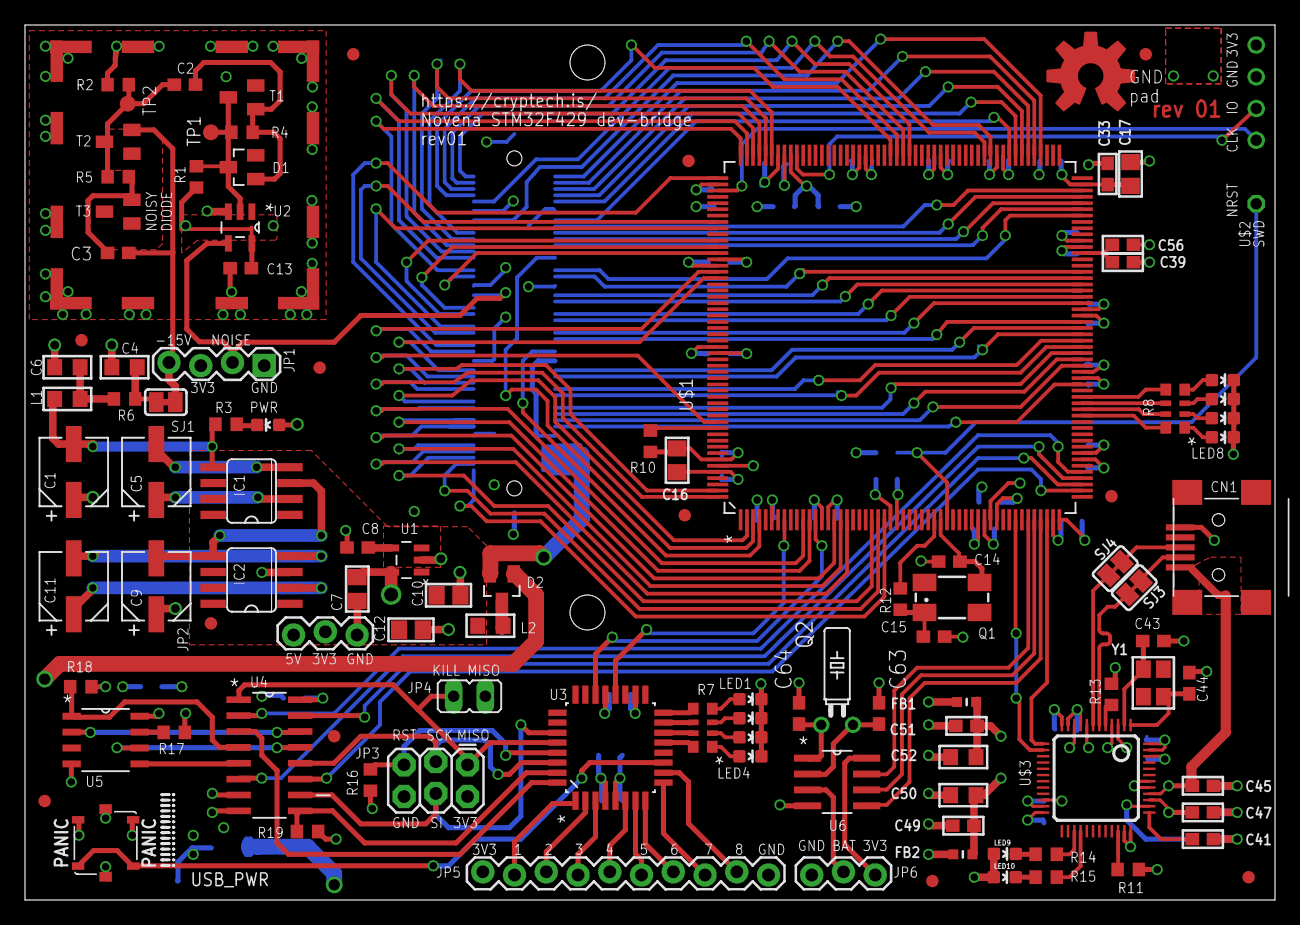
[picture p66: board rev01.brd from above]

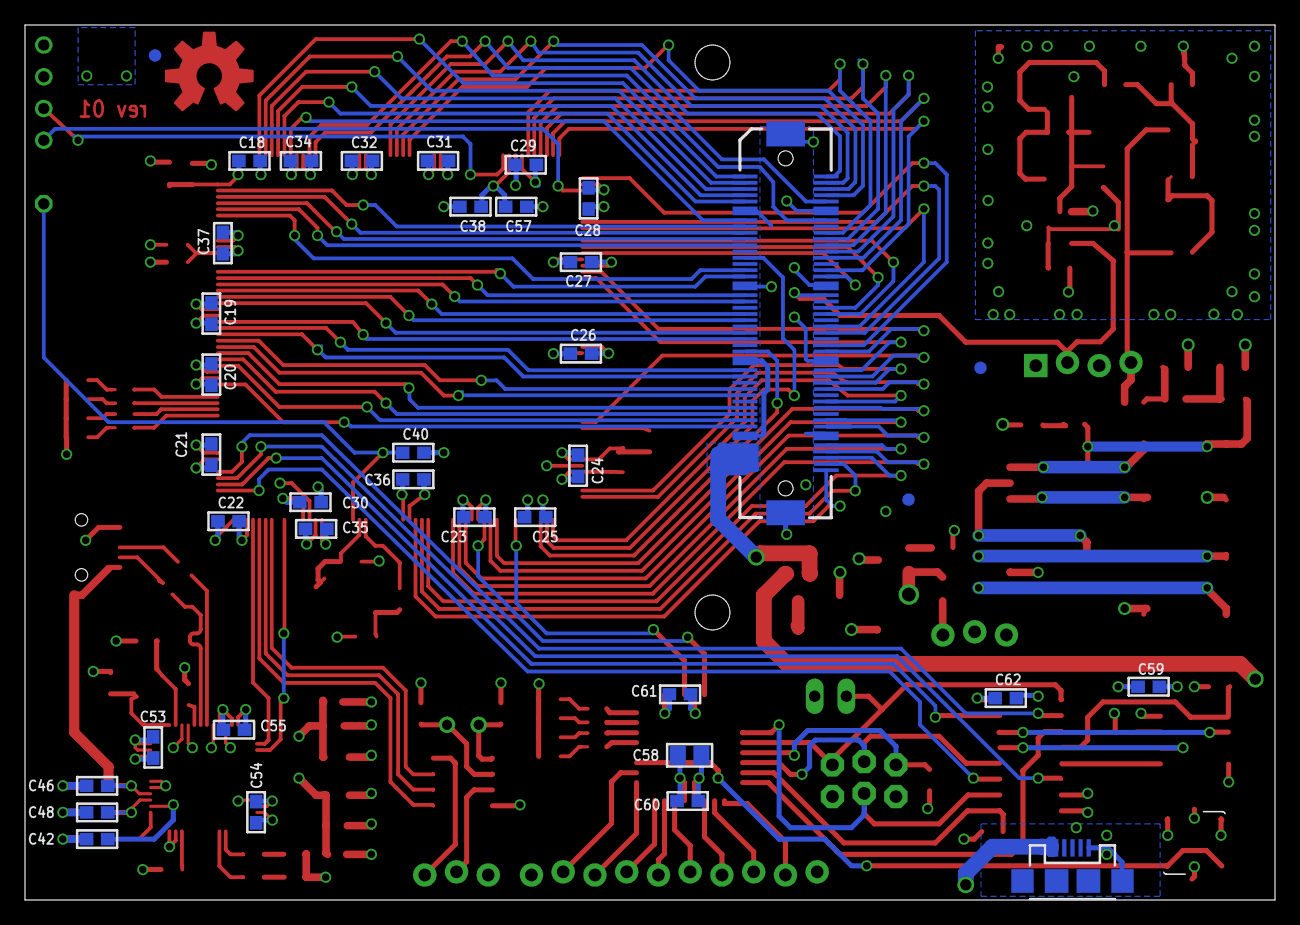
[picture p67: board rev01.brd from below]

Board: 4 copper layers, 100.0 x 70.0 mm, 148 parts (37 on the bottom side), 161 nets.
