vgisc/cryptech.hardware/(commit log)

2015-12-01 init, import dev-bridge board
    [rev01.brd, rev01.sch]
2015-12-01 init, copy of dev-bridge rev01
    [rev01.brd, rev01.sch]
2015-12-01 rename to match revision
    [rev02.brd, rev02.sch]
2015-12-01 copied in 15 sheets of FPGA design from pavel
    [rev02.sch]
2015-12-01 remove components that will not be on the Alpha board
    [rev02.brd, rev02.sch]
2015-12-01 fixed most of the FMC bus, grouped components.
    [rev02.brd, rev02.sch]
2015-12-01 more changes, end of today
    [rev02.brd, rev02.sch]
2015-12-03 fix some errata
    [rev02.brd, rev02.sch]
2015-12-04 finished merging Pavel's FPGA schematics into the dev-bridge schematics.
    [rev02.brd, rev02.sch]
2015-12-10 lots of updates after call with Pavel
    [rev02.brd, rev02.sch]
2015-12-14 add more parts of the schematic (SRAM, analog switch for config mem)
    [rev02.brd, rev02.sch]
2015-12-16 connect first SDRAM, add USB MGMT UART.
    [rev02.brd, rev02.sch]
2015-12-19 updates after todays call with Pavel
    [rev02.brd, rev02.sch]
2015-12-23 connect ARM side of SD/MMC, MGMT USB
    [rev02.brd, rev02.sch]
2015-12-27 rearrange STM32F429 symbol after functionality instead of hardware
    Now that it is more known what functionality we want to use in the STM32,
    it makes much more sense (and will help reviewers a great deal) to have
    the symbol in the schematics arranged after used functionality rather than
    after how the hardware pinout is.
    [rev02.brd, rev02.sch]
2015-12-28 add SPI mux for FPGA cfg memory, and some other minor things.
    [rev02.brd, rev02.sch]
2015-12-28 add device prefixes and renumber all components
    [rev02.brd, rev02.sch]
2015-12-28 optimize BOM a bit, change more 0603s to 0402s
    [rev02.brd, rev02.sch]
2016-01-30 First set of updates based on review feedback.
    [rev02.brd, rev02.sch]
2016-02-04 More schematic updates after review with Pavel.
    [rev02.brd, rev02.sch]
2016-02-09 Maybe final set of review feedback updates.
    [rev02.brd, rev02.sch]
2016-02-14 Add FPGA part number and pull-ups to ARM UART RXs
    [rev02-bom.csv, rev02.brd, rev02.sch]
2016-02-15 Bugfix copy-paste mistake in USB MGMT UART header.
    Also change pinout of header after input from Peter.
    [rev02.brd, rev02.sch]
2016-02-15 Update text on first page (from Joachim).
    [rev02.brd, rev02.sch]
2016-04-01 Gerber and drill files for Alpha rev02, as received from Pavel/Infotecs.
    Source is cryptech_gerbers_31032016.zip with SHA256
    15b68554ebb61d82527329f32a8ab48c396cace66ac29ff35f47bd8c977b0689
    [Stackup.xls, cryptech_28032016.brd]
2016-07-21 move to subdirectory
    [Stackup.xls, cryptech_28032016.brd]
2016-07-21 Manufacturing files for rev03, as received from Pavel.
    Source is CrypTech_Mfg_30052016.rar with SHA256
    c2206f43d93162d65830f74b7dc228d99ac1ef10c5c52b2644cd3b81dfc76def
    [Alpha_BOM_20160528.csv, Alpha_BOM_20160528.xls, Alpha_BOM_Capacitors_20160528.csv, Alpha_BOM_Capacitors_20160528.xls, Alpha_BOM_Resistors_20160528.csv, Alpha_BOM_Resistors_20160528.xls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]
2016-07-21 Altium Designer source files for rev03, as received from Pavel.
    Source is CrypTech_Project_30052016.rar with SHA256
    9d4c4401a560a3dfd69e37b5a76283ca573f91c96ae82eb587724bb610d091a7
    [CHIPS.PcbLib, Connectors.PcbLib, rev02.PcbLib, rev02.PrjPcb, rev02_0.SchDoc, rev02_1.SCHLIB, rev02_1.SchDoc, rev02_10.SchDoc]
